essensys-hub/essensys-board-SC945D/docs/hardware.md

# Hardware

Cette section détaillera la conception matérielle du SC945D.

## Composants Clés
*   **Contrôleur Graphique** : 4D Systems PICASO-GFX2
*   **MCU** : *(À préciser)*
*   **Écran** : TFT Tactile 2.8"

## PCB
*(Images du routage ou stackup à ajouter)*
