essensys-hub/essensys-board-SC945D/docs/index.md

# SC945D - Écran Tactile Domotique

Bienvenue dans la documentation technique du module **SC945D**. Ce projet s'inscrit dans l'initiative **Open Source Hardware** d'Essensys.

Le SC945D est une interface utilisateur tactile compacte destinée au pilotage de la domotique.

## Aperçu - Schéma Électronique

<div style="display: flex; gap: 10px; overflow-x: auto; padding-bottom: 10px;">
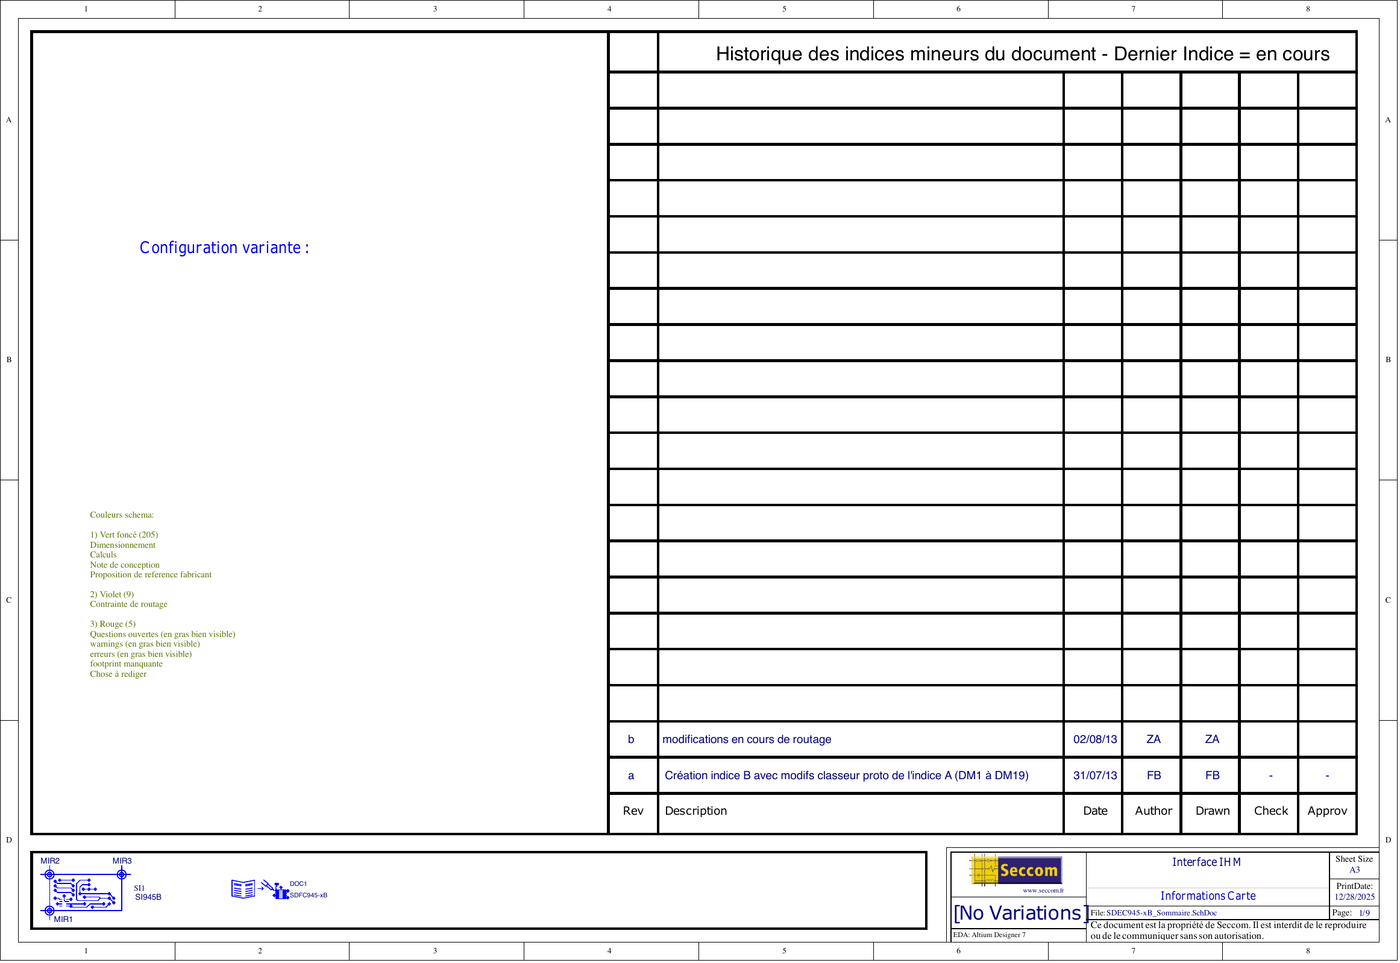
[picture p1: docs/assets/images/schematic-1.png]
Page 1
  
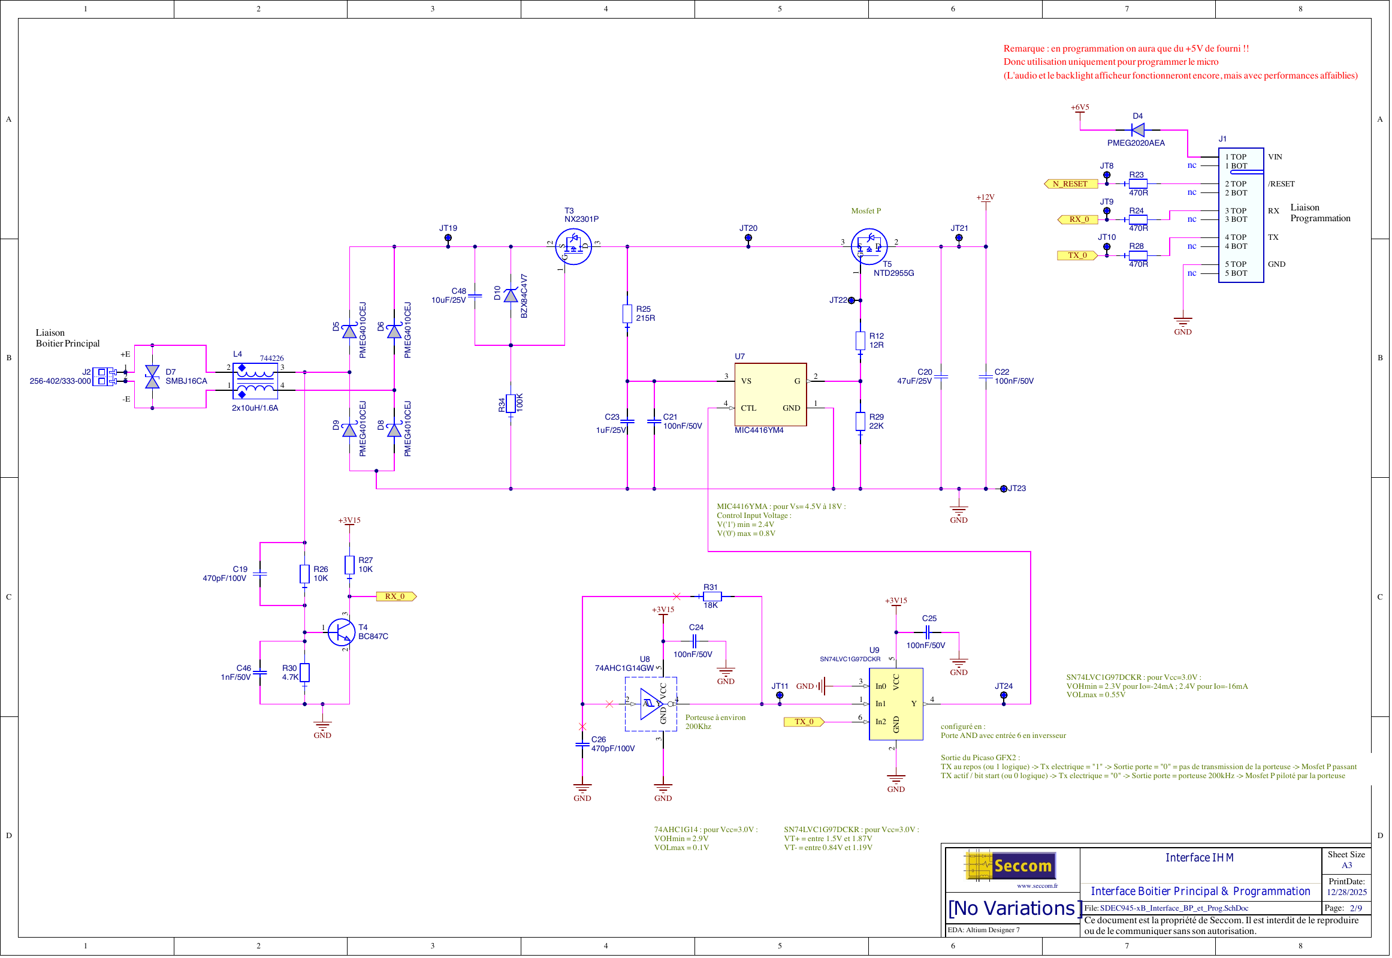
[picture p2: docs/assets/images/schematic-2.png]
Page 2
  
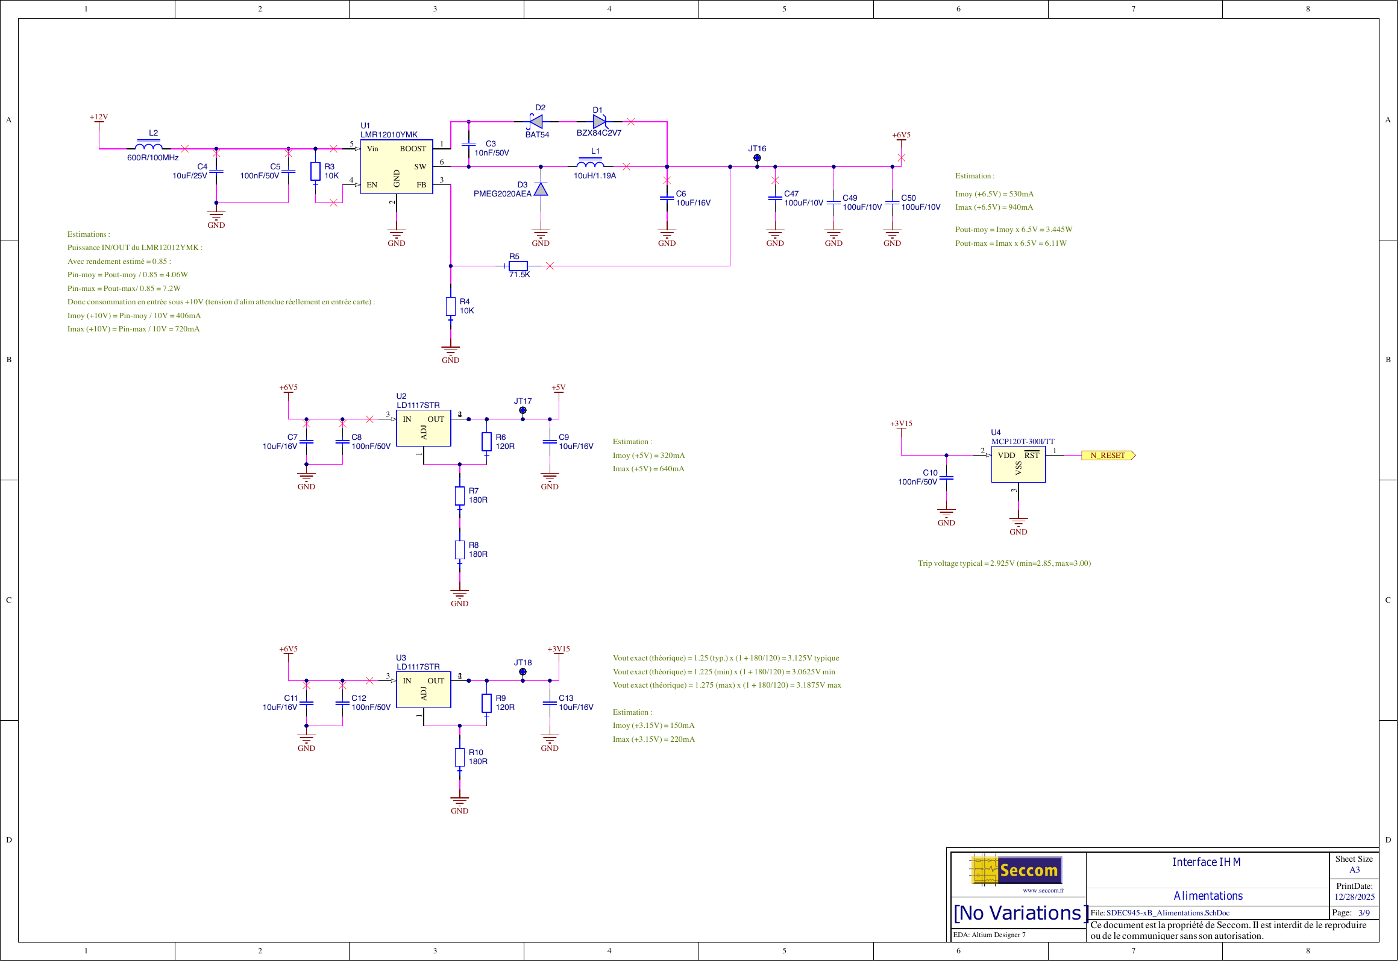
[picture p3: docs/assets/images/schematic-3.png]
Page 3
  
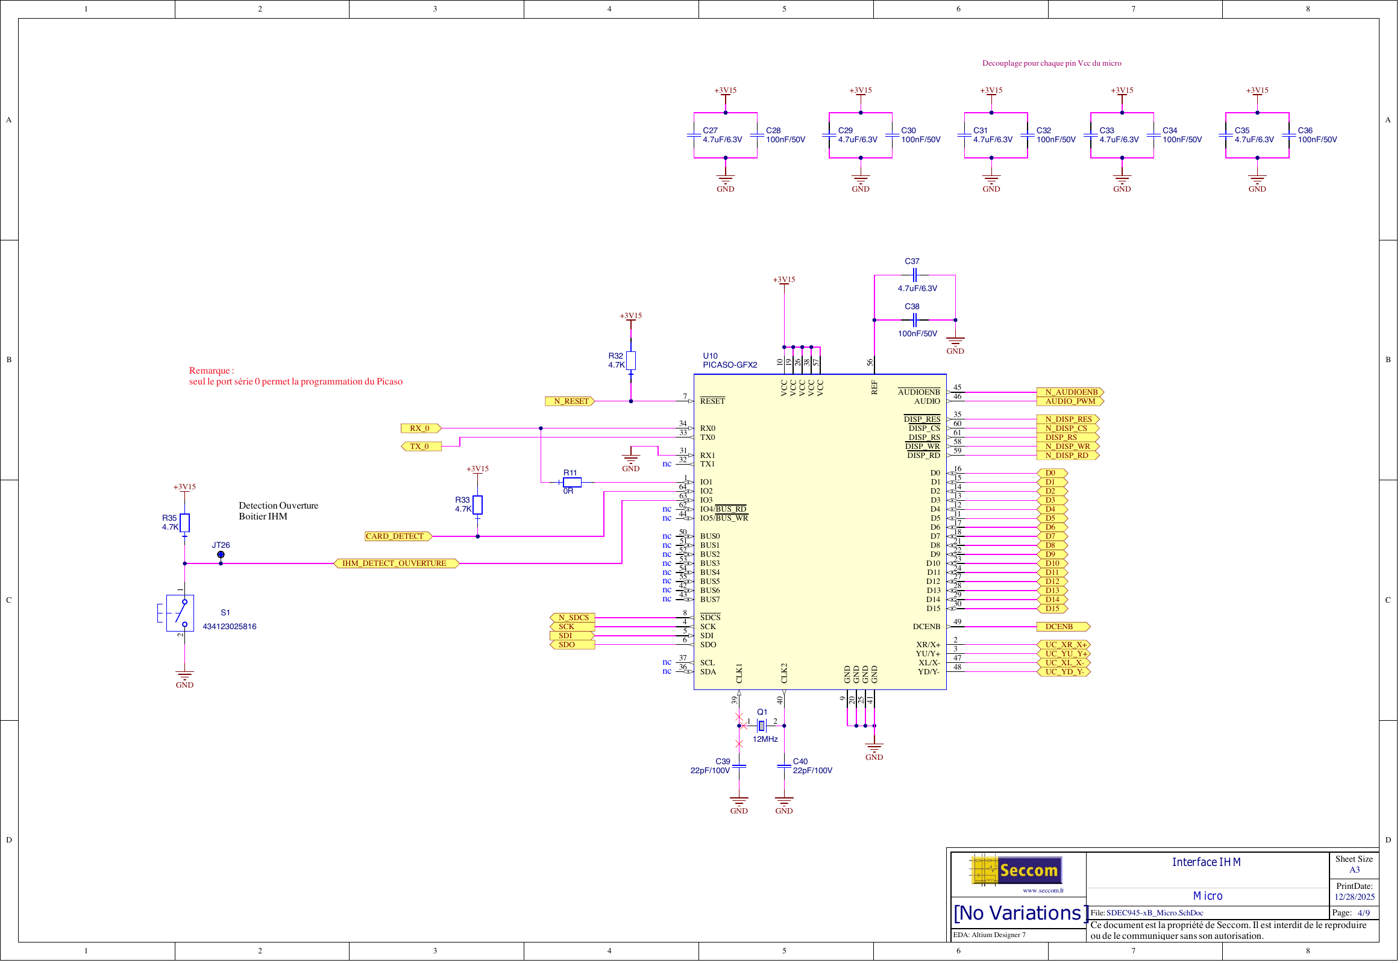
[picture p4: docs/assets/images/schematic-4.png]
Page 4
  
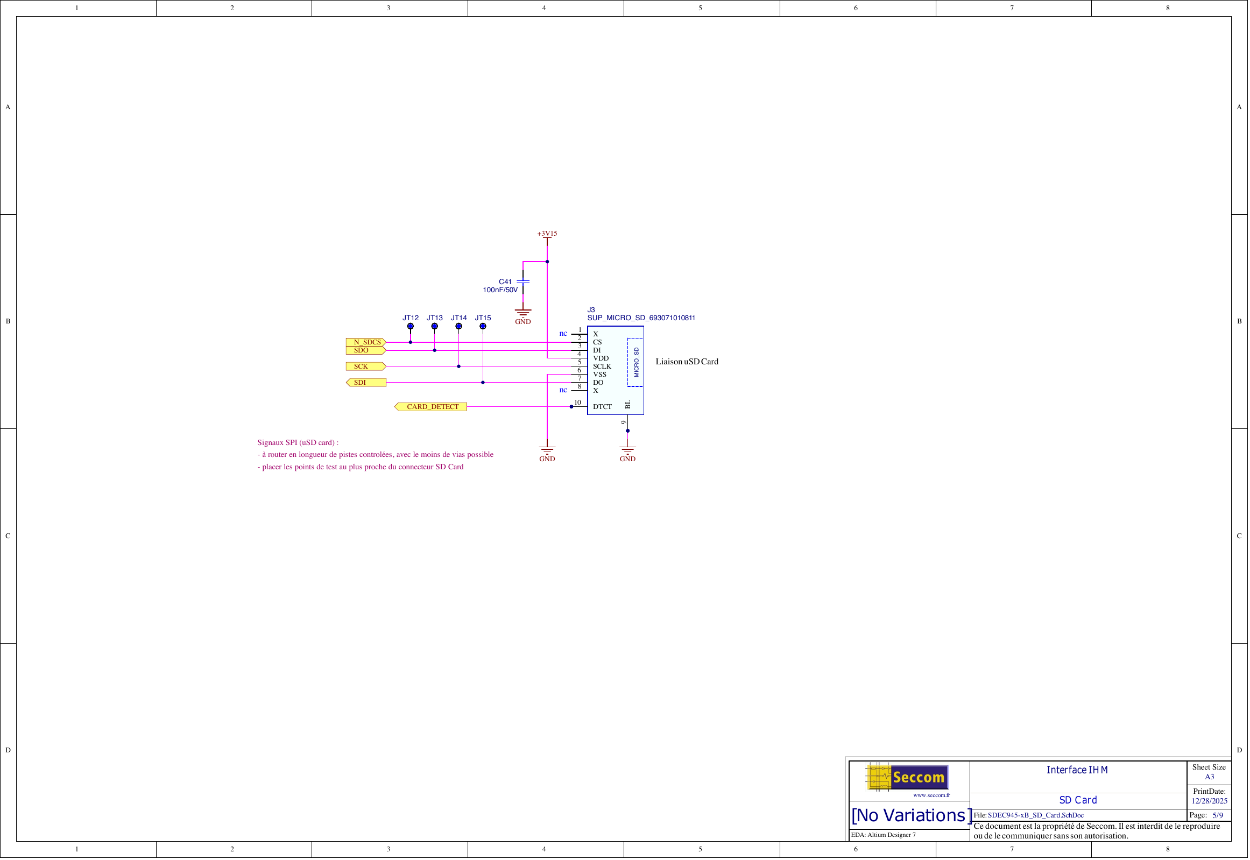
[picture p5: docs/assets/images/schematic-5.png]
Page 5
  
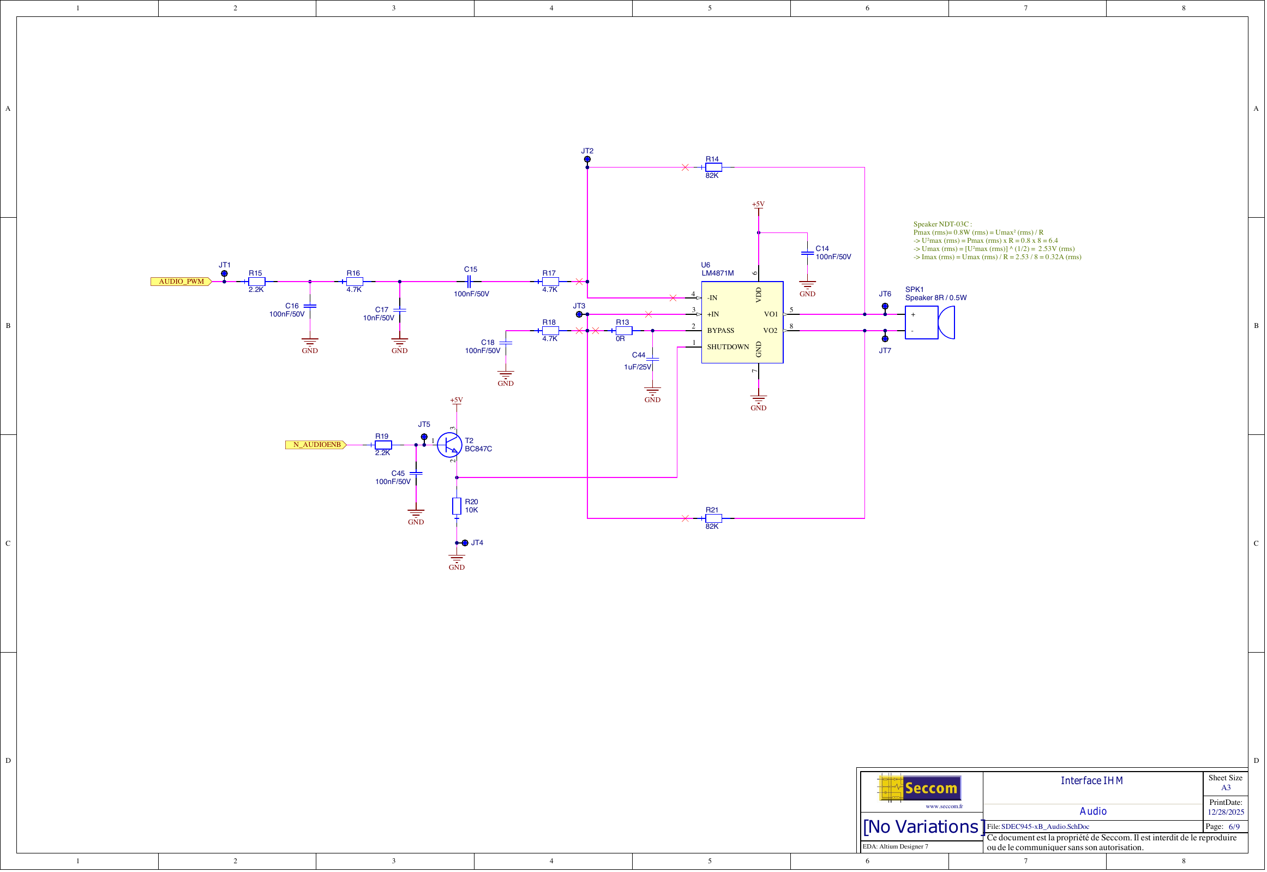
[picture p6: docs/assets/images/schematic-6.png]
Page 6
  
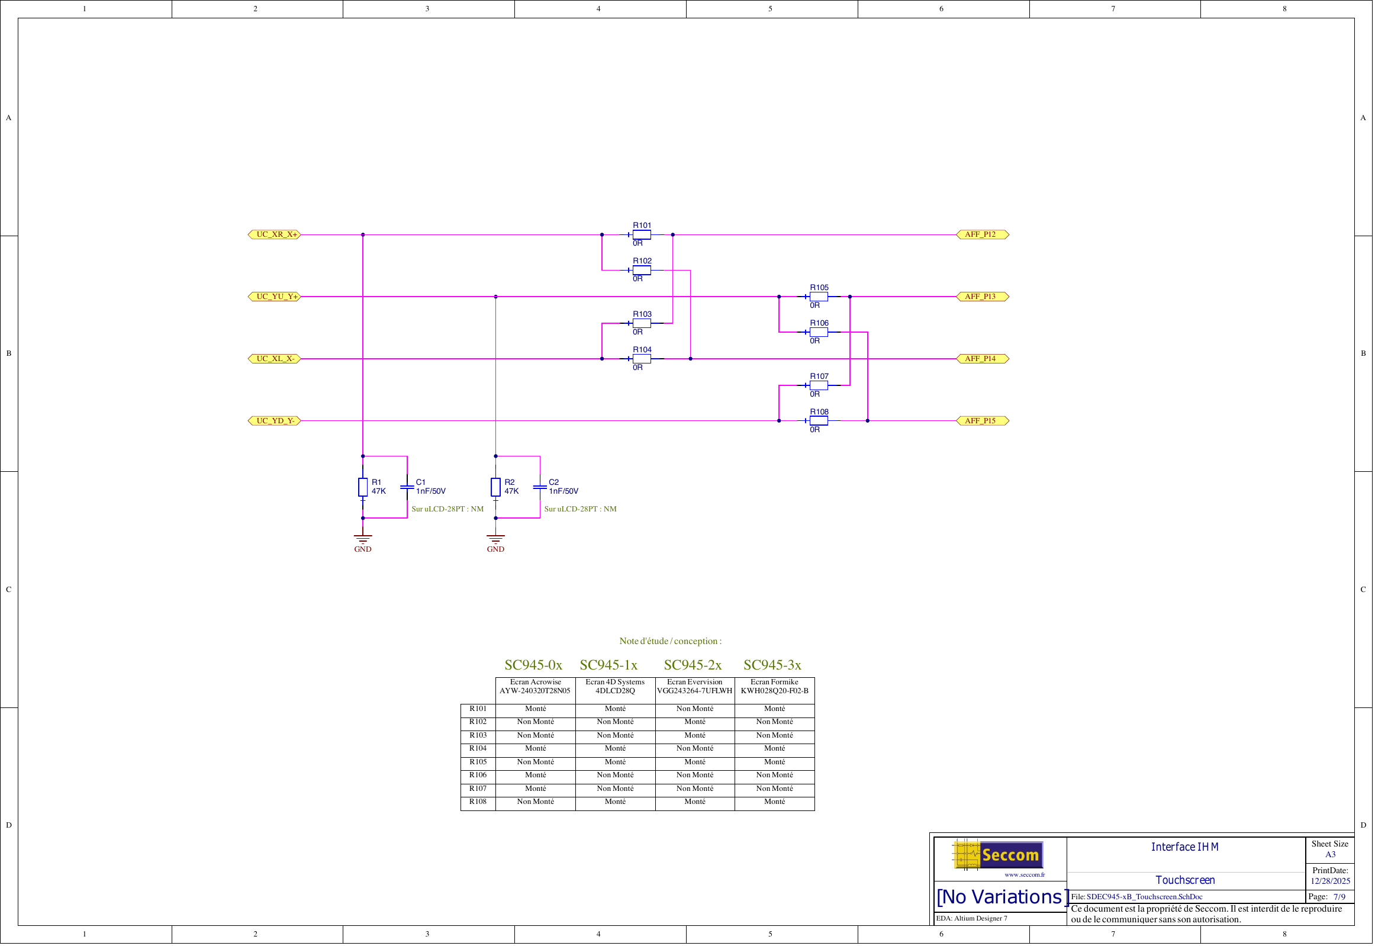
[picture p7: docs/assets/images/schematic-7.png]
Page 7
  
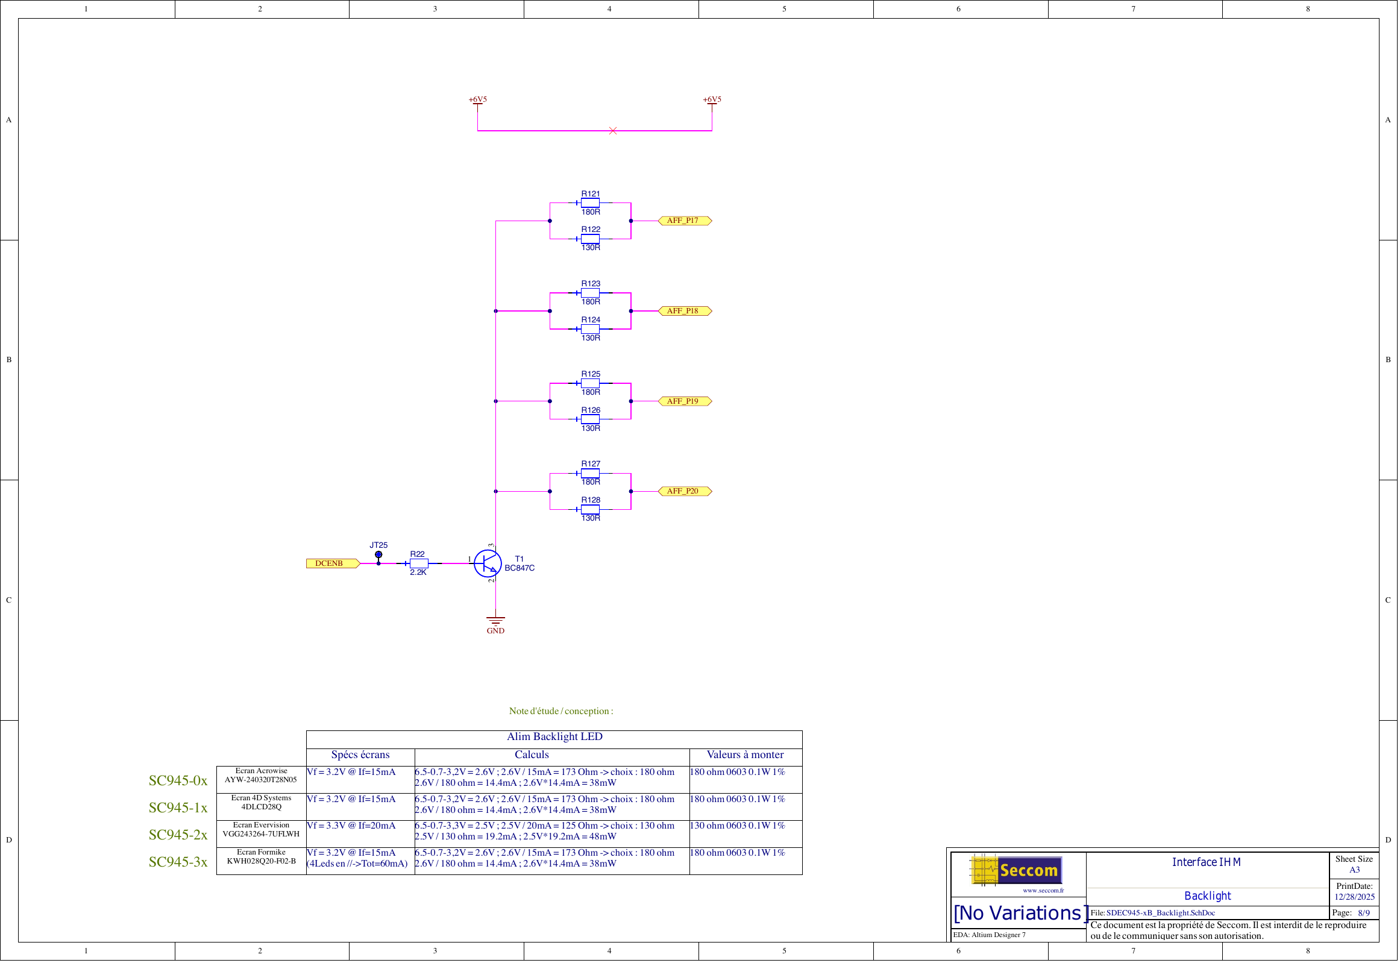
[picture p8: docs/assets/images/schematic-8.png]
Page 8
  
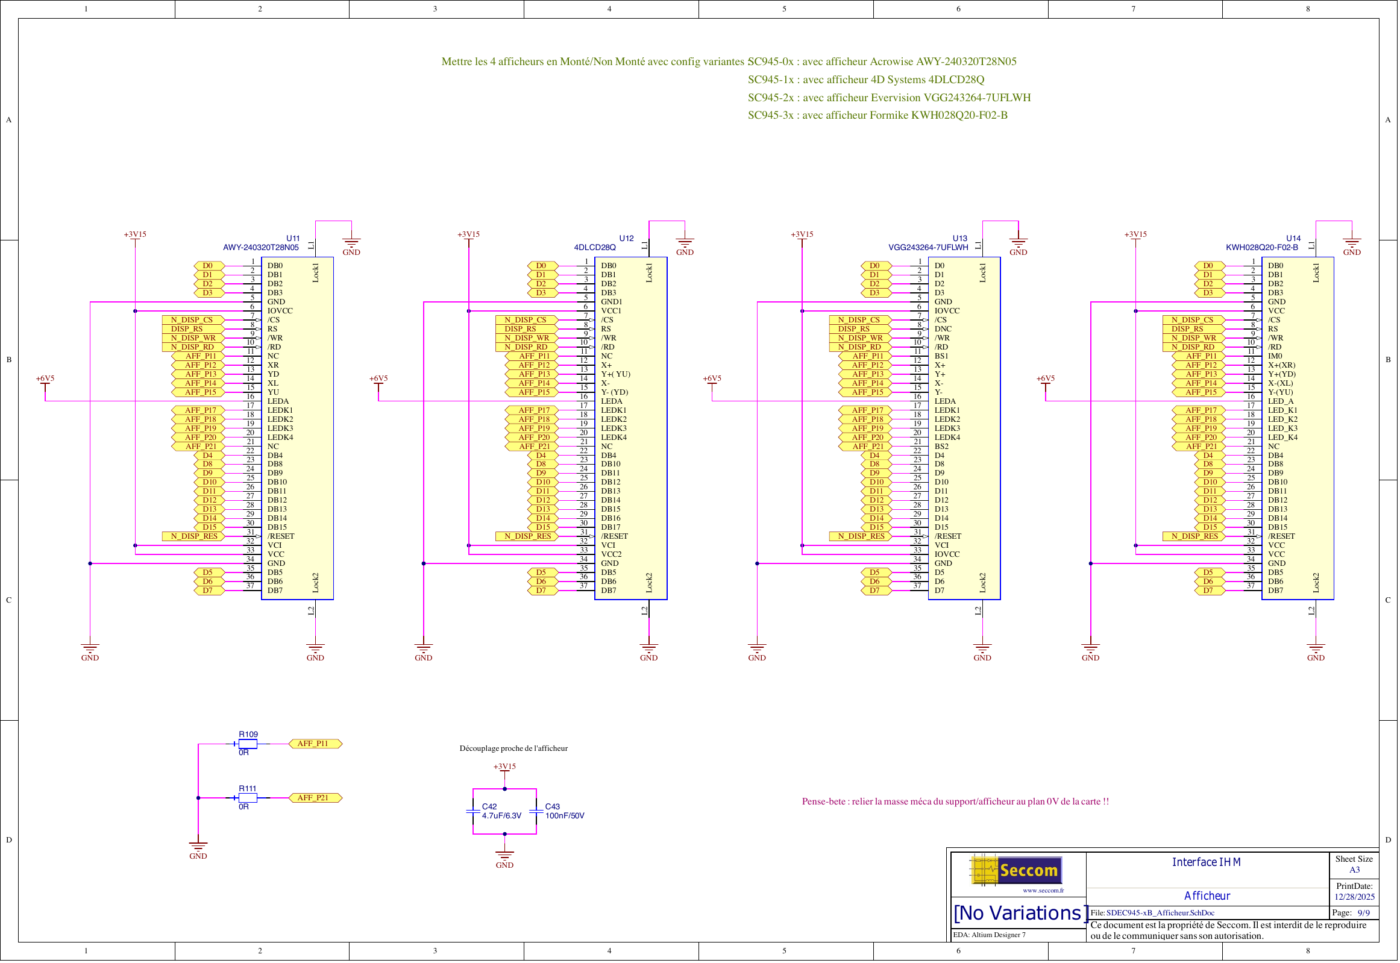
[picture p9: docs/assets/images/schematic-9.png]
Page 9
  
</div>

[Voir le schéma complet (PDF)](assets/SC945D_Schematic.pdf){ .md-button .md-button--primary }

## Aperçu - Assemblage

<div style="display: flex; gap: 10px; overflow-x: auto; padding-bottom: 10px;">
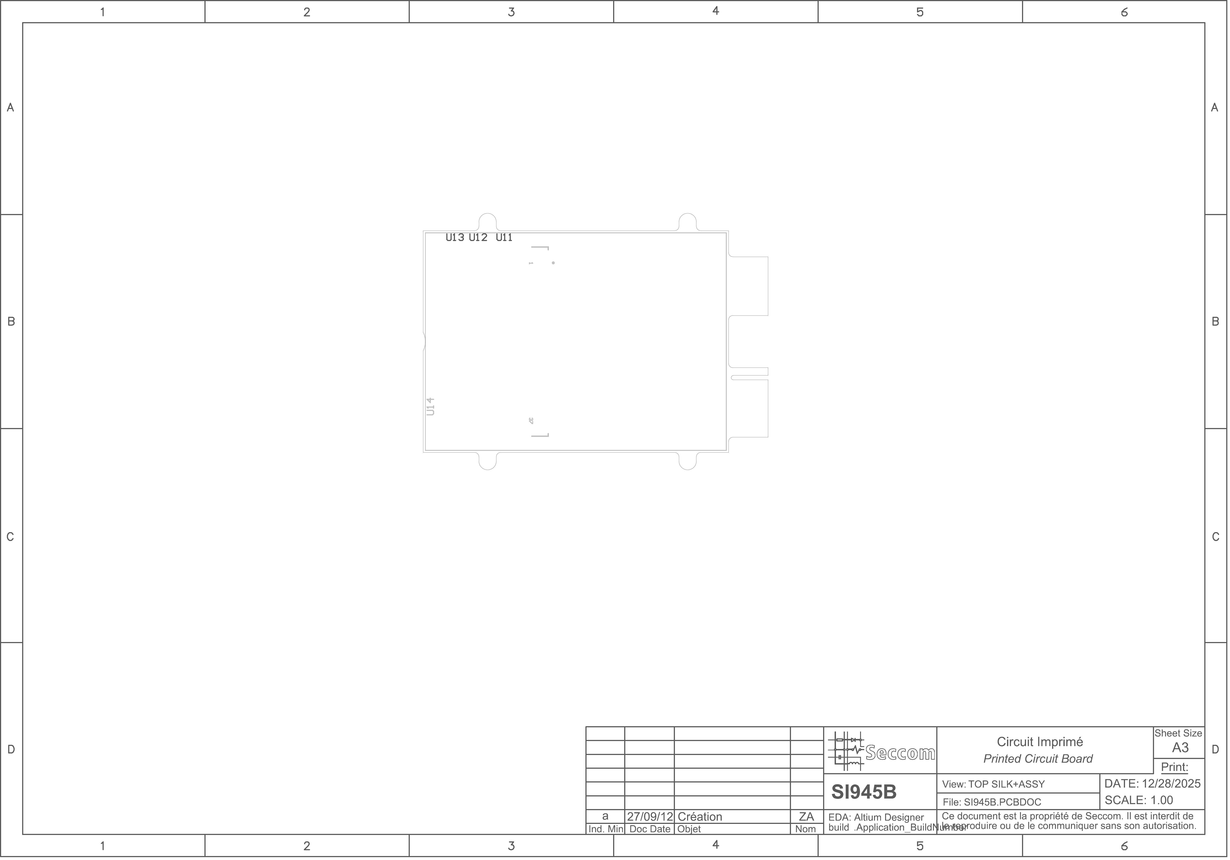
[picture p10: docs/assets/images/assembly-1.png]
Assy 1
  
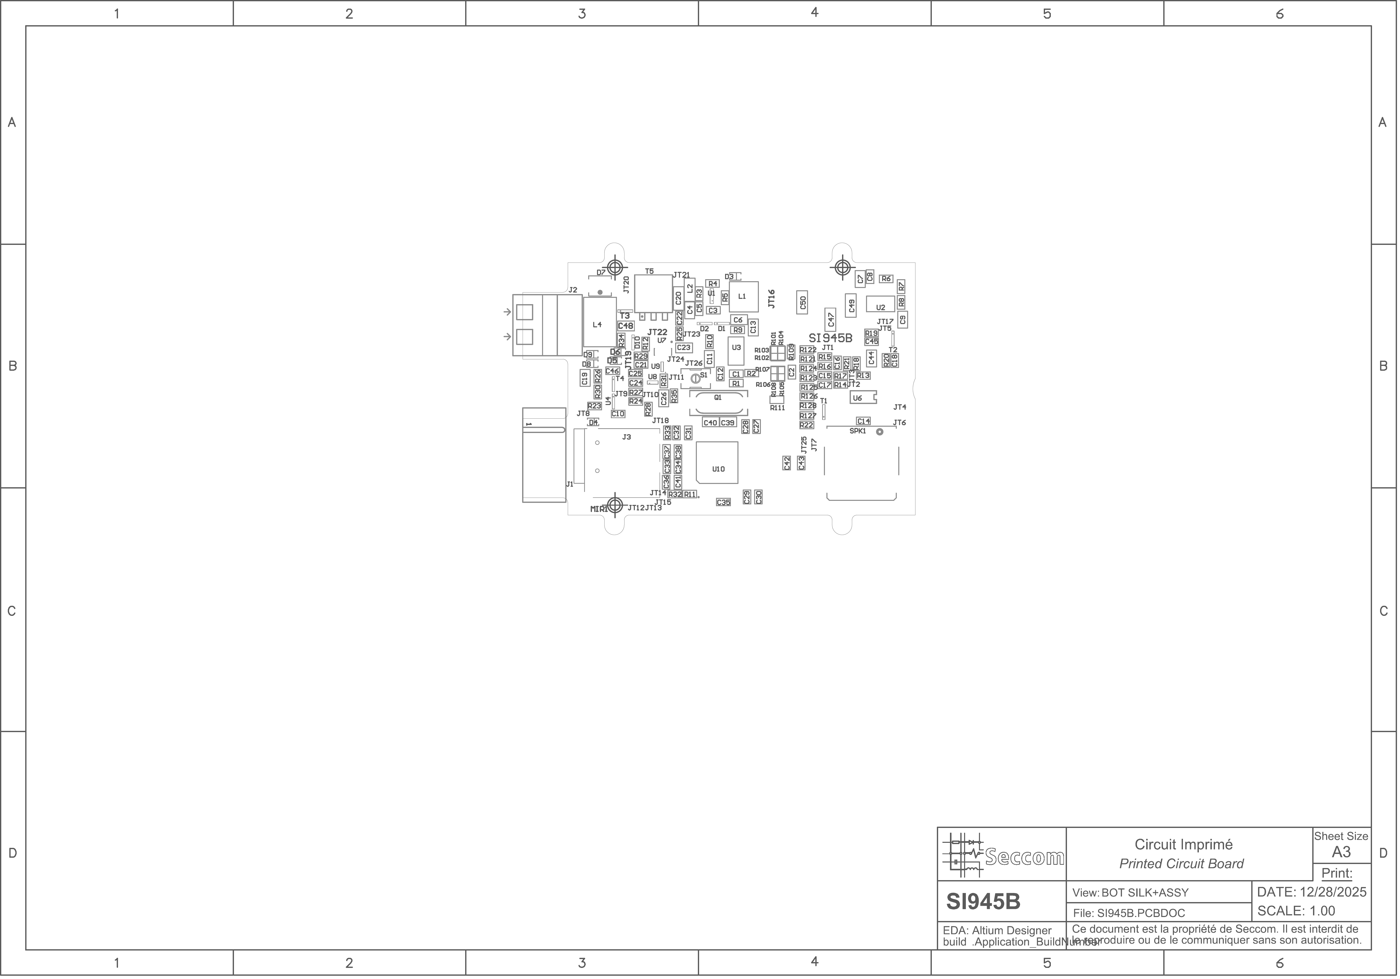
[picture p11: docs/assets/images/assembly-2.png]
Assy 2
  
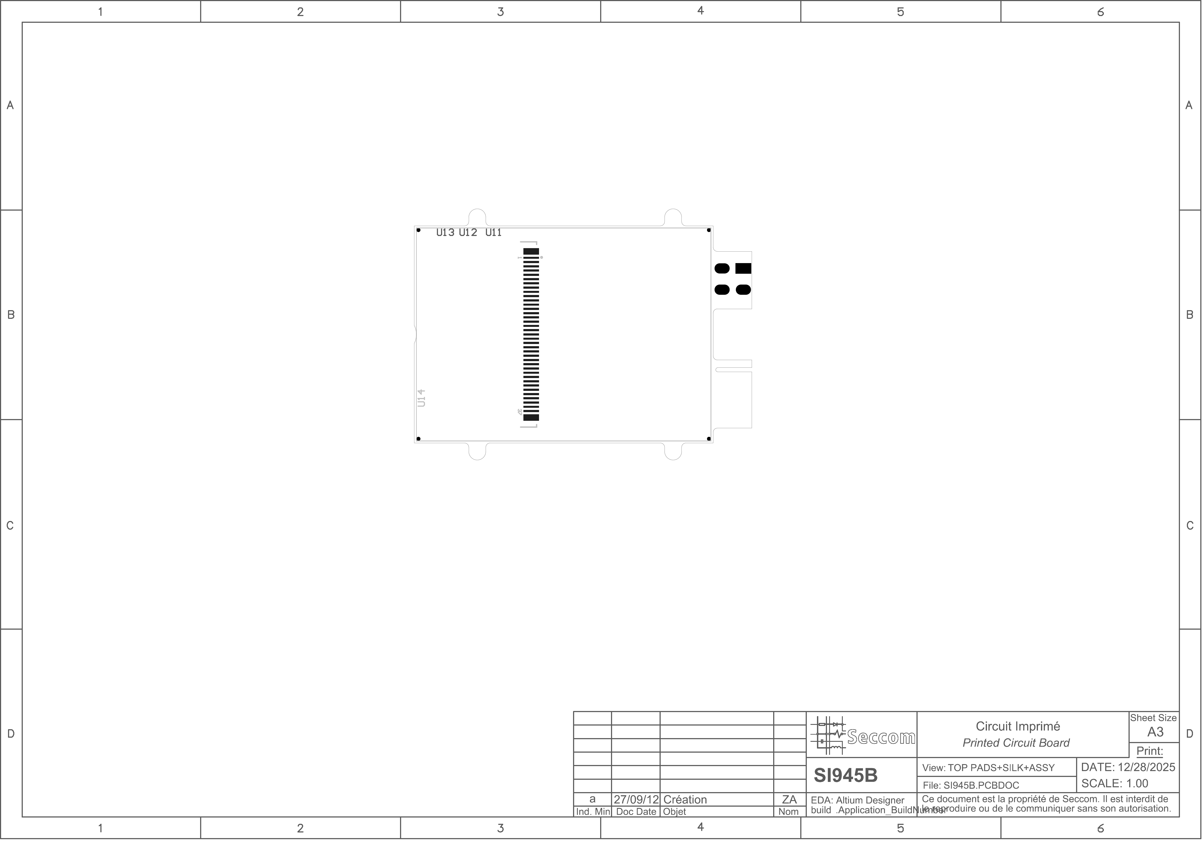
[picture p12: docs/assets/images/assembly-3.png]
Assy 3
  
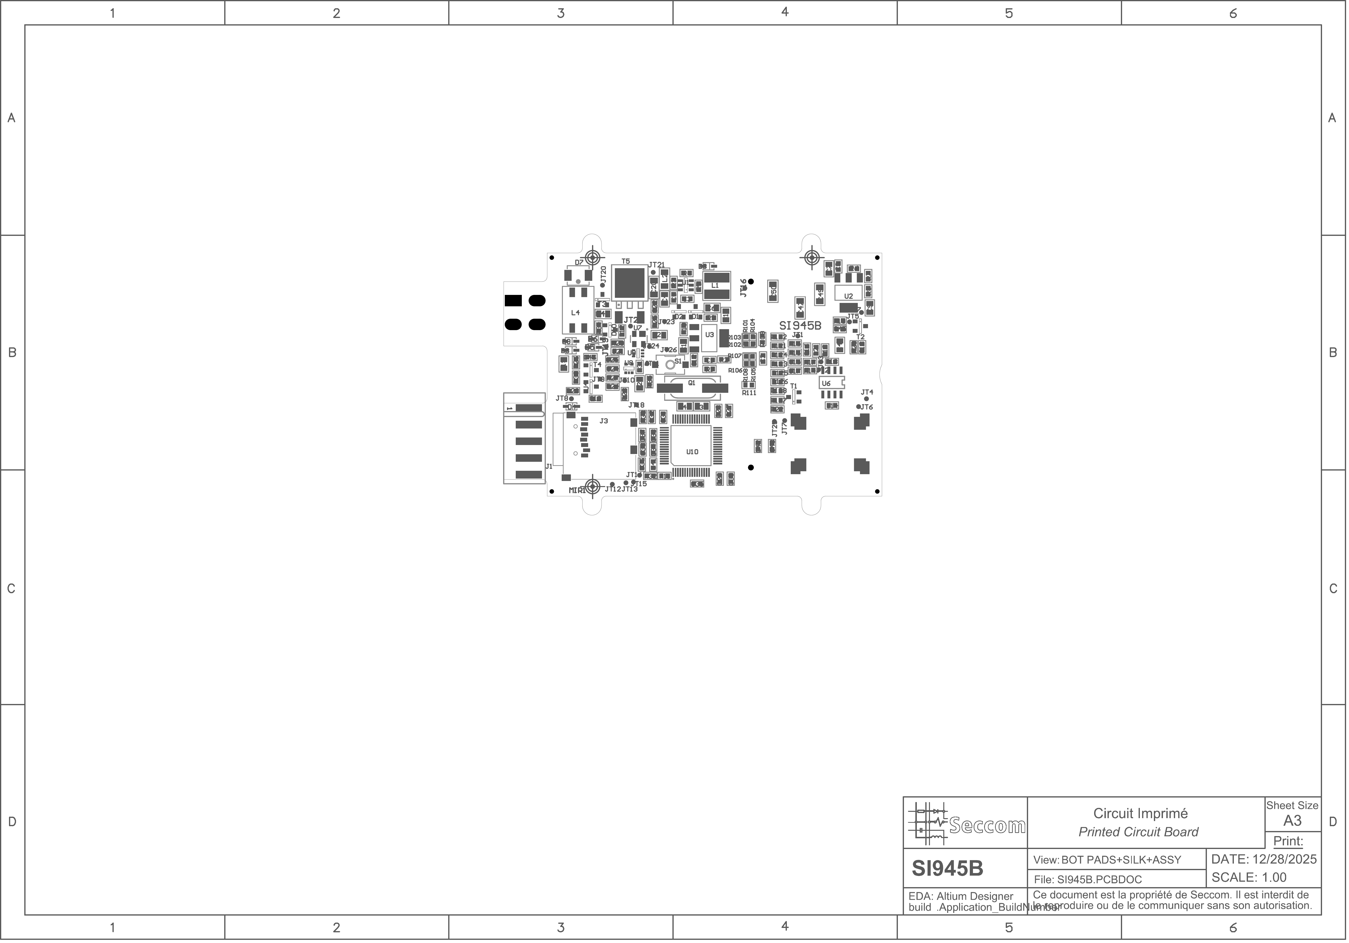
[picture p13: docs/assets/images/assembly-4.png]
Assy 4
  
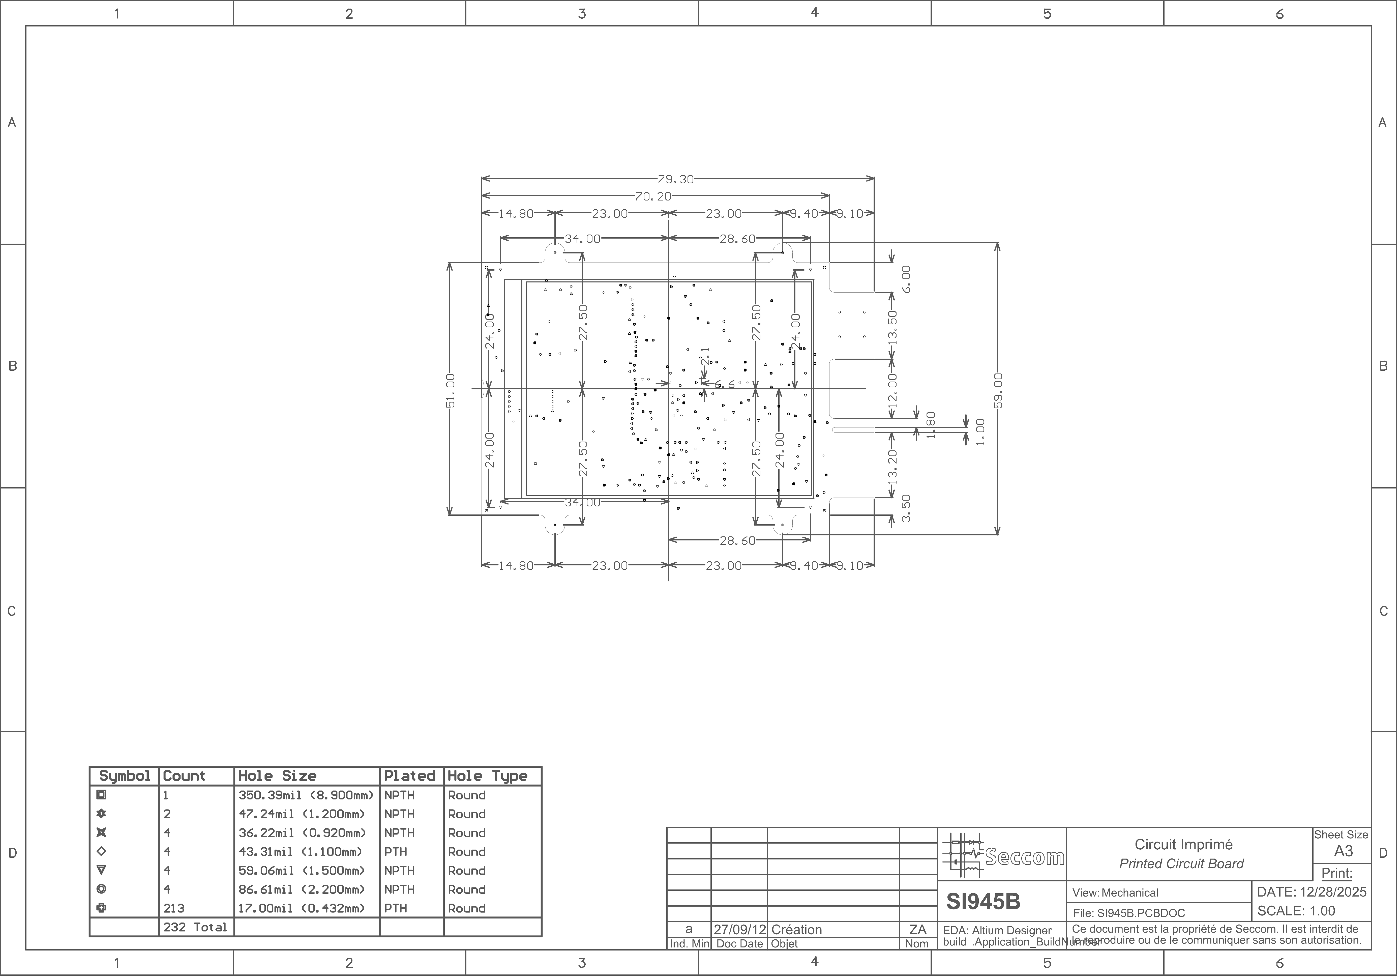
[picture p14: docs/assets/images/assembly-5.png]
Assy 5
  
</div>

## Documentation

Explorez les détails techniques du module :

*   [🏛️ Architecture](architecture.md) - Vue d'ensemble du système.
*   [🔌 Hardware](hardware.md) - Détails des composants et PCB.
*   [💾 Téléchargements](downloads.md) - Fichiers sources et fabrication.
*   [💻 Firmware](firmware.md) - Logiciel embarqué et PICASO-GFX2.
*   [🧠 Analyse Logicielle](firmware_logic.md) - Algorithmes et architecture modulaire (Mermaid).
