essensys-hub/essensys-board-SC945D/docs/downloads.md

# Téléchargements

Retrouvez ici tous les fichiers sources pour la fabrication et l'étude du module SC945D.

| Type | Description | Lien |
| :--- | :--- | :--- |
| 📂 **Schéma** | Schématique complet du circuit | [SC945D_Schematic.pdf](assets/pdfs/SC945D_Schematic.pdf) |
| 📦 **Modèle 3D** | Fichier STEP pour l'intégration mécanique | [SC945D.step](assets/models/SC945D.step) |
| 🏭 **Fabrication** | Archives Gerber pour la production PCB | [SC945D_Gerbers.zip](assets/manufacturing/SC945D_Gerbers.zip) |
| 🛠️ **Assemblage** | Plans d'assemblage | [Assembly.pdf](assets/pdfs/Assembly.pdf) |
