essensys-hub/essensys-board-SC945D/SC945D/_DM/Autres DM à voir.docx

Passer les 1206 en 1210 bcp + facile à appro dans ces niveaux de tension pour ces valeurs.

=> Les 3 100uF

=> Eventuellement es 2 22uF

Les 2 empreintes C20 et C48 qui sont sur la gen B et C et sur lesquelles on à mis 1 seule 47uF sur la gen. C.
