essensys-hub/essensys-board-SC945D/SC945D/_DM/DM2/DM2.docx

DM2

Pour des questions d'appros, on remplace :

TDK

C3216X5R1E226M160AB

Condensateur céramique, Y5V, -20%+80%, CMS 1206

22uF/25V

Par :

Murata

GRM31CR61E226KE15L

Condensateur céramique, X5R, 10%, CMS 1206

22uF/25V

Sur la génération actuelle :

Correction à la main en nomenclature.

Sur la prochaine génération :

Correction du schéma en CAO.
