essensys-hub/essensys-board-SC945D/SC945D/_DM/DM4/DM4.docx

DM4

Pour des questions de coût (> 2 x moins cher), de facilité d'appro (difficile de rentrer 47uF/25V dans du 1206 donc peu multisource), et d'homogénéité des nomenclatures (ça supprime une ref. dans le produit), on remplace C20 de 47uF/25V/1206 par 2 capas en parallèle C20+C48 de 22uF/25V/1206 car 2 empreintes 1206 en parallèle ont déjà été prévues.

Prix Mouser TDK C3216X5R1E476M au 24/03/2017 = 0,319 / 2000 x 1 = 0,319 / carte

Prix Mouser Murata GRM31CR61E226KE15L au 24/03/2017 = 0,134 / 2000 x 2 = 0,268 / carte

On remplace donc C20 :

TDK

C3216X5R1E476M

Condensateur céramique, X5R, 20%, CMS 1206

47uF/25V

Par C20+C48:

Murata

GRM31CR61E226KE15L

Condensateur céramique, X5R, 10%, CMS 1206

Code Sudelec 0008695

Sur la génération actuelle :

Correction à la main en nomenclature.

Sur la prochaine génération :

C'est déjà comme ça en CAO !
