essensys-hub/essensys-board-SC945D/docs/architecture.md

# Architecture Système

Vue d'ensemble de l'intégration du SC945D dans l'écosystème Essensys.

## Diagramme fonctionnel

*(Insérer diagramme mermaid ou image ici)*

## Rôle dans la Domotique
Le SC945D agit comme un point de contrôle local, permettant à l'utilisateur d'interagir avec les lumières, volets, et scénarios.
