essensys-hub/essensys-board-SC945D/SC945D/_DM/DM1/DM1.docx

DM1

Le speaker NDT-03C de Star Micronics ne semble plus fabriqué. Devant les difficultés d'approvisionnement, on renonce à la fonction audio de l'IHM qui en l'état n'est pas primordiale. On en profite pour faire une substentielle économie sur l'IHM en enlevant tous les composants servant à cette fonction.

Sur la génération actuelle :

Correction à la main sur le schéma.

Correction à la main en nomenclature.

Sur la prochaine génération :

Correction du chéma en CAO.
