essensys-hub/essensys-board-SC945D/SC945D/_DM/DM3/DM3.docx

DM3

La carte siffle au démarrage et lorsque l'écran est éteint.

Ca ressemble au pb de la génération précédente résolu par Olivier Guillet chez Seccom par l'adjonction d'un condensateur 22pF en parallèle de la résistance de pied R4 du LMR12010.

Bien qu'ayant réglé le pb sur la génération précédente, cela ne semble pas suffisant sur la série (disparité des composants ?).

Or la datasheet du LMR12010 spécifie une capa de pied entre 470pF et 1nF, ce qui est largement supérieur.

Après essai, le remplacement de C52 de 22pF par une 470pF résout le pb (sans pouvoir le caractériser faute de moyens de mesure appropriés).

On remplace donc C52 :

Kemet

C0805C220J1G

Condensateur céramique, NPO, 5%, CMS 0805

22pF/100V

Code Sudelec 0003864

Par : (déjà présent sur la carte par ailleurs)

Kemet

Condensateur céramique, NPO, 5%, CMS 0805

470pF/100V

Code Sudelec 0003937

Sur la génération actuelle :

Correction à la main en nomenclature.

Sur la prochaine génération :

Correction du schéma en CAO.
