essensys-hub/essensys-board-SC945D/SC945D/Gerbers/Panel/_Archives/EQ4 for SI945D reviewed.pdf

[Numéro de page]

### Nicolas GILLE (Valentinea)

‐ Is there some little holes to help breaking the holds ? I can't see them in the drl file :
‐‐‐ICAPE: Yes, there are holes, they are shown in the 2rd drill layer, please check.

‐ Why do you use a 2rd file ? Is it a drl file ? If yes, why not putting them in the drl file ?
‐‐‐ICAPE: we used the 2rd holes per our process requirement, we will do a second drilling process,
Yes, this is drill file, as there are twice drill process, so there are 1st and 2rd drill layer in our Gerber file,

‐ Why are those 4 holes not in the drl file ? :
‐‐‐ICAPE: these 4 holes are within 2rd drill file.

‐ Can you generate the panel bottom paste please ? See attached the unitary board bottom paste. ‐‐‐ICAPE: yes, please see attached update working gerber, please confirm if our working geber is ok?

‐ Can you make the pdf of the panelization same as 943D (see attached).
‐‐‐ICAPE: ok, see attached panel drawing.
