essensys-hub/essensys-board-SC945D/SC945D/Prog/_Archives/Fiche programmation uSD IHM v1.docx

FICHE DE PROGRAMMATION

Carte uSD IHM

- Formater la carte : choisir formatage rapide en FAT simple (16 bits).

=> 1s

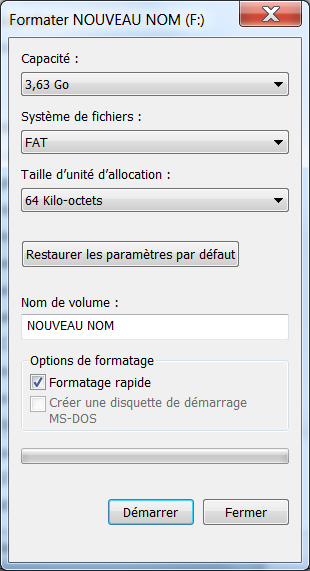
[picture p17: figure]

- Installer les fichiers sur la carte en lançant le fichier batch « Copy_uSD_Prod.bat ».

=>2mn28s
