essensys-hub/essensys-board-SC945D/SC945D/Gerbers/Panel/_Archives/SI945 panel layout v3.pdf

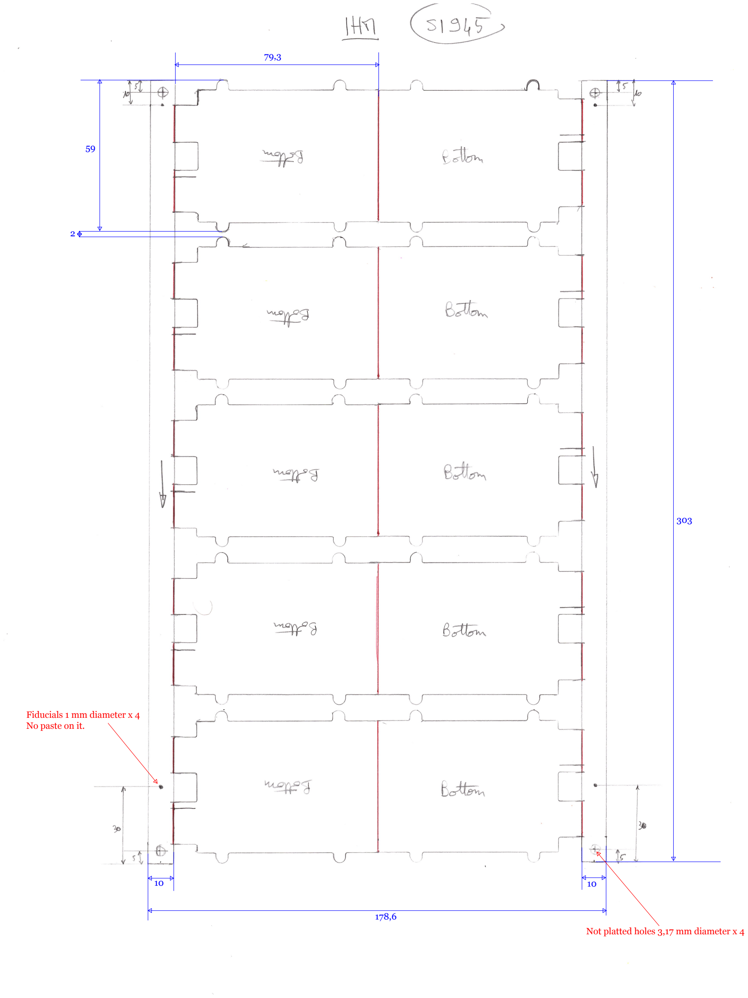
[picture p18: page 1]
