essensys-hub/essensys-board-SC945D/SC945D/Prog/Fiche de programmation SC945D.docx/20 - 20170313_153906.jpg

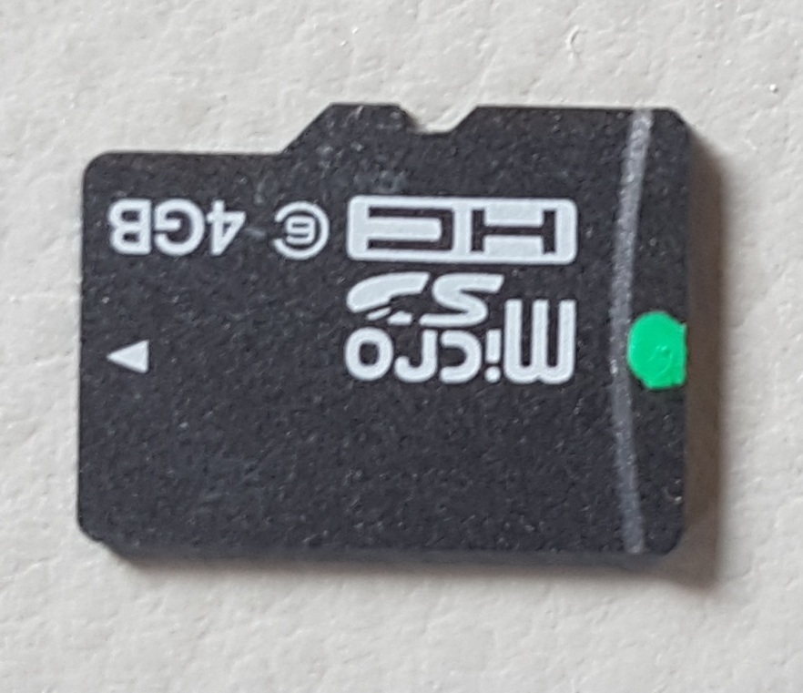
SC945D/Prog/Fiche de programmation SC945D.docx/20 - 20170313_153906.jpg
