essensys-hub/essensys-board-SC945D/SC945D/Prog/Fiche de programmation SC945D.docx/30 - 20170323_100202.jpg

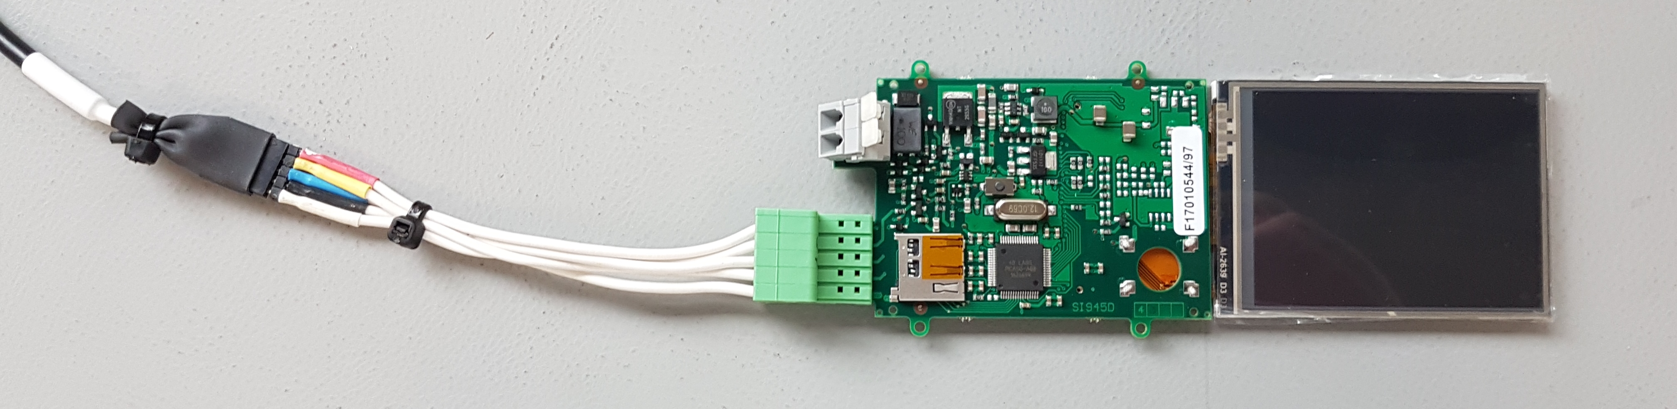
SC945D/Prog/Fiche de programmation SC945D.docx/30 - 20170323_100202.jpg
