essensys-hub/essensys-board-SC945D/SC945D/Prog/Fiche de programmation SC945D.docx/40 - Capturer.JPG

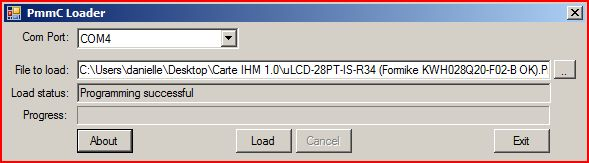
SC945D/Prog/Fiche de programmation SC945D.docx/40 - Capturer.JPG
