essensys-hub/essensys-board-SC945D/SC945D/Prog/Fiche de programmation SC945D.docx/60 - Capturer2.JPG

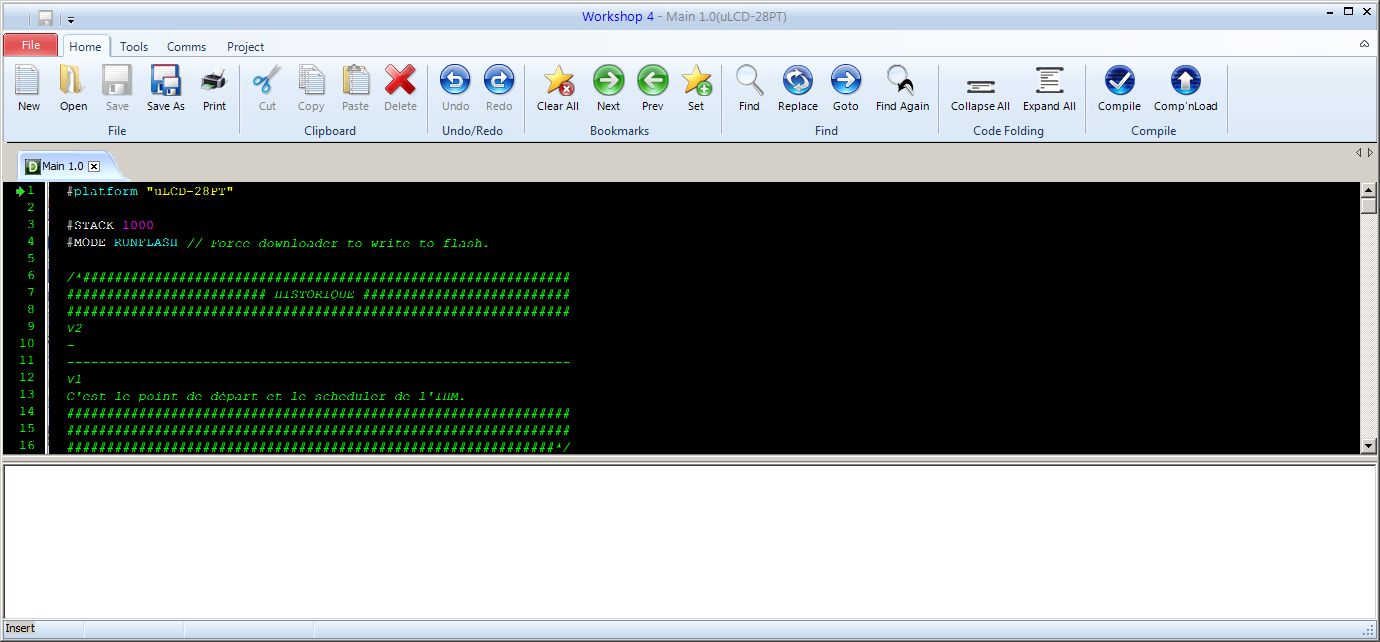
SC945D/Prog/Fiche de programmation SC945D.docx/60 - Capturer2.JPG
