essensys-hub/essensys-board-SC945D/SC945D/Assembly/SC945D_BOM_Formaté (DM).xlsx

Description | Fabricant | Ref Fab | Value | Quantity | Designator | Footprint
Circuit imprimé | Valentinea | SI945D | - | 1 | SI1 | CIRCUIT_IMPRIME_SI_STD
Afficheur tactile, TFT, taille 2.8p, 240x320p, bus CPU 16 bits, dale résistive 4 fils, backlight 4 Leds, nappe à souder 37pts pas 1mm | Formike Electronic | KWH028Q20-F02-B | - | 1 | U14 | AFFICHEUR_50x69.2_FPC37_e1MM
Résistance CMS 0603, 0.100W, 1%, 100ppm, 75V | Vishay | CRCW06030000Z0EA | 0R | 6 | R101, R104, R105, R108, R109, R111 | 0603_ReflowSoldering_RES
Résistance CMS 0603, 0.100W, 1%, 100ppm, 75V | Vishay | CRCW060312R0FKEA | 12R | 1 | R12 | 0603_ReflowSoldering_RES
Résistance CMS 0603, 0.100W, 1%, 100ppm, 75V | Vishay | CRCW0603120RFKEA | 120R | 1 | R9 | 0603_ReflowSoldering_RES
Résistance CMS 0603, 0.100W, 1%, 100ppm, 75V | Vishay | CRCW0603180RFKEA | 180R | 5 | R10, R121, R123, R125, R127 | 0603_ReflowSoldering_RES
Résistance CMS 0603, 0.100W, 1%, 100ppm, 75V | Vishay | CRCW0603215RFKEA | 215R | 1 | R25 | 0603_ReflowSoldering_RES
Résistance CMS 0603, 0.100W, 1%, 100ppm, 75V | Vishay | CRCW0603470RFKEA | 470R | 3 | R23, R24, R28 | 0603_ReflowSoldering_RES
Résistance CMS 0603, 0.100W, 1%, 100ppm, 75V | Vishay | CRCW06032K20FKEA | 2.2K | 1 | R22 | 0603_ReflowSoldering_RES
Résistance CMS 0603, 0.100W, 1%, 100ppm, 75V | Vishay | CRCW06033K30FKEA | 3.3K | 1 | R34 | 0603_ReflowSoldering_RES
Résistance CMS 0603, 0.100W, 1%, 100ppm, 75V | Vishay | CRCW06034K70FKEA | 4.7K | 4 | R30, R32, R33, R35 | 0603_ReflowSoldering_RES
Résistance CMS 0603, 0.100W, 1%, 100ppm, 75V | Vishay | CRCW060310K0FKEA | 10K | 4 | R3, R4, R26, R27 | 0603_ReflowSoldering_RES
Résistance CMS 0603, 0.100W, 1%, 100ppm, 75V | Vishay | CRCW060318K0FKEA | 18K | 1 | R31 | 0603_ReflowSoldering_RES
Résistance CMS 0603, 0.100W, 1%, 100ppm, 75V | Vishay | CRCW060322K0FKEA | 22K | 1 | R29 | 0603_ReflowSoldering_RES
Résistance CMS 0603, 0.100W, 1%, 100ppm, 75V | Vishay | CRCW060347K0FKEA | 47K | 2 | R1, R2 | 0603_ReflowSoldering_RES
Résistance CMS 0603, 0.100W, 1%, 100ppm, 75V | Vishay | CRCW060371K5FKEA | 71.5K | 1 | R5 | 0603_ReflowSoldering_RES
Condensateur céramique, NPO, 5%, CMS 0805 | Kemet | C0805C220J1G | 22pF/100V | 2 | C39, C40 | 0805_ReflowSoldering_CAP
Condensateur céramique, NPO, 5%, CMS 0805 | Kemet | C0805C471J1G | 470pF/100V | 4 | C19, C26, C51, C52 | 0805_ReflowSoldering_CAP
Condensateur céramique, X7R, 10%, CMS 0603 | Kemet | C0603C103K5RAC | 10nF/50V | 1 | C3 | 0603_ReflowSoldering_CAP
Condensateur céramique, X7R, 10%, CMS 0603 | Kemet | C0603C104K5RAC | 100nF/50V | 15 | C5, C10, C12, C21, C22, C24, C25, C28, C30, C32, C34, C36, C38, C41, C43 | 0603_ReflowSoldering_CAP
Condensateur céramique, X5R, 10%, CMS 0805 | Kemet | C0805C105K3PAC | 1uF/25V | 1 | C23 | 0805_ReflowSoldering_CAP
Condensateur céramique, X5R, 10%, CMS 0603 | Kemet | C0603C475K9PAC | 4.7uF/6.3V | 7 | C27, C29, C31, C33, C35, C37, C42 | 0603_ReflowSoldering_CAP
Condensateur céramique, X5R, 10%, CMS 0805 | Kemet | C0805C106K4PAC | 10uF/16V | 3 | C6, C11, C13 | 0805_ReflowSoldering_CAP
Condensateur céramique, X5R, 10%, CMS 0805 | Murata | GRM21BR61E106KA73L | 10uF/25V | 1 | C4 | 0805_ReflowSoldering_CAP
Condensateur céramique, X5R, 10%, CMS 1206 | Murata | GRM31CR61E226KE15L | 22uF/25V | 2 | C20, C48 | 1206_ReflowSoldering_CAP
~~Condensateur céramique, X5R, 20%, CMS 1206~~ Condensateur céramique, X5R, 20%, CMS 1210 | ~~TDK~~ Yageo | ~~C3216X5R1A107M160AC~~ CC1210MKX5R6BB107 | 100uF/10V | 3 | C47, C49, C50 | 1206_ReflowSoldering_CAP 1210 sur empreinte 1206
Inductance bobinée CMS, 10uH +/- 10%, I=1.19A, Rdc=0.095R, SRF=40MHz, -40/+85°C | Wurth Elektronik | 744043100 | 10uH/1.19A | 1 | L1 | SELF_WE-TPC_4.8x4.78_(type4828)
Self de mode commun, 2x10uH, 42Vac/80Vdc, 1.6A, serie WE-SL2, -40/+125°C, CMS | Wurth Elektronik | 744226 | 2x10uH/1.6A | 1 | L4 | SELF_WE-SL2_9.2x6
Ferrite multicouches CMS, imp=600R@100MHz, +/-25%, Rdc=100mR, I=2A | Wurth Elektronik | 74279218 | 600R/100MHz | 1 | L2 | 1206_ReflowSoldering_FERRITE
Quartz CMS série HCM49 (équiv HC49/US), -10/+60°C, +/-30ppm, 18pF | Citizen | HCM49 12.000MABJ-UT | 12MHz | 1 | Q1 | QUARTZ_HC49_11.5X5_CMS
Diode Schottky double, BAT54 cathode com, Vrrm=30V, If=300mA, Vf=0.4Vmax, CMS | NXP | BAT54C | - | 2 | D2, D10 | SOT23_3L_ReflowSoldering
Diode Schottky, Vrrm=20V, If=2A, Vf=450mV, CMS | NXP | PMEG2020AEA | - | 2 | D3, D4 | SOD323_ReflowSoldering
Diode Schottky, Vrrm=40V, If=1A, Vf=0.49V, CMS, -65/+150°C | NXP | PMEG4010CEJ | - | 4 | D5, D6, D8, D9 | SOD323_ReflowSoldering
Diode Zener, série BZX84C, 0.3W, +/-5%, CMS | NXP | BZX84C2V7 | 2,7V | 1 | D1 | SOT23_3L_ReflowSoldering
Diode Transil/TVS bidirectionnelle (CA), 600W, 16V, CMS, serie SMBJ | Bourns | SMBJ16CA | 16V | 1 | D7 | DO214AA-SMB-NP_ReflowSoldering
Transistor NPN, Vce=50V, Ic=0.1A, hfe=420~800, 0.25W, CMS | NXP | BC847C | - | 2 | T1, T4 | SOT23_3L_ReflowSoldering
Transistor PNP, Vce=-60V, Ic=-4A, Rdson 0.080r, -55 à 150°C, CMS | ON Semi | NSS60200LT1G | - | 1 | T3 | SOT23_3L_ReflowSoldering
Transistor MOSP, Vdss=60V, Id=12A, Rdson=0.155R, -55/+175°C, CMS | ON Semiconductor | NTD2955G | - | 1 | T5 | DPAK
Inverseur simple, Trigger de Schmitt, AHC, Picogate, CMS | NXP | 74AHC1G14GW | - | 1 | U8 | SOT353
Porte logique multifonction, AND/OR/NAND/NOR/INV/BUFFER, LVC, CMS SC70_6 | Texas Instruments | SN74LVC1G97DCKR | - | 1 | U9 | SC70_6
~~Régulateur de tension ajustable positif, 1.25~15V, 0.8A, LDO (1V), Vin=15Vmax, 0/+125°C, CMS~~ Régulateur de tension ajustable positif, 1.25~15V, 0.8A, LDO (1V), Vin=15Vmax, -40/+125°C, CMS | ST Microelectronics | ~~LD1117STR~~ LD1117SC-R | - | 1 | U3 | SOT223
Régulateur ajustable step down, 0.8~20V, 1A, Vin=3~20V, -40/+125°C, CMS | National Semiconductor | LMR12010YMK | - | 1 | U1 | SOT23_6L
Low side MOSFET Driver ,+4.5V to +18V,1.2A peak, non-inverting, -40/+85°C, CMS | Micrel | MIC4416YM4 | - | 1 | U7 | SOT143
Microcontroller Supervisory Circuit with Open Drain Output, Active Low, 2.925V trip point | Microchip | MCP120T-300I/TT | - | 1 | U4 | SOT23_3L_ReflowSoldering
Contrôleur ASIC graphique & audio 4DGL intégré, pour écrans OLED/LCD/TFT couleurs tactiles, 16bits, CMS | 4D Systems | PICASO-GFX2 | - | 1 | U10 | QFP_064_E0,50_10X10MM
Bouton poussoir, CI, 1 circuit, ON/MOM, droit, tactile, 50mA/12V, -40/+85°C, noir, CMS | Wurth Elektronik | 434123025816 | - | 1 | S1 | SWITCH_ON_MOM_WS_TRS_CMS
Bornier à levier pour CI, e5.08, 2pts, 45 degrés, 300V/15A, AWG 28-12, Gris | Wago | 256-402/333-000 | - | 1 | J2 | BVIS_02_WAGO_256-402/333-000
Embase pour Micro SD Card, 8 points, blindée, fixation Push-Push, noir, -25/+85°C, CMS | Wurth Elektronik | 693071010811 | - | 1 | J3 | SUP_MICRO_SD_BL_PUSH-PUSH_693071010811+USD
Carte uSD HC 4Go | Kingston | SDC4/4GBSP | - | 1 | - | Composant à programmer avant montage
