essensys-hub/essensys-board-SC945D/SC945D/3D/SC945D/D7.sldasm

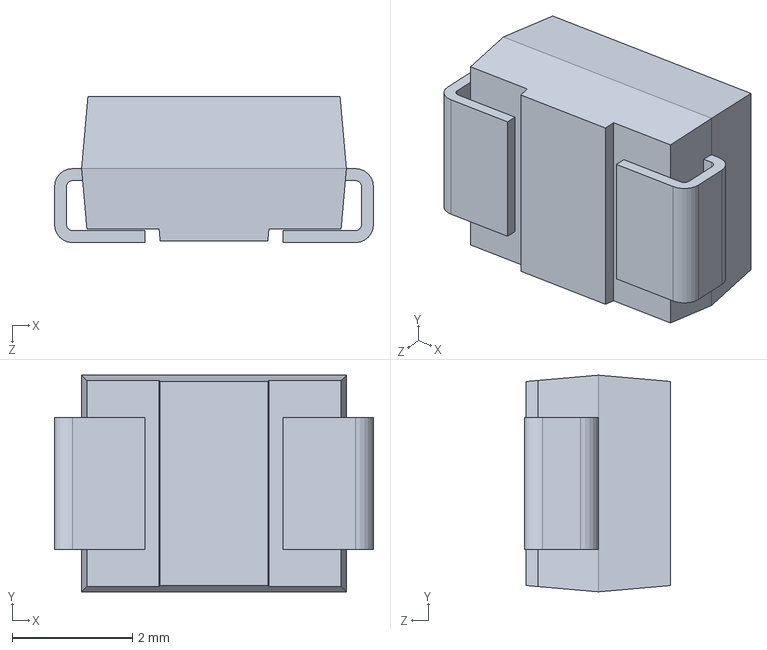
[picture p27: CAD file, 2025-12-28]
SC945D/3D/SC945D/D7.sldasm
5.30 x 3.60 x 2.43 mm
