essensys-hub/essensys-board-SC945D/SC945D/3D/SC945D/U8.sldasm

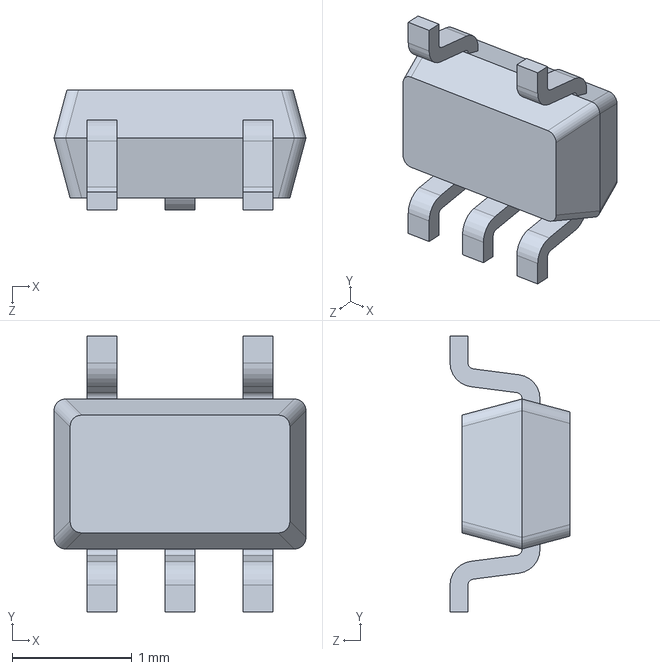
[picture p28: CAD file, 2025-12-28]
SC945D/3D/SC945D/U8.sldasm
2.10 x 2.30 x 1.00 mm
