essensys-hub/essensys-board-SC945D/SC945D/3D/SC945D/L2.sldasm

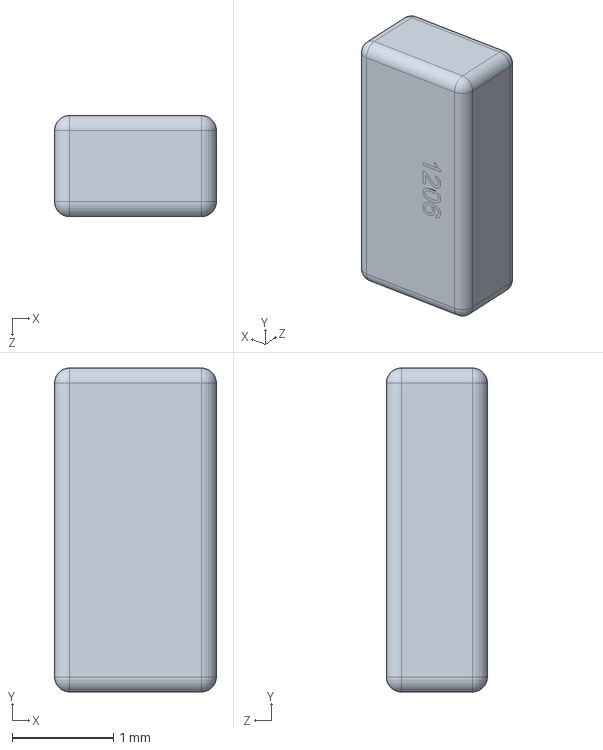
[picture p29: CAD file, 2025-12-28]
SC945D/3D/SC945D/L2.sldasm
1.60 x 3.20 x 1.00 mm
