essensys-hub/essensys-board-SC945D/SC945D/3D/SC945D/pins_1.sldprt

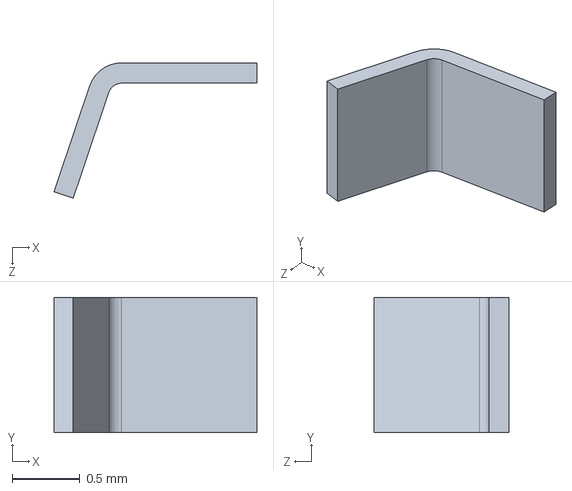
[picture p30: CAD file, 2025-12-28]
SC945D/3D/SC945D/pins_1.sldprt
1.50 x 1.00 x 1.00 mm
