essensys-hub/essensys-board-SC945D/SC945D/3D/SC945D/base_1.sldprt

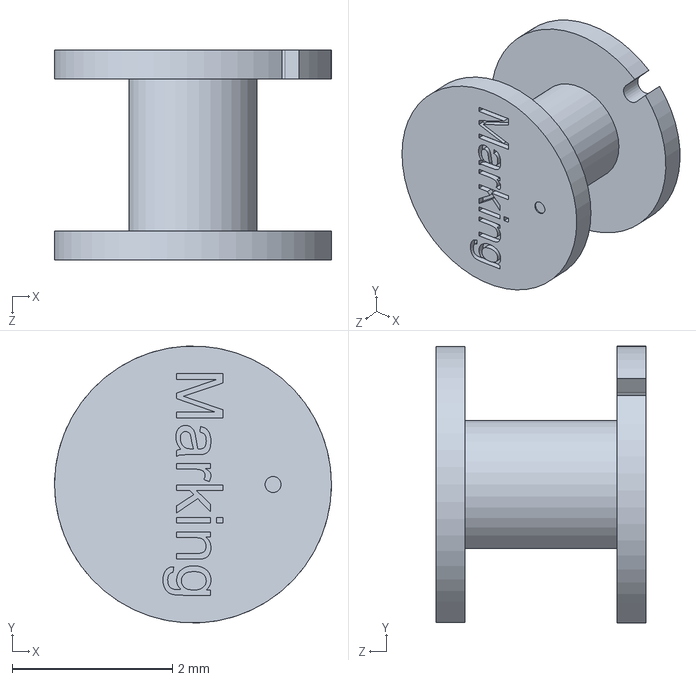
[picture p31: CAD file, 2025-12-28]
SC945D/3D/SC945D/base_1.sldprt
3.46 x 3.46 x 2.62 mm
