essensys-hub/essensys-board-SC945D/SC945D/3D/SC945D/Extruded_3.sldprt

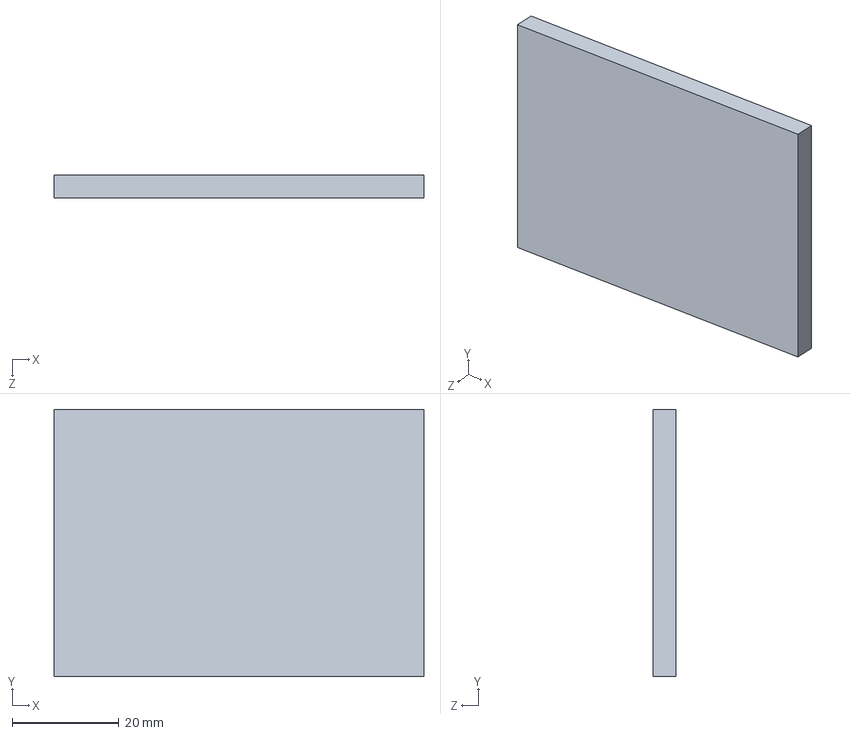
[picture p32: CAD file, 2025-12-28]
SC945D/3D/SC945D/Extruded_3.sldprt
69.2 x 50.0 x 4.30 mm
