essensys-hub/essensys-board-SC945D/SC945D/3D/SC945D/Extruded_4.sldprt

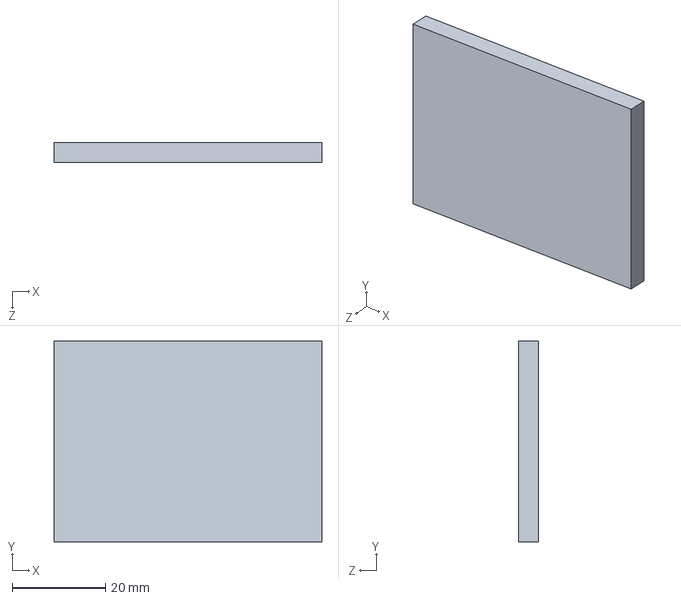
[picture p33: CAD file, 2025-12-28]
SC945D/3D/SC945D/Extruded_4.sldprt
57.6 x 43.2 x 4.30 mm
