essensys-hub/essensys-board-SC945D/(list of files, cad)

Other CAD files:
SC945D/3D/SC945D/C44.sldasm
SC945D/3D/SC945D/C37.sldasm
SC945D/3D/SC945D/D1.sldasm
SC945D/3D/SC945D/R17.sldasm
SC945D/3D/SC945D/C40.sldasm
SC945D/3D/SC945D/R23.sldasm
SC945D/3D/SC945D/C28.sldasm
SC945D/3D/SC945D/C5.sldasm
SC945D/3D/SC945D/R29.sldasm
SC945D/3D/SC945D/C39.sldasm
SC945D/3D/SC945D/R7.sldasm
SC945D/3D/SC945D/D6.sldasm
SC945D/3D/SC945D/C45.sldasm
SC945D/3D/SC945D/C21.sldasm
SC945D/3D/SC945D/C15.sldasm
SC945D/3D/SC945D/C36.sldasm
SC945D/3D/SC945D/R24.sldasm
SC945D/3D/SC945D/C50.sldasm
SC945D/3D/SC945D/C3.sldasm
SC945D/3D/SC945D/R15.sldasm
SC945D/3D/SC945D/R108.sldasm
SC945D/3D/SC945D/R14.sldasm
SC945D/3D/SC945D/R5.sldasm
SC945D/3D/SC945D/C52.sldasm
SC945D/3D/SC945D/C11.sldasm
SC945D/3D/SC945D/C14.sldasm
SC945D/3D/SC945D/D3.sldasm
SC945D/3D/SC945D/C20.sldasm
SC945D/3D/SC945D/R2.sldasm
SC945D/3D/SC945D/C4.sldasm
SC945D/3D/SC945D/C17.sldasm
SC945D/3D/SC945D/R31.sldasm
SC945D/3D/SC945D/R104.sldasm
SC945D/3D/SC945D/C7.sldasm
SC945D/3D/SC945D/C27.sldasm
SC945D/3D/SC945D/D5.sldasm
SC945D/3D/SC945D/U12.sldasm
SC945D/3D/SC945D/U9.sldasm
SC945D/3D/SC945D/R4.sldasm
SC945D/3D/SC945D/T5.sldasm
SC945D/3D/SC945D/C32.sldasm
SC945D/3D/SC945D/R13.sldasm
SC945D/3D/SC945D/C41.sldasm
SC945D/3D/SC945D/D2.sldasm
SC945D/3D/SC945D/C48.sldasm
SC945D/3D/SC945D/C22.sldasm
SC945D/3D/SC945D/U6.sldasm
SC945D/3D/SC945D/User_Library-SOIC-8-150.sldasm
SC945D/3D/SC945D/J3.sldasm
SC945D/3D/SC945D/R27.sldasm
SC945D/3D/SC945D/C30.sldasm
SC945D/3D/SC945D/T4.sldasm
SC945D/3D/SC945D/C6.sldasm
SC945D/3D/SC945D/C13.sldasm
SC945D/3D/SC945D/C29.sldasm
SC945D/3D/SC945D/U3.sldasm
SC945D/3D/SC945D/R1.sldasm
SC945D/3D/SC945D/R126.sldasm
SC945D/3D/SC945D/U4.sldasm
SC945D/3D/SC945D/R34.sldasm
SC945D/3D/SC945D/U14.sldasm
SC945D/3D/SC945D/D10.sldasm
SC945D/3D/SC945D/C51.sldasm
SC945D/3D/SC945D/C46.sldasm
SC945D/3D/SC945D/R111.sldasm
SC945D/3D/SC945D/D4.sldasm
SC945D/3D/SC945D/R10.sldasm
SC945D/3D/SC945D/C2.sldasm
SC945D/3D/SC945D/C24.sldasm
SC945D/3D/SC945D/C31.sldasm
SC945D/3D/SC945D/R3.sldasm
SC945D/3D/SC945D/R122.sldasm
SC945D/3D/SC945D/Q1.sldasm
SC945D/3D/SC945D/S1.sldasm
SC945D/3D/SC945D/R18.sldasm
SC945D/3D/SC945D/R30.sldasm
SC945D/3D/SC945D/C35.sldasm
SC945D/3D/SC945D/R128.sldasm
SC945D/3D/SC945D/R28.sldasm
SC945D/3D/SC945D/U11.sldasm
SC945D/3D/SC945D/R102.sldasm
SC945D/3D/SC945D/C9.sldasm
SC945D/3D/SC945D/C16.sldasm
SC945D/3D/SC945D/J2.sldasm
SC945D/3D/SC945D/R9.sldasm
SC945D/3D/SC945D/R123.sldasm
SC945D/3D/SC945D/C12.sldasm
SC945D/3D/SC945D/R124.sldasm
SC945D/3D/SC945D/C43.sldasm
SC945D/3D/SC945D/L1.sldasm
SC945D/3D/SC945D/C26.sldasm
SC945D/3D/SC945D/Free-Models.sldasm
SC945D/3D/SC945D/C34.sldasm
SC945D/3D/SC945D/U13.sldasm
SC945D/3D/SC945D/R11.sldasm
SC945D/3D/SC945D/R25.sldasm
SC945D/3D/SC945D/R106.sldasm
SC945D/3D/SC945D/C38.sldasm
SC945D/3D/SC945D/U1.sldasm
SC945D/3D/SC945D/R8.sldasm
SC945D/3D/SC945D/R22.sldasm
SC945D/3D/SC945D/R127.sldasm
SC945D/3D/SC945D/T1.sldasm
SC945D/3D/SC945D/C23.sldasm
SC945D/3D/SC945D/R32.sldasm
SC945D/3D/SC945D/R121.sldasm
SC945D/3D/SC945D/R109.sldasm
SC945D/3D/SC945D/C49.sldasm
SC945D/3D/SC945D/D9.sldasm
SC945D/3D/SC945D/R105.sldasm
SC945D/3D/SC945D/C10.sldasm
SC945D/3D/SC945D/R19.sldasm
SC945D/3D/SC945D/R26.sldasm
SC945D/3D/SC945D/R101.sldasm
SC945D/3D/SC945D/C18.sldasm
SC945D/3D/SC945D/C42.sldasm
SC945D/3D/SC945D/R33.sldasm
SC945D/3D/SC945D/WE-TPC_4828.sldasm
SC945D/3D/SC945D/R125.sldasm
SC945D/3D/SC945D/SPK1.sldasm
SC945D/3D/SC945D/U2.sldasm
SC945D/3D/SC945D/WE-SL2_74422.sldasm
SC945D/3D/SC945D/T3.sldasm
SC945D/3D/SC945D/R107.sldasm
SC945D/3D/SC945D/C25.sldasm
SC945D/3D/SC945D/C47.sldasm
SC945D/3D/SC945D/C1.sldasm
SC945D/3D/SC945D/D8.sldasm
SC945D/3D/SC945D/C8.sldasm
SC945D/3D/SC945D/R12.sldasm
SC945D/3D/SC945D/R35.sldasm
SC945D/3D/SC945D/R6.sldasm
SC945D/3D/SC945D/R16.sldasm
SC945D/3D/SC945D/R103.sldasm
SC945D/3D/SC945D/C33.sldasm
SC945D/3D/SC945D/C19.sldasm
SC945D/3D/SC945D/L4.sldasm
SC945D/3D/SC945D/U10.sldasm
SC945D/3D/SC945D/U7.sldasm
SC945D/3D/SC945D/R21.sldasm
SC945D/3D/SC945D/SW3dPS-1206_SMD_Resistor.sldprt
SC945D/3D/SC945D/User_Library-sot353.sldprt
SC945D/3D/SC945D/SW3DPS-DIOD_SMD_10BF10-DEFAULT.sldprt
SC945D/3D/SC945D/1151702080.sldasm
SC945D/3D/SC945D/1151716496.sldasm
SC945D/3D/SC945D/1151716632.sldasm
SC945D/3D/SC945D/1151717312.sldasm
SC945D/3D/SC945D/1151717448.sldasm
SC945D/3D/SC945D/1151720984.sldasm
SC945D/3D/SC945D/1151725608.sldasm
SC945D/3D/SC945D/1151726016.sldasm
SC945D/3D/SC945D/256-402_332-000.sldprt
SC945D/3D/SC945D/4341x3025816.sldasm
SC945D/3D/SC945D/693071010811.sldasm
SC945D/3D/SC945D/693071010811.sldprt
SC945D/3D/SC945D/693071010811_1.sldprt
SC945D/3D/SC945D/693071010811_AGRAPHE.sldprt
SC945D/3D/SC945D/693071010811_CACHE.sldprt
SC945D/3D/SC945D/693071010811_CONTACT.sldprt
SC945D/3D/SC945D/693071010811_COULISSEAU.sldprt
SC945D/3D/SC945D/Board.sldprt
SC945D/3D/SC945D/Boden.sldprt
SC945D/3D/SC945D/Boden_1.sldprt
SC945D/3D/SC945D/Boden_2.sldprt
SC945D/3D/SC945D/Boden_3.sldprt
SC945D/3D/SC945D/Boden_4.sldprt
SC945D/3D/SC945D/Cylinder.sldprt
SC945D/3D/SC945D/Cylinder_1.sldprt
SC945D/3D/SC945D/Deckel.sldprt
SC945D/3D/SC945D/Extruded.sldprt
SC945D/3D/SC945D/Extruded_1.sldprt
SC945D/3D/SC945D/Extruded_2.sldprt
SC945D/3D/SC945D/Extruded_5.sldprt
SC945D/3D/SC945D/Lötstreifen.sldprt
SC945D/3D/SC945D/Lötstreifen_1.sldprt
SC945D/3D/SC945D/Projection_V71613_3D.sldprt
SC945D/3D/SC945D/RESC1608X84N.sldprt
SC945D/3D/SC945D/SW3dPS-DPAK-1.sldprt
SC945D/3D/SC945D/SW3dPS-SC70-6.sldprt
SC945D/3D/SC945D/SW3dPS-SOD-323.sldprt
SC945D/3D/SC945D/SW3dPS-SOT-223-1.sldprt
SC945D/3D/SC945D/SW3dPS-hc49_cystal.sldprt
SC945D/3D/SC945D/SW3dPS-transistor_SOT233.sldprt
SC945D/3D/SC945D/SW3dPS-transistor_SOT233_1.sldprt
SC945D/3D/SC945D/SW3dPS-transistor_SOT233_2.sldprt
SC945D/3D/SC945D/SW3dPS-transistor_SOT233_3.sldprt
SC945D/3D/SC945D/User_Library-CAPC1608X09.sldprt
SC945D/3D/SC945D/User_Library-CAPC2013X10.sldprt
SC945D/3D/SC945D/User_Library-CAPC3216X10.sldprt
SC945D/3D/SC945D/User_Library-Micro_SD_Card.sldprt
SC945D/3D/SC945D/User_Library-SOIC-8-150_SOIC_150_SOIC_5X4_1.sldprt
SC945D/3D/SC945D/User_Library-SOIC-8-150_pin_SOIC_SO-150_1.sldprt
SC945D/3D/SC945D/User_Library-SOT23-6.sldprt
SC945D/3D/SC945D/User_Library-TQFP64.sldprt
SC945D/3D/SC945D/base.sldprt
SC945D/3D/SC945D/base_2.sldprt
SC945D/3D/SC945D/base_3.sldprt
SC945D/3D/SC945D/base_4.sldprt
SC945D/3D/SC945D/pins.sldprt
SC945D/3D/SC945D/top_cover.sldprt
