essensys-hub/essensys-board-SC945D/SC945D/Test/Sources/10 - 20170323_133623.jpg

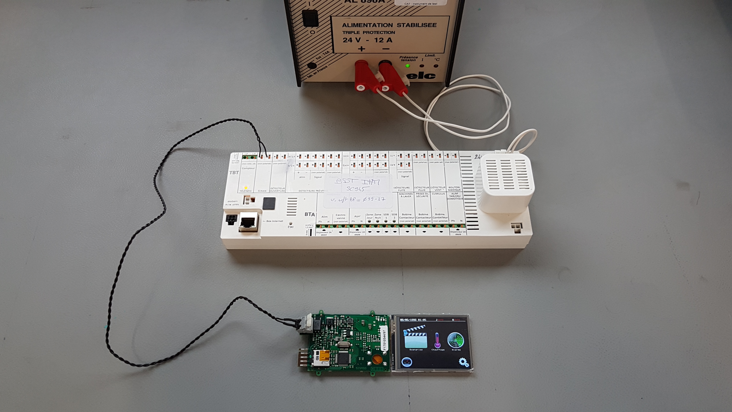
SC945D/Test/Sources/10 - 20170323_133623.jpg
