essensys-hub/essensys-board-SC945D/SC945D/Test/Sources/20 - 20170323_140300.jpg

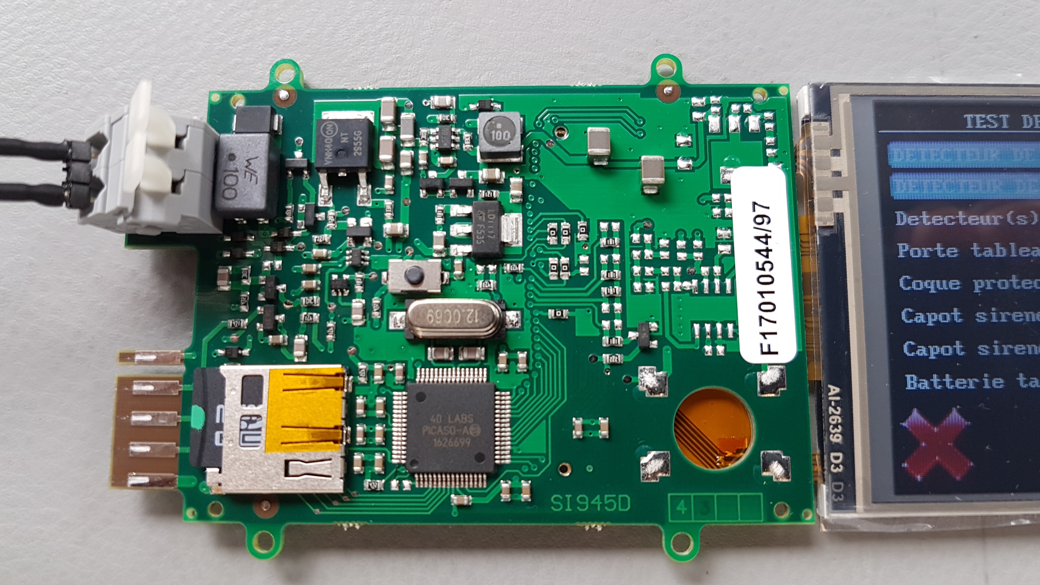
SC945D/Test/Sources/20 - 20170323_140300.jpg
