essensys-hub/essensys-board-SC945D/SC945D/Test/Sources/_ECRAN_HOME v2.png

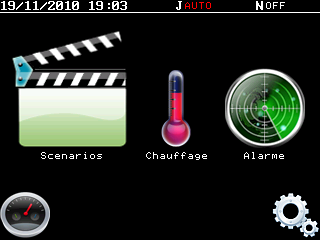
SC945D/Test/Sources/_ECRAN_HOME v2.png
