essensys-hub/essensys-board-SC945D/SC945D/Test/Sources/_ECRAN_REGLAGE_ALARME v1.png

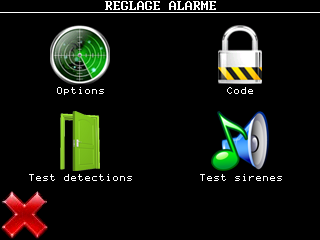
SC945D/Test/Sources/_ECRAN_REGLAGE_ALARME v1.png
