essensys-hub/essensys-board-SC945D/SC945D/Test/Sources/_ECRAN_REGLAGE_ALARME_TEST_DETECTIONS v3.png

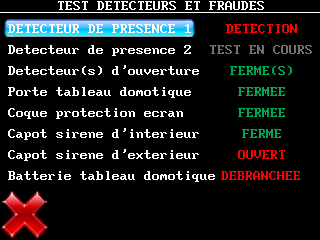
SC945D/Test/Sources/_ECRAN_REGLAGE_ALARME_TEST_DETECTIONS v3.png
