essensys-hub/essensys-board-SC945D/SC945D/Test/Sources/_ECRAN_REGLAGE_CALIBRAGE_ECRAN_1&2 v1.png

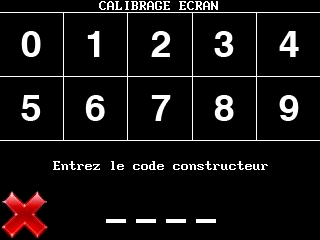
SC945D/Test/Sources/_ECRAN_REGLAGE_CALIBRAGE_ECRAN_1&2 v1.png
