essensys-hub/essensys-board-SC945D/SC945D/Test/Sources/_ECRAN_REGLAGES_1 v1.png

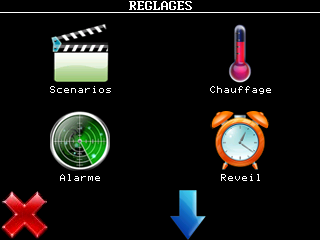
SC945D/Test/Sources/_ECRAN_REGLAGES_1 v1.png
