essensys-hub/essensys-board-SC945D/SC945D/Test/Sources/_ECRAN_REGLAGES_2 v1.png

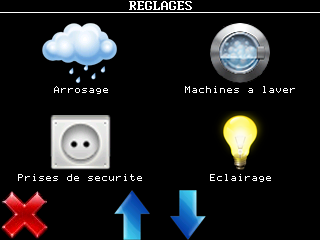
SC945D/Test/Sources/_ECRAN_REGLAGES_2 v1.png
