essensys-hub/essensys-board-SC945D/SC945D/Test/Sources/_ECRAN_REGLAGES_5 v3.png

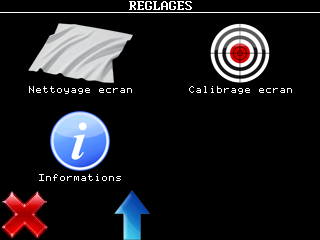
SC945D/Test/Sources/_ECRAN_REGLAGES_5 v3.png
