essensys-hub/essensys-board-SC945D/Schematic PDF_[No Variations].pdf

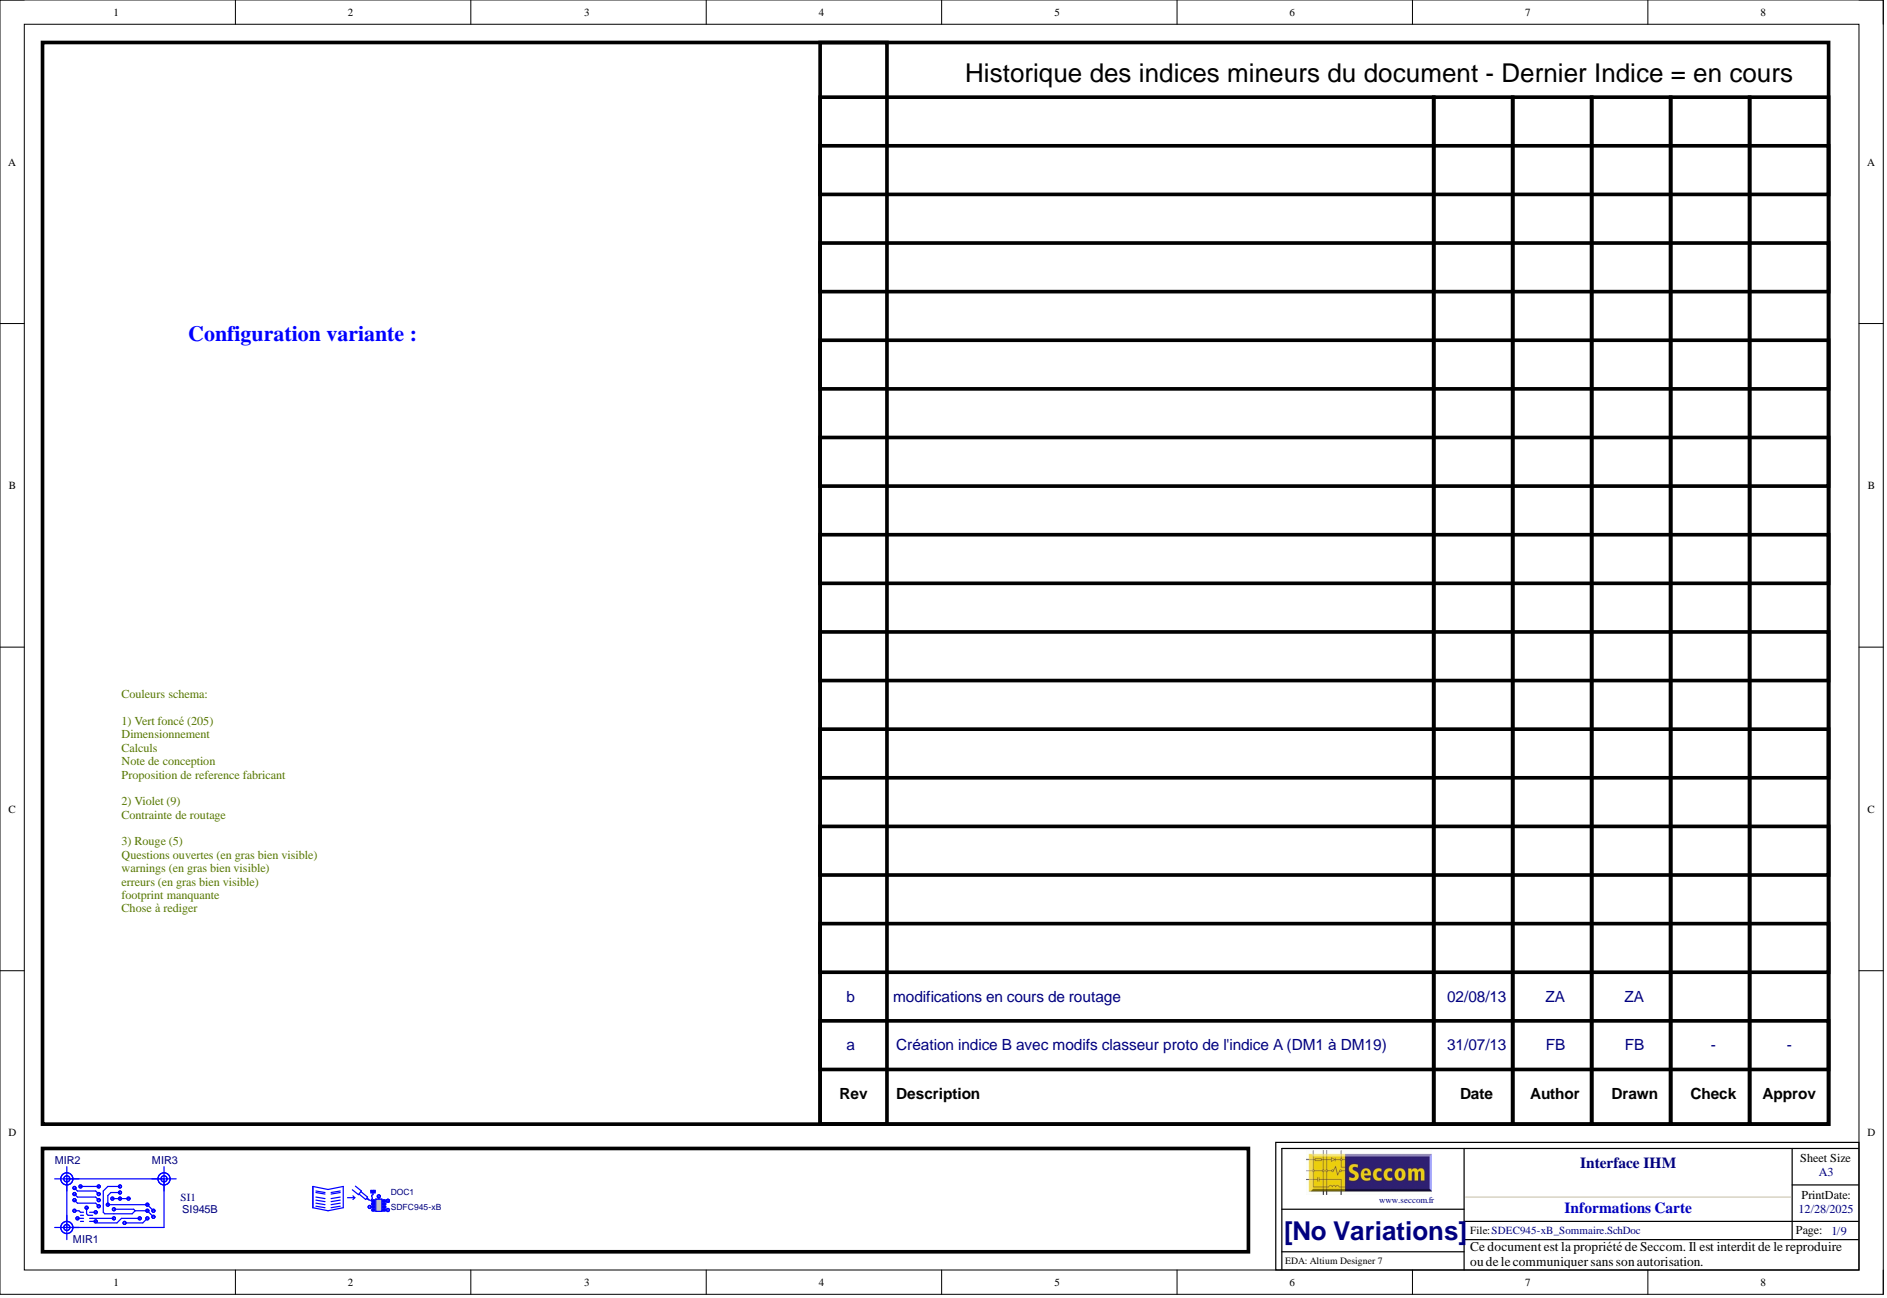
[picture p43: page 1]
est la; est interdit; c [No Variations]; Interface IH; ium D; igner 7; Configuration variante :; Vert fonc; ion de referenc; e fabri; t (9) e de rout; s (en gra; erreurs (en gra; à redige

Historique des indices mineurs du document - Dernier Indice = en cours

3) Rouge (5) Questions ouvert

arnings (en gra

b | modi f icat ions en cours de routage | 02/08/ 1 3 | ZA | ZA

a | C r éat ion indice B avec modi fs classeur proto de l'indice A (DM1 à DM19) | 31/07/ 1 3 | FB | FB | Check - | -

Rev | Descripti o n | Dat e | Autho r | Draw n | | Approv

Carte www.seccom.fr

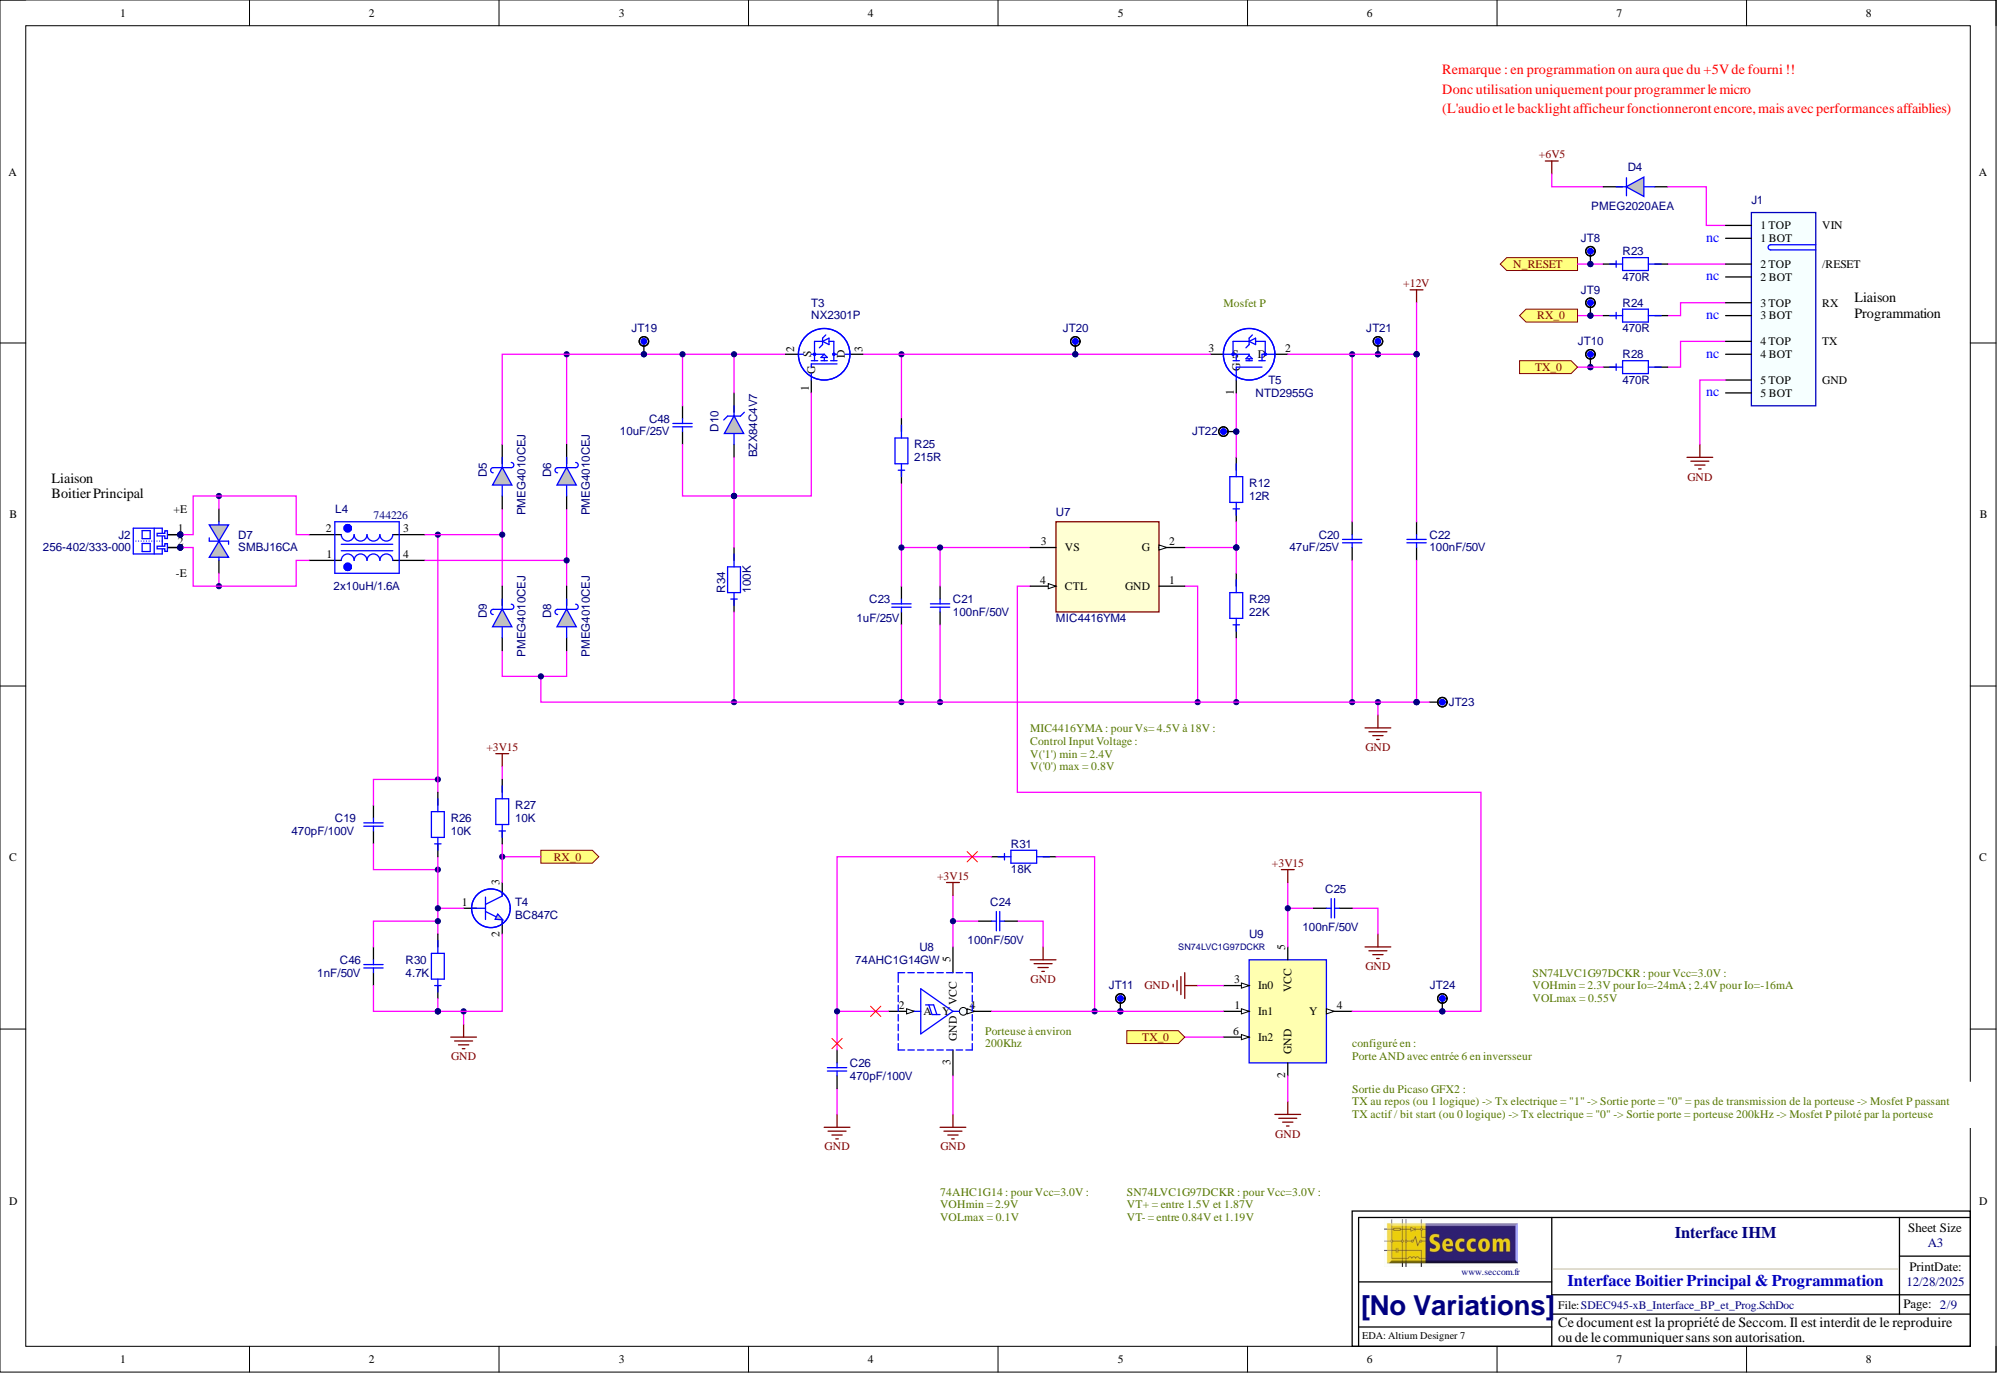
[picture p44: page 2]

Interface Boitier Principal & Programmation www.seccom.fr

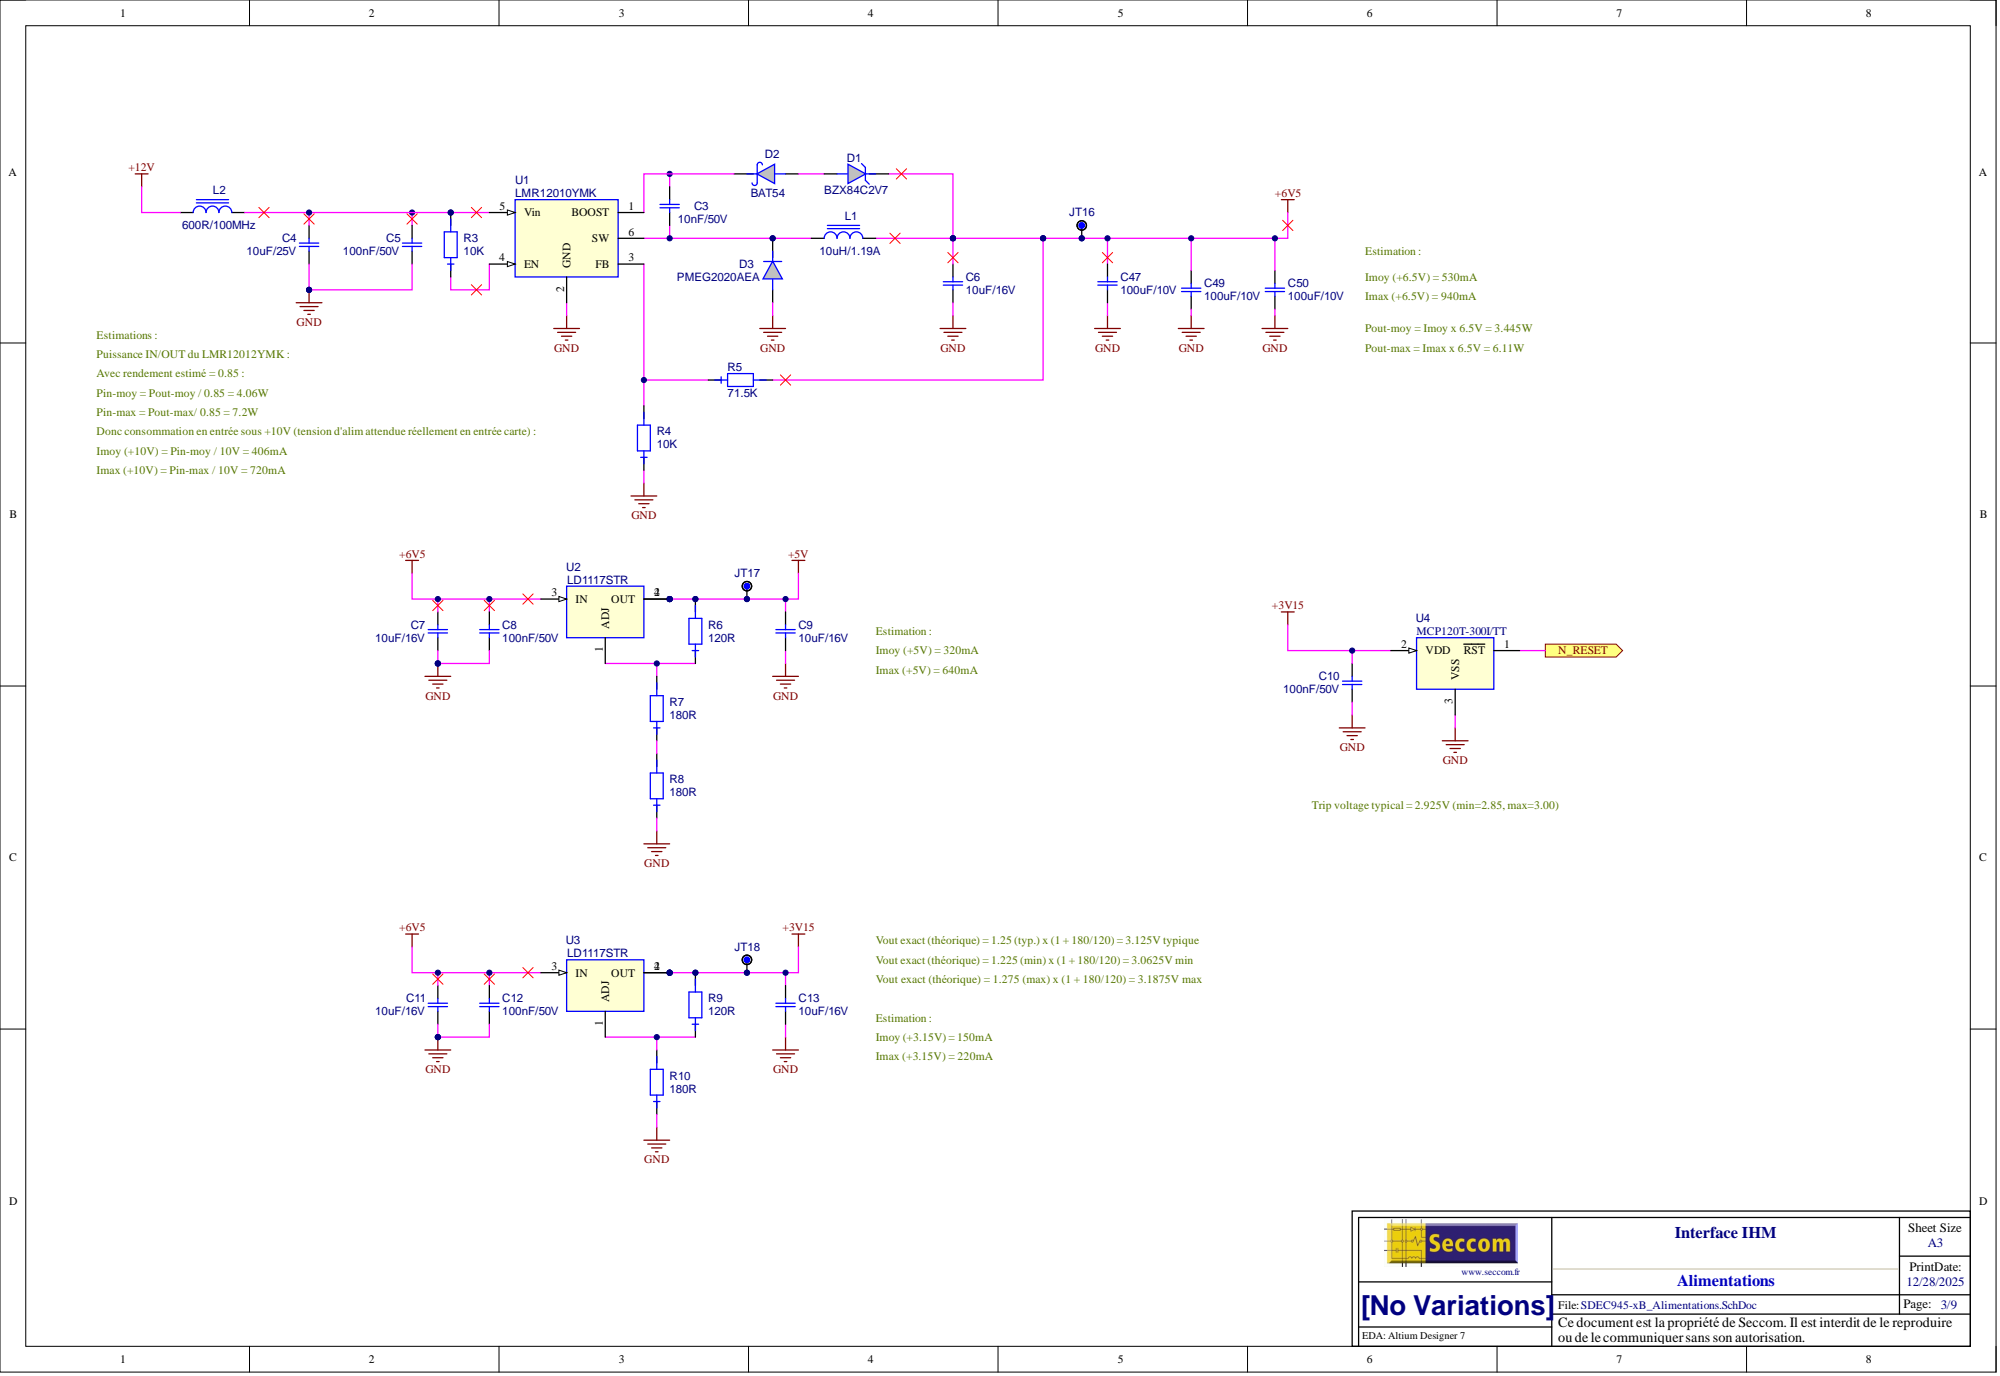
[picture p45: page 3]

Estimations :
Puissance IN/OUT du LMR12012YMK :
Avec rendement estimé = 0.85 :
Pin-moy = Pout-moy / 0.85 = 4.06W
Pin-max = Pout-max/ 0.85 = 7.2W
Donc consommation en entrée sous +10V (tension d'alim attendue réellement en entrée carte) :
Imoy (+10V) = Pin-moy / 10V = 406mA
Imax (+10V) = Pin-max / 10V = 720mA

Trip voltage typical = 2.925V (min=2.85, max=3.00)

Vout exact (théorique) = 1.25 (typ.) x (1 + 180/120) = 3.125V typique
Vout exact (théorique) = 1.225 (min) x (1 + 180/120) = 3.0625V min
Vout exact (théorique) = 1.275 (max) x (1 + 180/120) = 3.1875V max

File:SDEC945-xB_Alimentations.SchDoc [No Variations]

Ce document est la propriété de Seccom. Il est interdit de le reproduire
ou de le communiquer sans son autorisation.

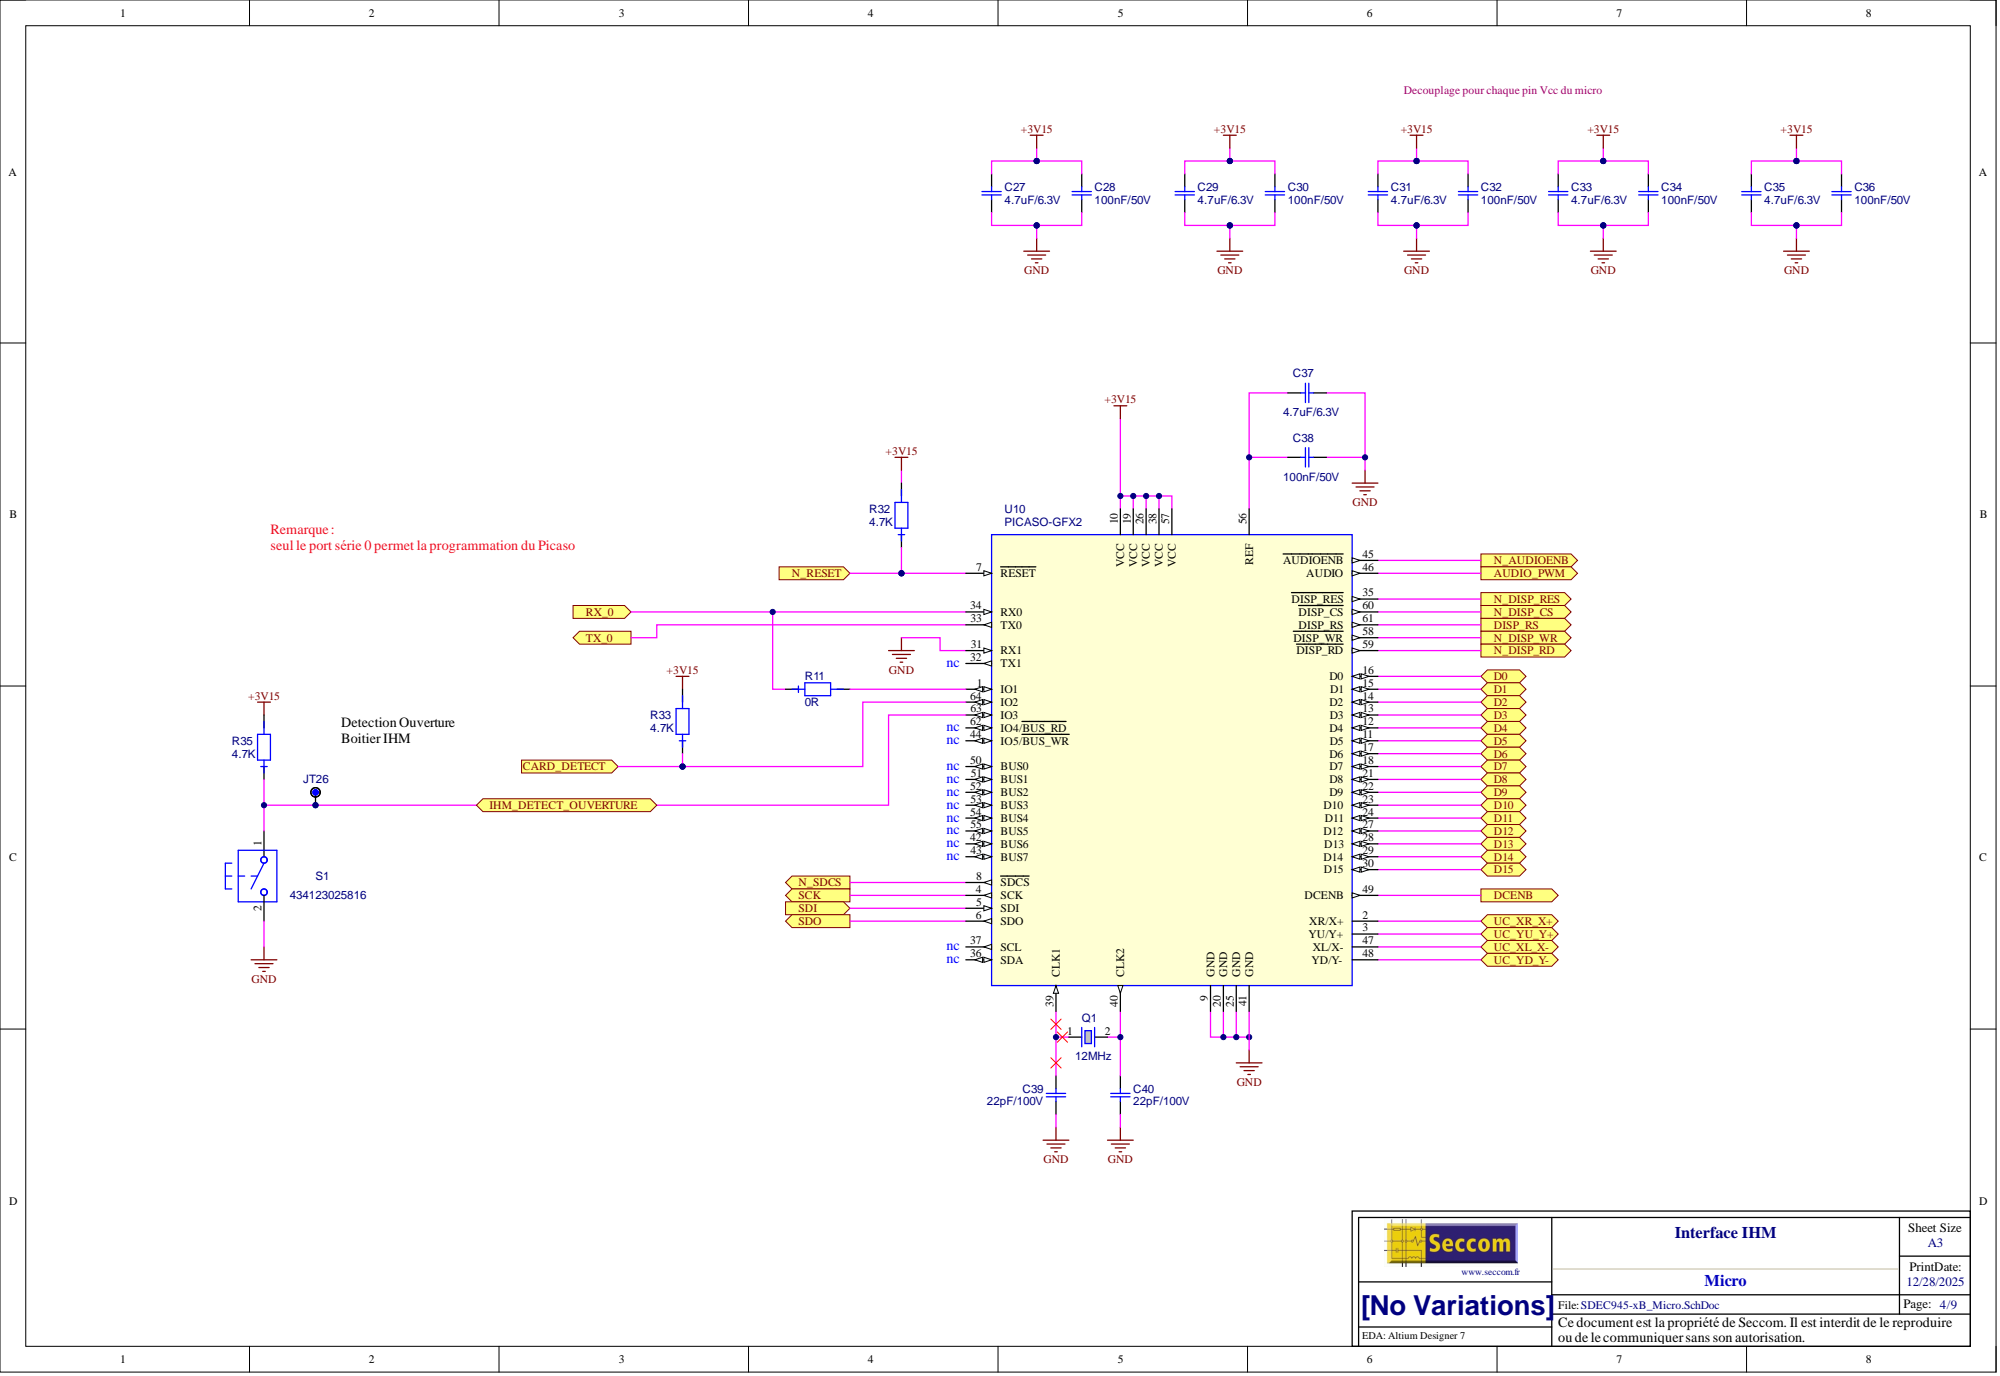
[picture p46: page 4]

Decouplage pour chaque pin Vcc du micro

Remarque :
seul le port série 0 permet la programmation du Picaso

File:SDEC945-xB_Micro.SchDoc [No Variations]

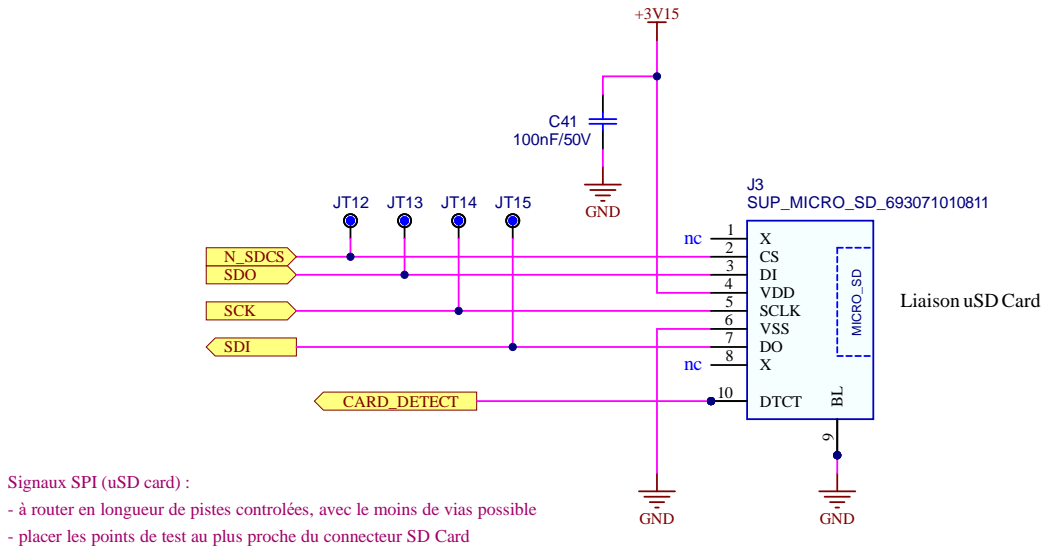
[picture p47: page 5]
Sheet Size; Interface IHM; SD Card www.seccom.fr; PrintDate:; VSS 6; SCLK 5; VDD 4; MICRO_SD; DTCT 10

Liaison uSD Card

Signaux SPI (uSD card) :
- à router en longueur de pistes controlées, avec le moins de vias possible
- placer les points de test au plus proche du connecteur SD Card

File:SDEC945-xB_SD_Card.SchDoc [No Variations]

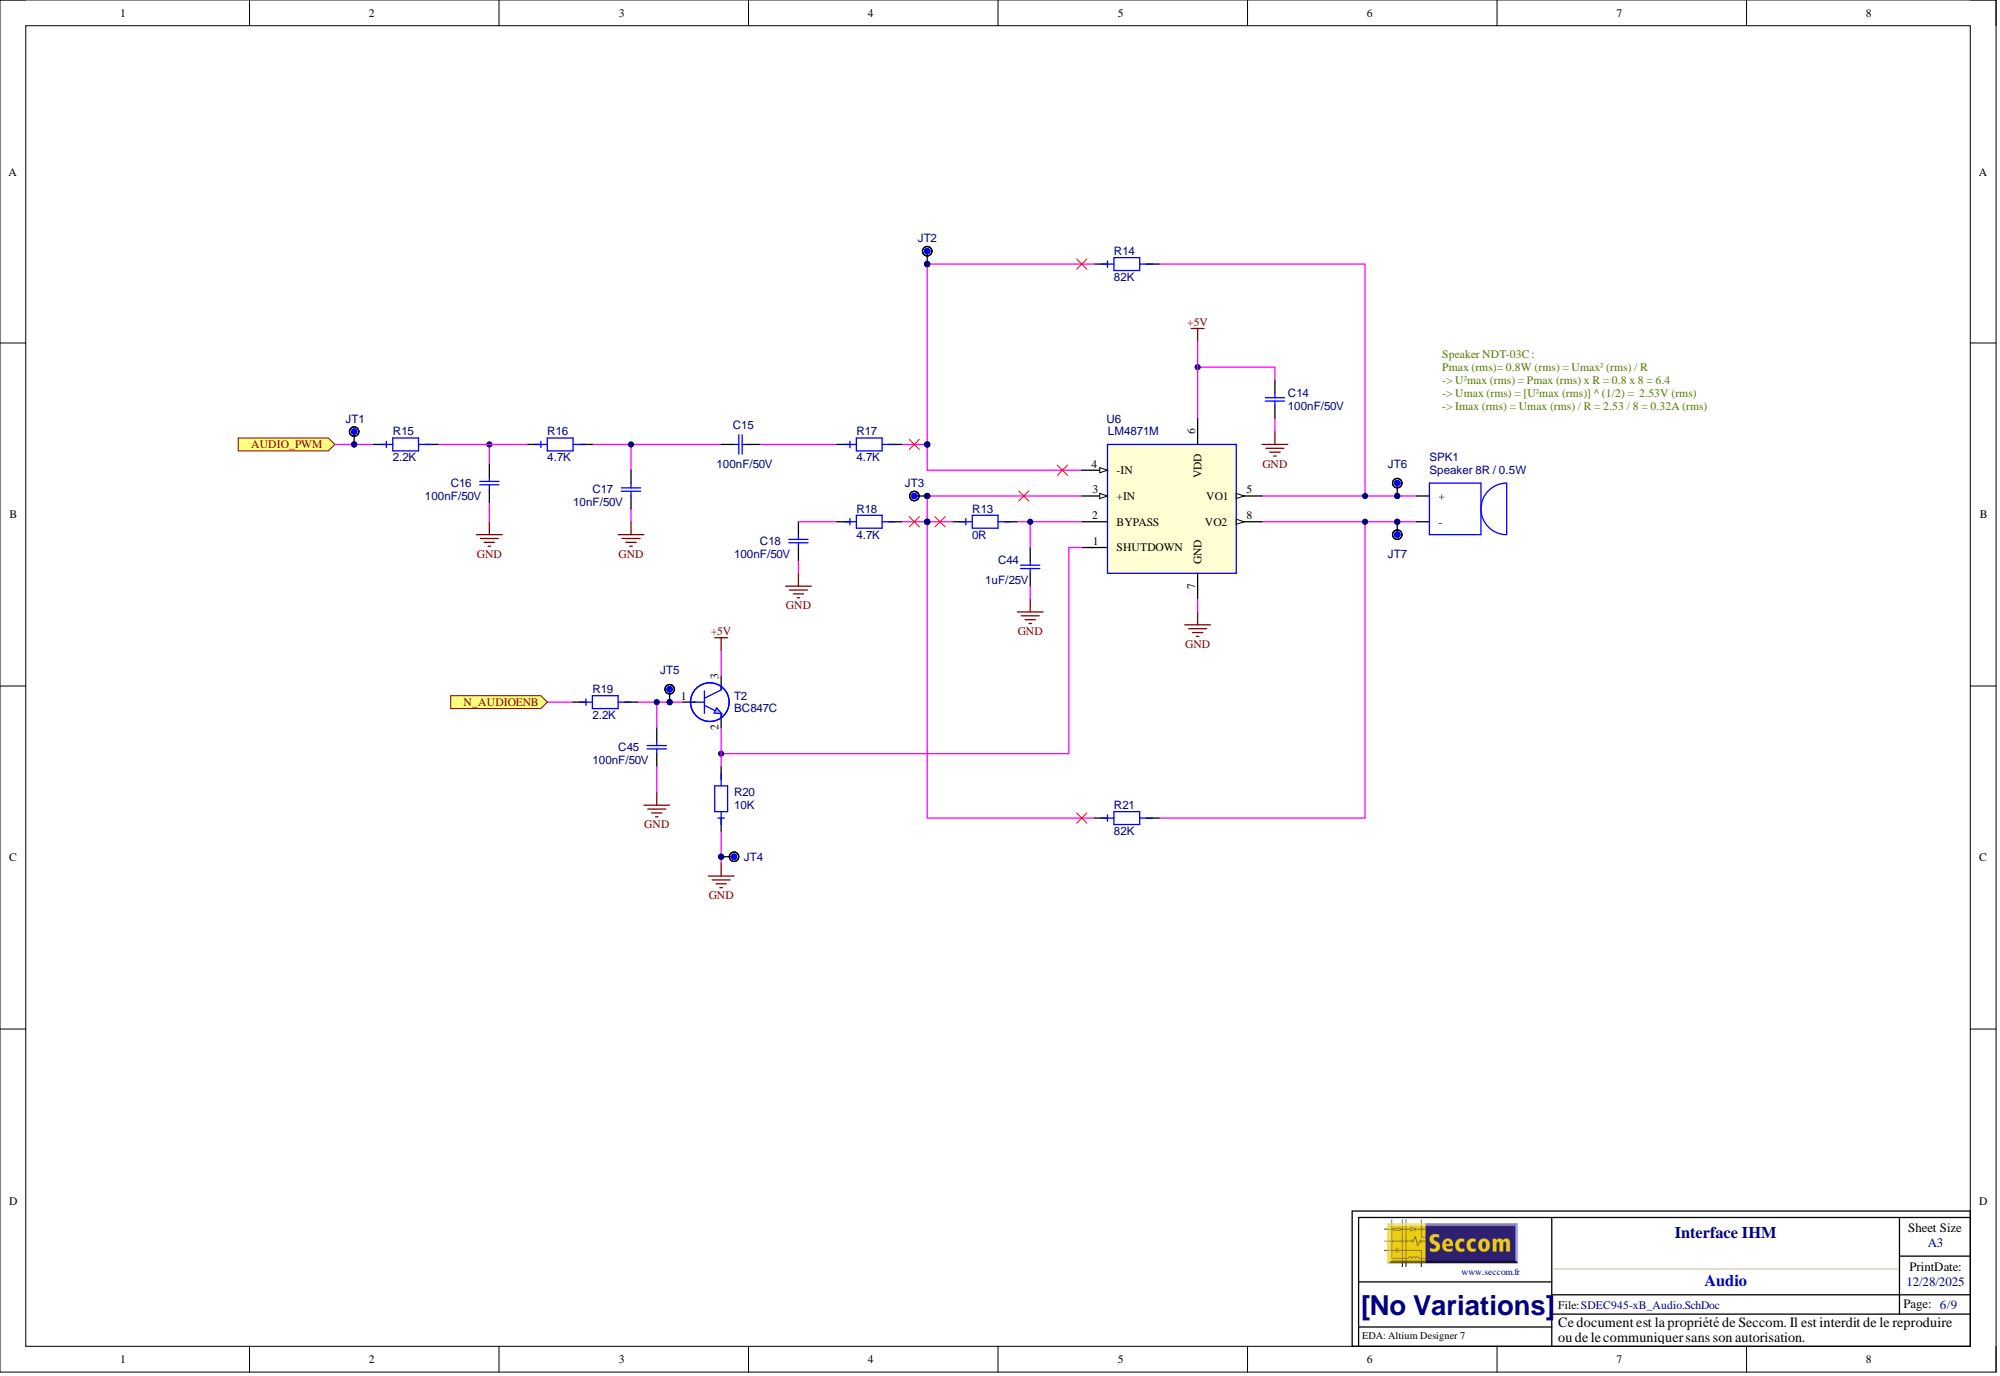
[picture p48: page 6]

Speaker NDT-03C :
Pmax (rms)= 0.8W (rms) = Umax² (rms) / R
-> U²max (rms) = Pmax (rms) x R = 0.8 x 8 = 6.4
-> Umax (rms) = [U²max (rms)] ^ (1/2) = 2.53V (rms)
-> Imax (rms) = Umax (rms) / R = 2.53 / 8 = 0.32A (rms)

LM4871M -IN 4 | 6 GND 7

VO2 | 8 BYPASS 2

SHUTDOWN 1

File:SDEC945-xB_Audio.SchDoc [No Variations]

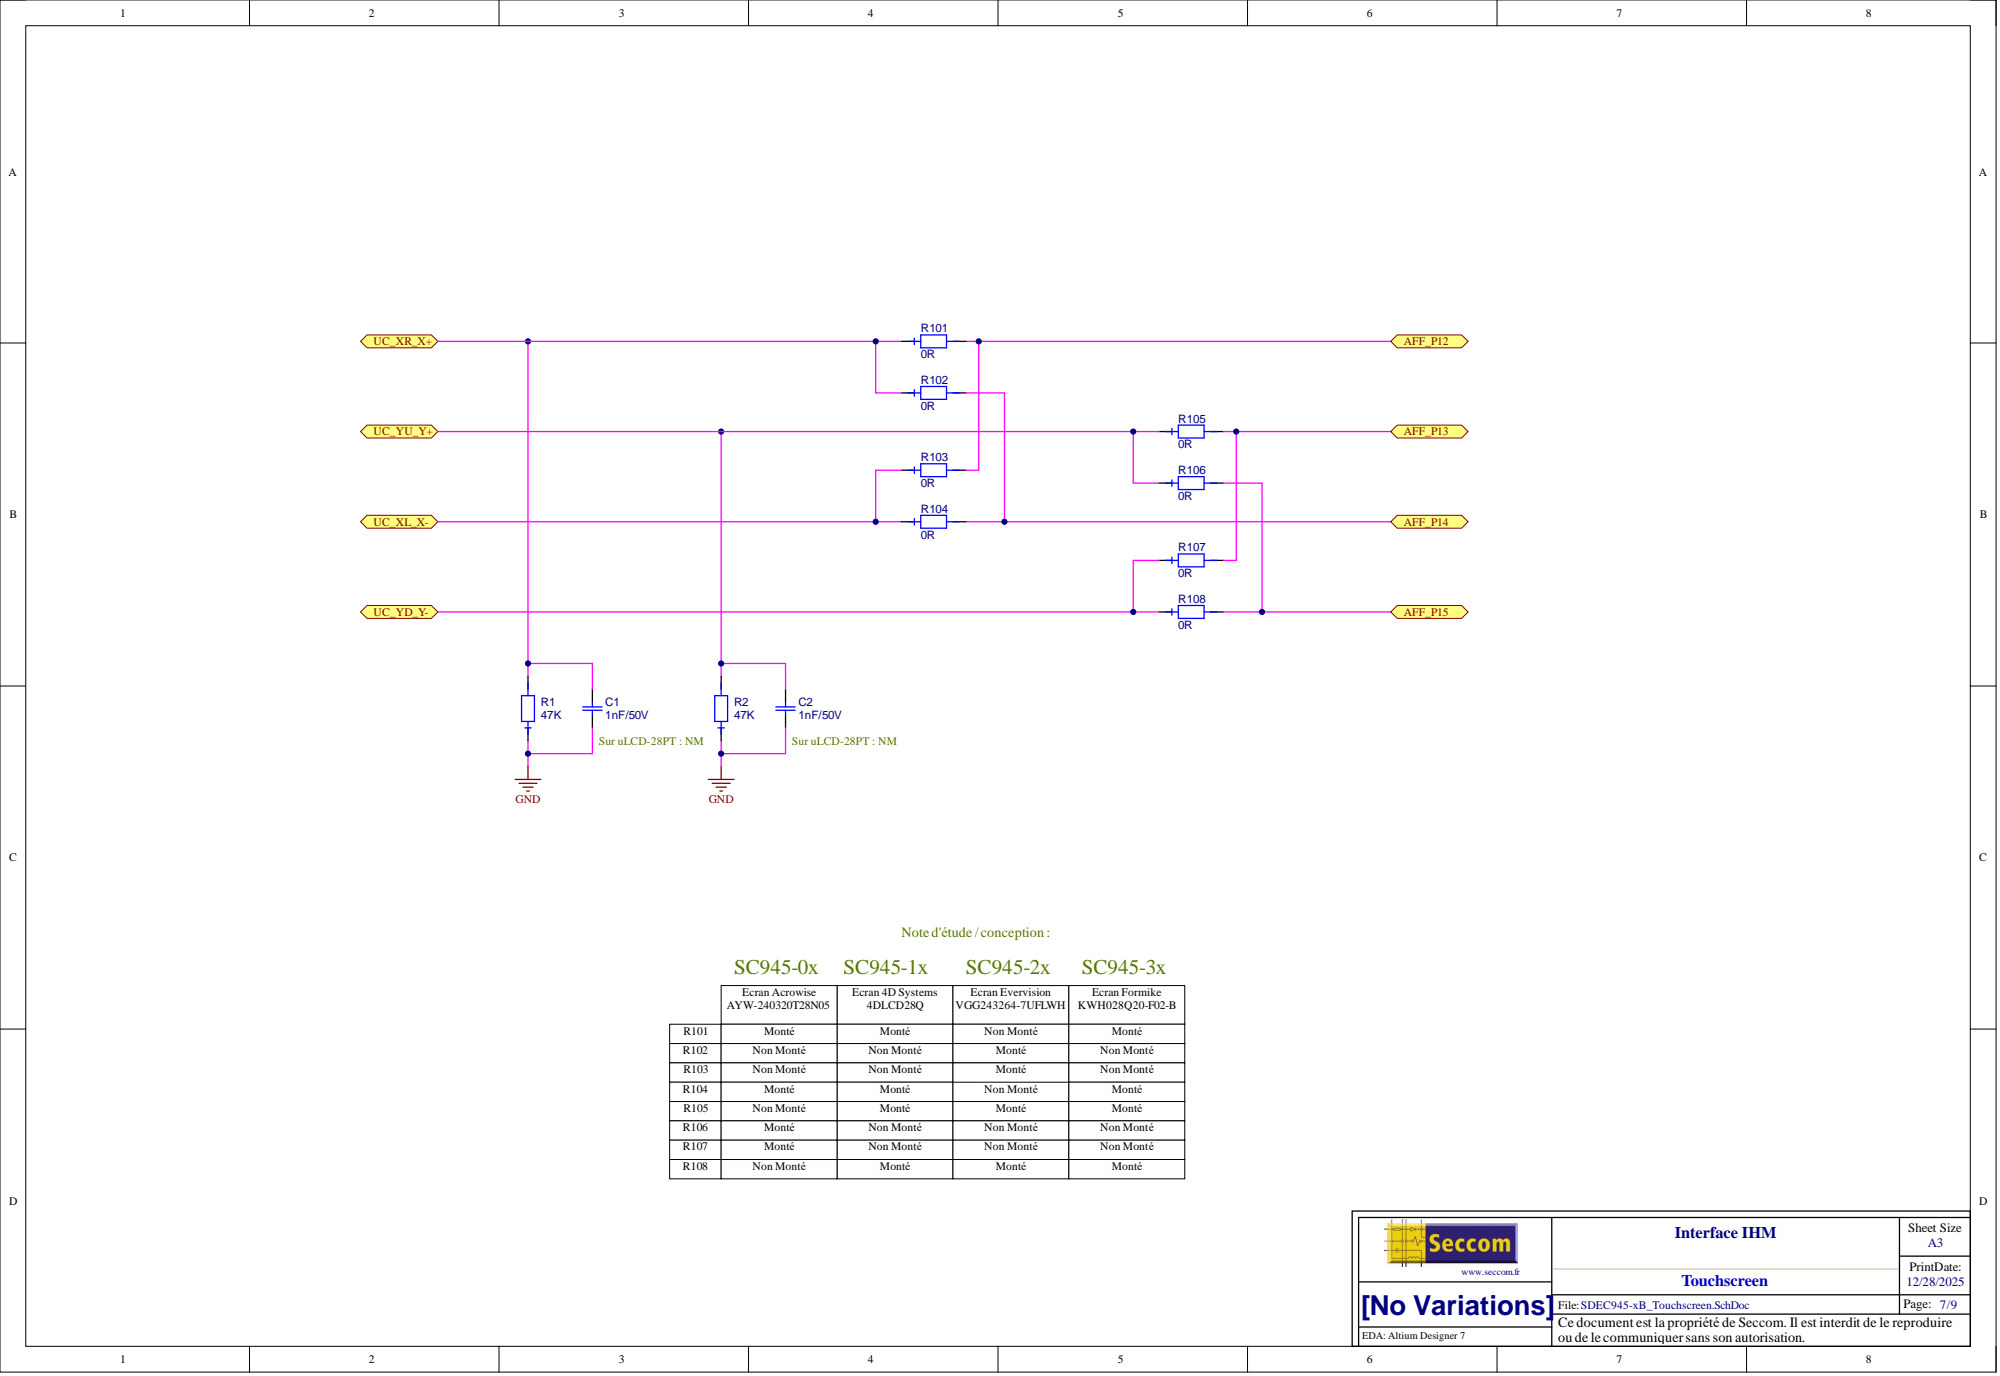
[picture p49: page 7]
Interface IH

Ecran Acro w i s e AY W-2 4 0 3 2 0 T 2 8 N 0 5 | Ecran 4 D Sy s tems 4 D LCD 2 8 Q | Ecran E verv i s i o n V G G 2 4 3 2 6 4-7 U FLW H | Ecran Formi k e K W H 0 2 8 Q 2 0 -F0 2 -B

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

n www.seccom.fr

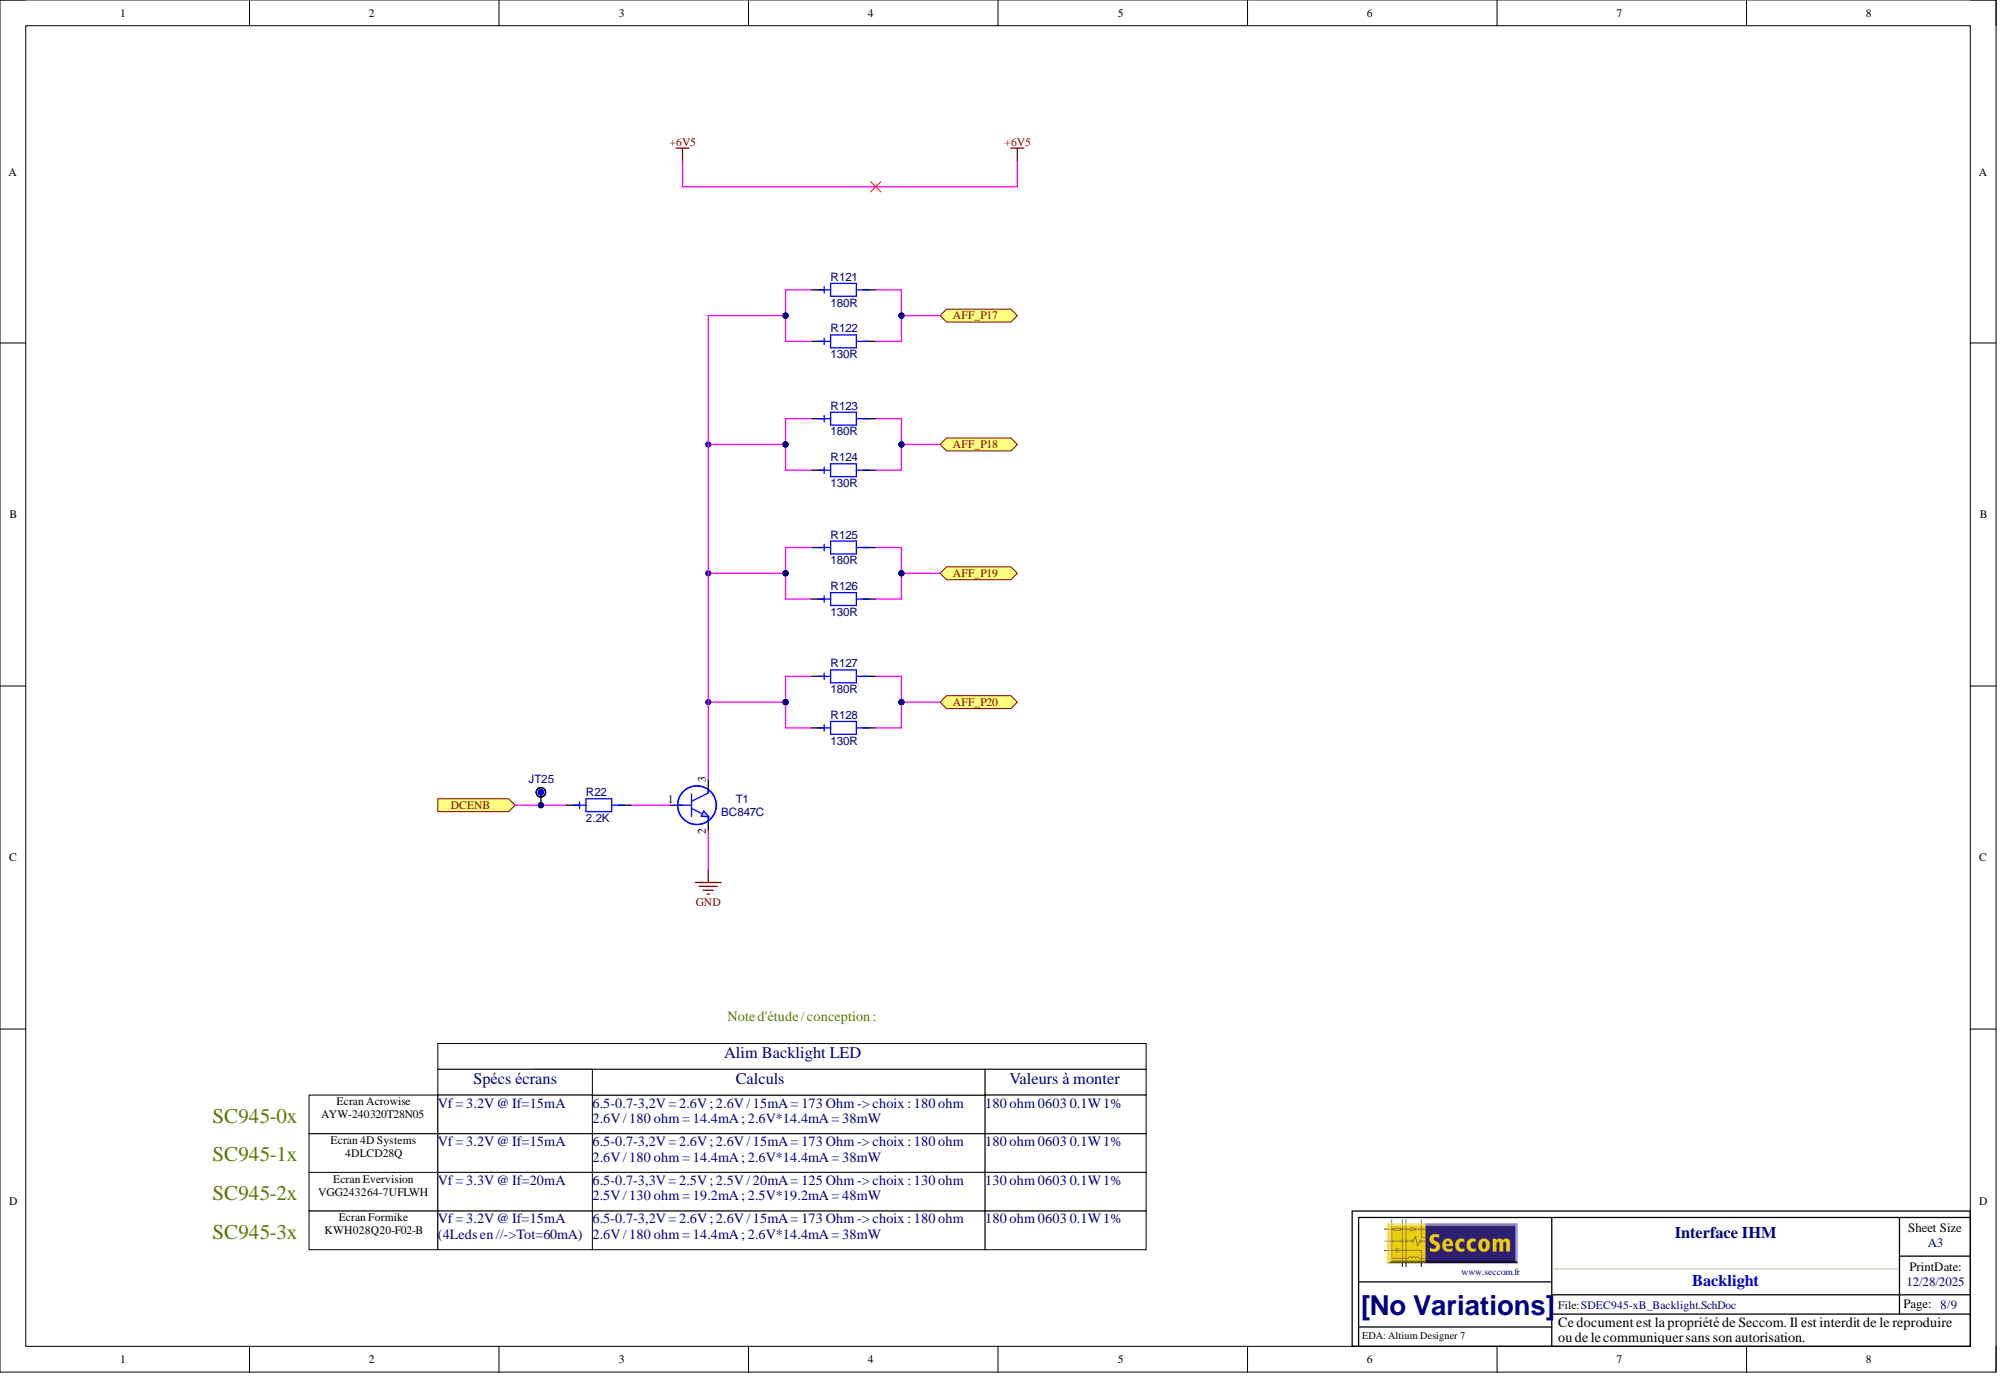
[picture p50: page 8]

Spécs écrans | | Calculs | Valeurs à monter

Ecran Acrowise AYW-240320T28N05 | Vf = 3.2V @ If=15mA | 6.5-0.7-3,2V = 2.6V ; 2.6V / 15mA = 173 Ohm -> choix : 180 ohm 2.6V / 180 ohm = 14.4mA ; 2.6V*14.4mA = 38mW | 180 ohm 0603 0.1W1%

Ecran 4D Systems 4DLCD28Q | Vf = 3.2V @ If=15mA | 6.5-0.7-3,2V = 2.6V ; 2.6V / 15mA = 173 Ohm -> choix : 180 ohm 2.6V / 180 ohm = 14.4mA ; 2.6V*14.4mA = 38mW | 180 ohm 0603 0.1W1%

Ecran Evervision VGG243264-7UFLWH | Vf = 3.3V @ If=20mA | 6.5-0.7-3,3V = 2.5V ; 2.5V / 20mA = 125 Ohm -> choix : 130 ohm 2.5V / 130 ohm = 19.2mA ; 2.5V*19.2mA = 48mW | 130 ohm 0603 0.1W1%

Ecran Formike KWH028Q20-F02-B | Vf = 3.2V @ If=15mA (4Leds en //->Tot=60mA) | 6.5-0.7-3,2V = 2.6V ; 2.6V / 15mA = 173 Ohm -> choix : 180 ohm 2.6V / 180 ohm = 14.4mA ; 2.6V*14.4mA = 38mW | 180 ohm 0603 0.1W1%

Interface IHM | Sheet Size A3

File:SDEC945-xB_Backlight.SchDoc [No Variations]

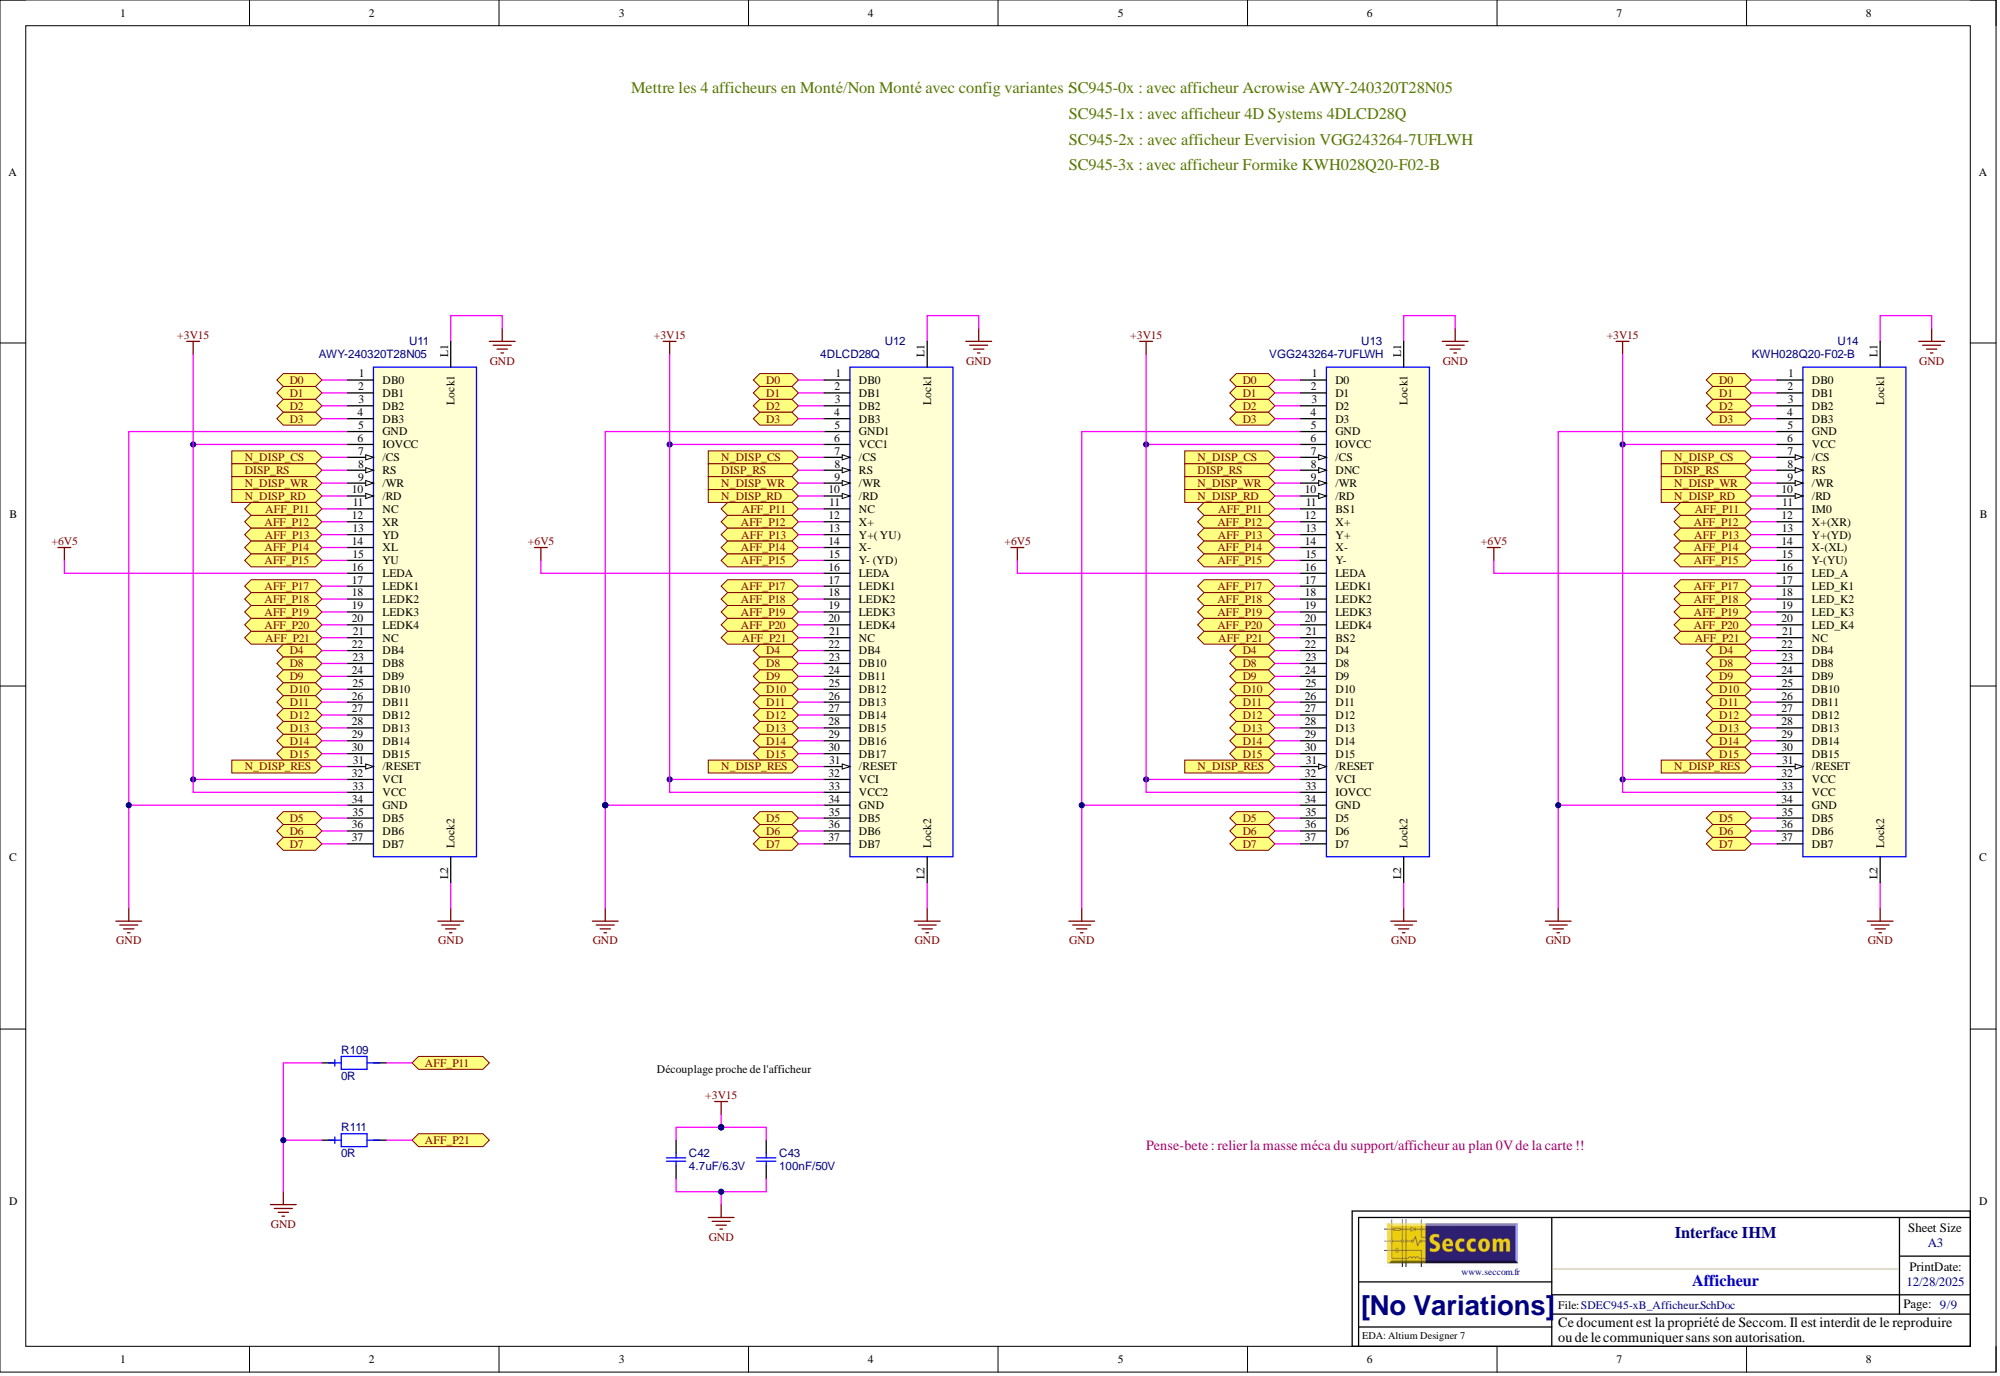
[picture p51: page 9]
Interface IH; arte !!; Non Mont; Lock2 L2 Lock1 L1

les 4 afficheurs en Mont

é avec config variantes

: avec afficheur
: avec afficheur 4D Systems 4DLCD28Q
: avec afficheur Evervision
: avec afficheur Form

ete : relier la masse

r www.seccom.fr
