essensys-hub/essensys-board-SC945D/SC945D/Assembly/SC945D_Schematic (DM).pdf

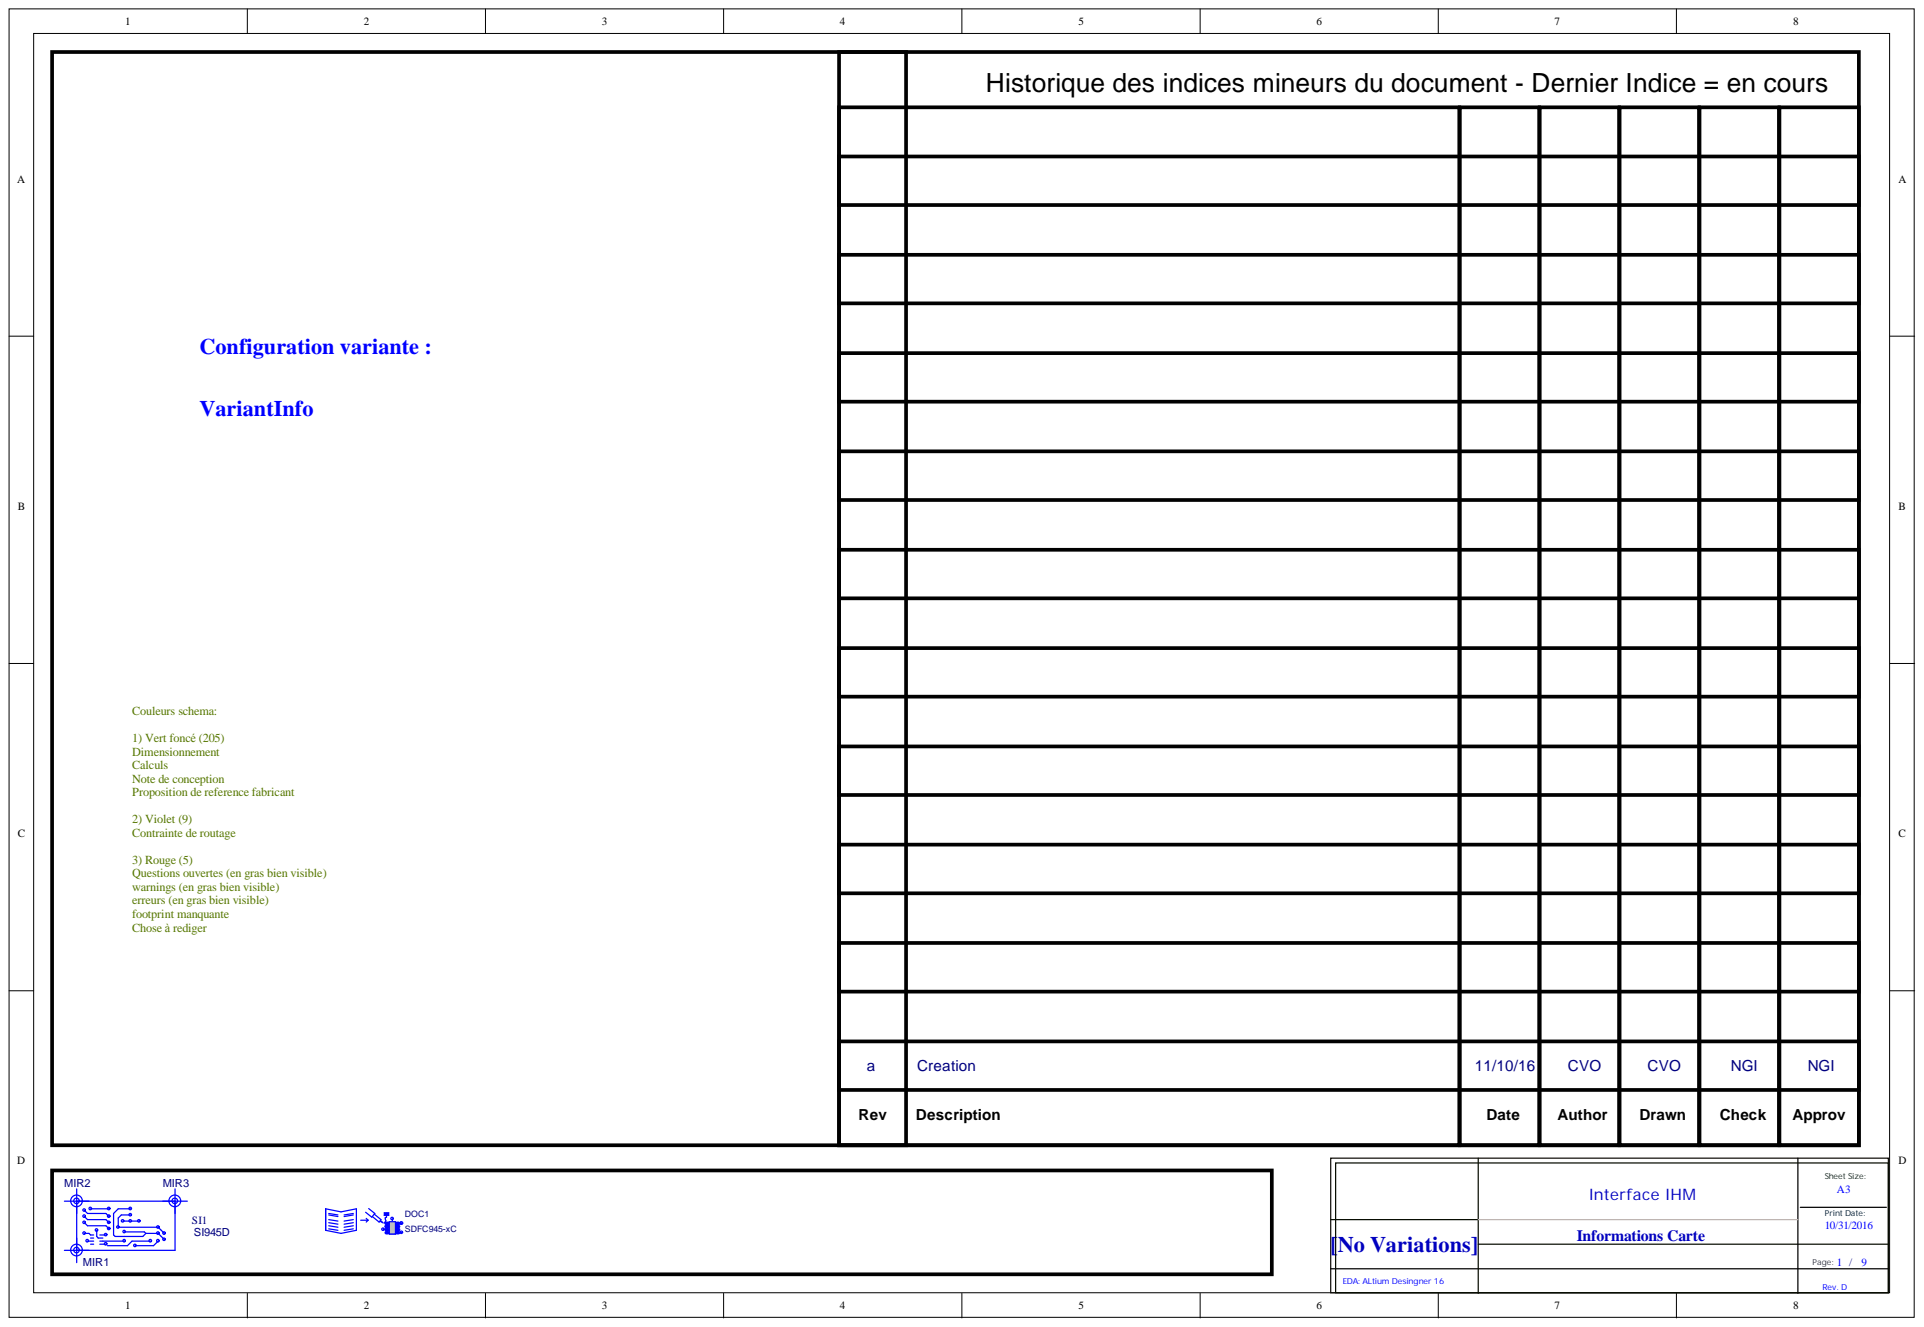
[picture p52: page 1]

a | Cr e atio n | 1 1/1 0/1 6 | CV O | CV O | NGI | NGI

Re v | De s cription | Da t e | Author | Drawn | Che c k | Approv

Inte rfa ce IH M | Shee t Size : A 3

[No Variations] | Inform ati ons C arte

EDA : A Ltium Desin g ne r 1 6 | | Rev. D

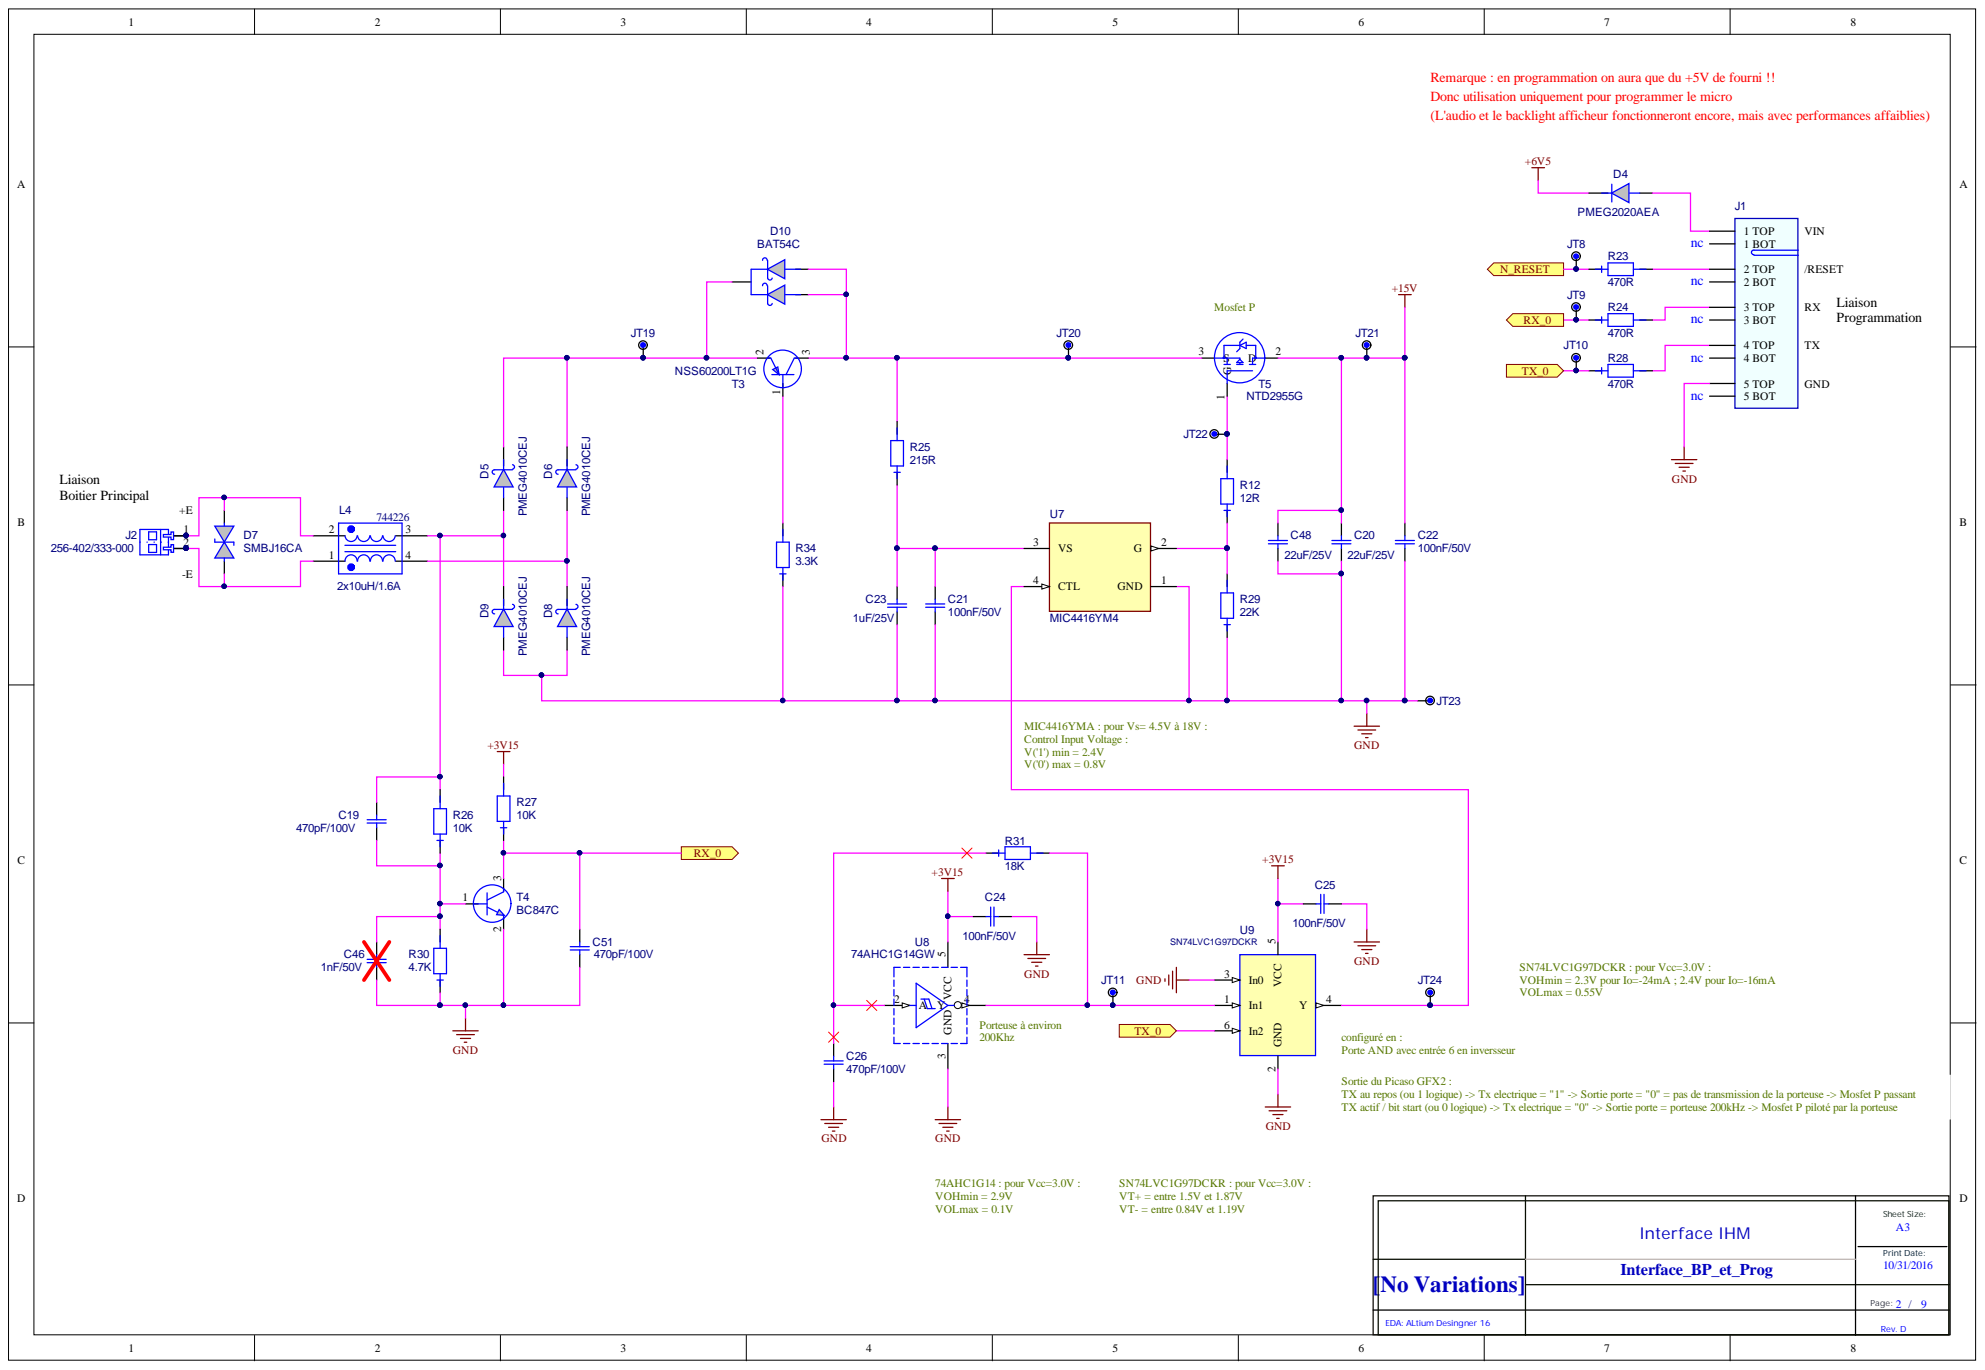
[picture p53: page 2]

Remarque : en programmation on aura que du +5V de fourni !!
Donc utilisation uniquement pour programmer le micro
(L'audio et le backlight afficheur fonctionneront encore, mais avec performances affaiblies)

SN74LVC1G97DCKR : pour Vcc=3.0V :
VOHmin = 2.3V pour Io=-24mA ; 2.4V pour Io=-16mA
VOLmax = 0.55V

configuré en :
Porte AND avec entrée 6 en inversseur

Sortie du Picaso GFX2 :
TX au repos (ou 1 logique) -> Tx electrique = "1" -> Sortie porte = "0" = pas de transmission de la porteuse -> Mosfet P passant
TX actif / bit start (ou 0 logique) -> Tx electrique = "0" -> Sortie porte = porteuse 200kHz -> Mosfet P piloté par la porteuse

[No Variations] | Interface_BP_et_Prog

Page: 2 / 9

EDA: ALtium Desingner 16 | | Rev. D

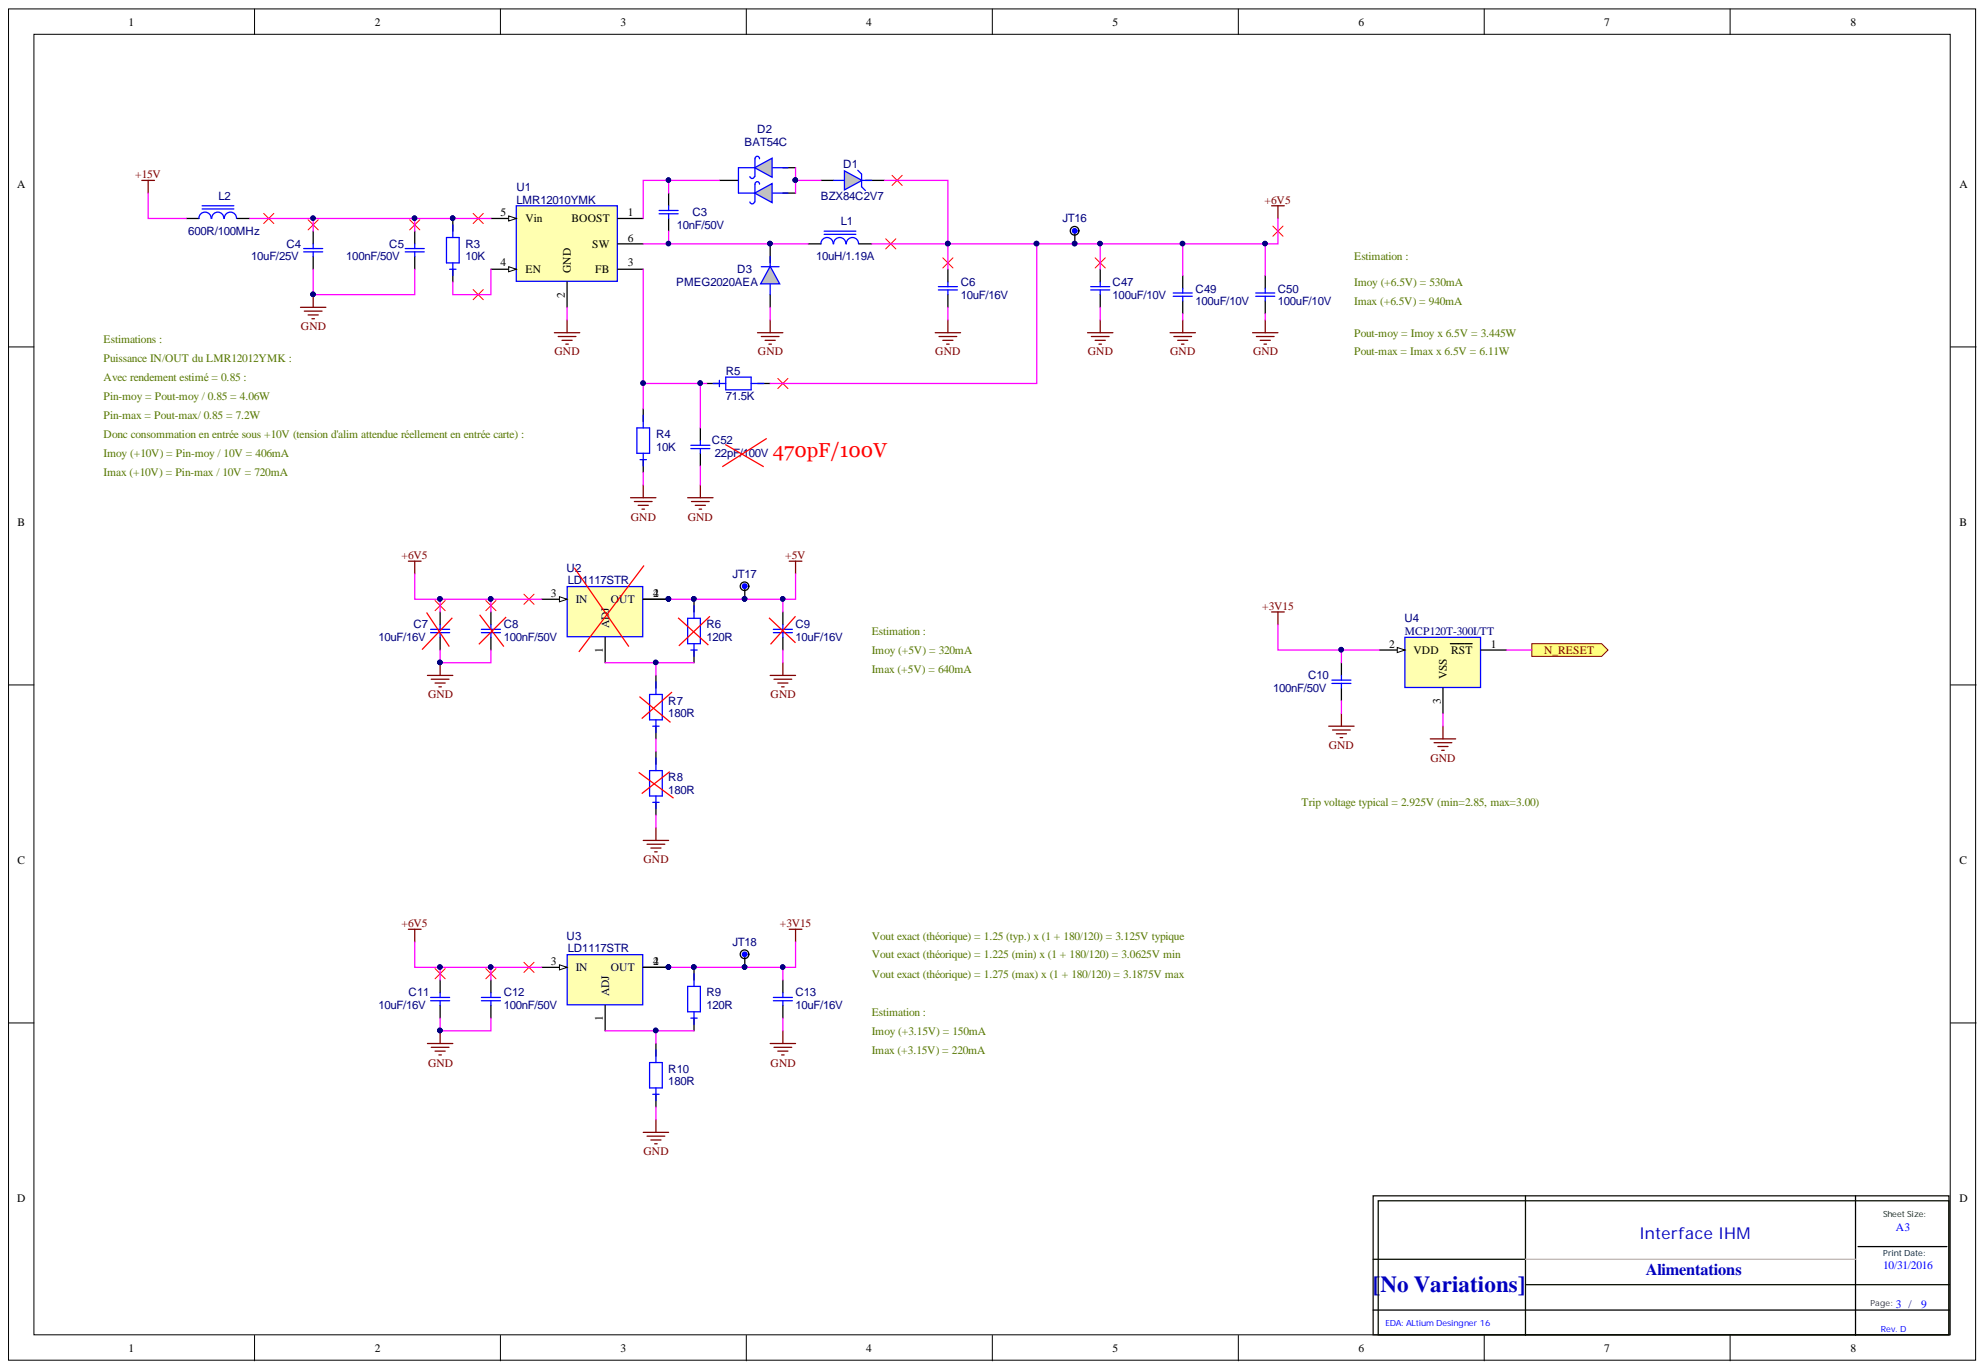
[picture p54: page 3]

Puissance IN/OUT du LMR12012YMK :
Avec rendement estimé = 0.85 :

Pin-moy = Pout-moy / 0.85 = 4.06W
Pin-max = Pout-max/ 0.85 = 7.2W

Donc consommation en entrée sous +10V (tension d'alim attendue réellement en entrée carte) :
Imoy (+10V) = Pin-moy / 10V = 406mA
Imax (+10V) = Pin-max / 10V = 720mA

Trip voltage typical = 2.925V (min=2.85, max=3.00)

Vout exact (théorique) = 1.25 (typ.) x (1 + 180/120) = 3.125V typique
Vout exact (théorique) = 1.225 (min) x (1 + 180/120) = 3.0625V min

Vout exact (théorique) = 1.275 (max) x (1 + 180/120) = 3.1875V max

[No Variations] | Alimentations

Page: 3 / 9

EDA: ALtium Desingner 16

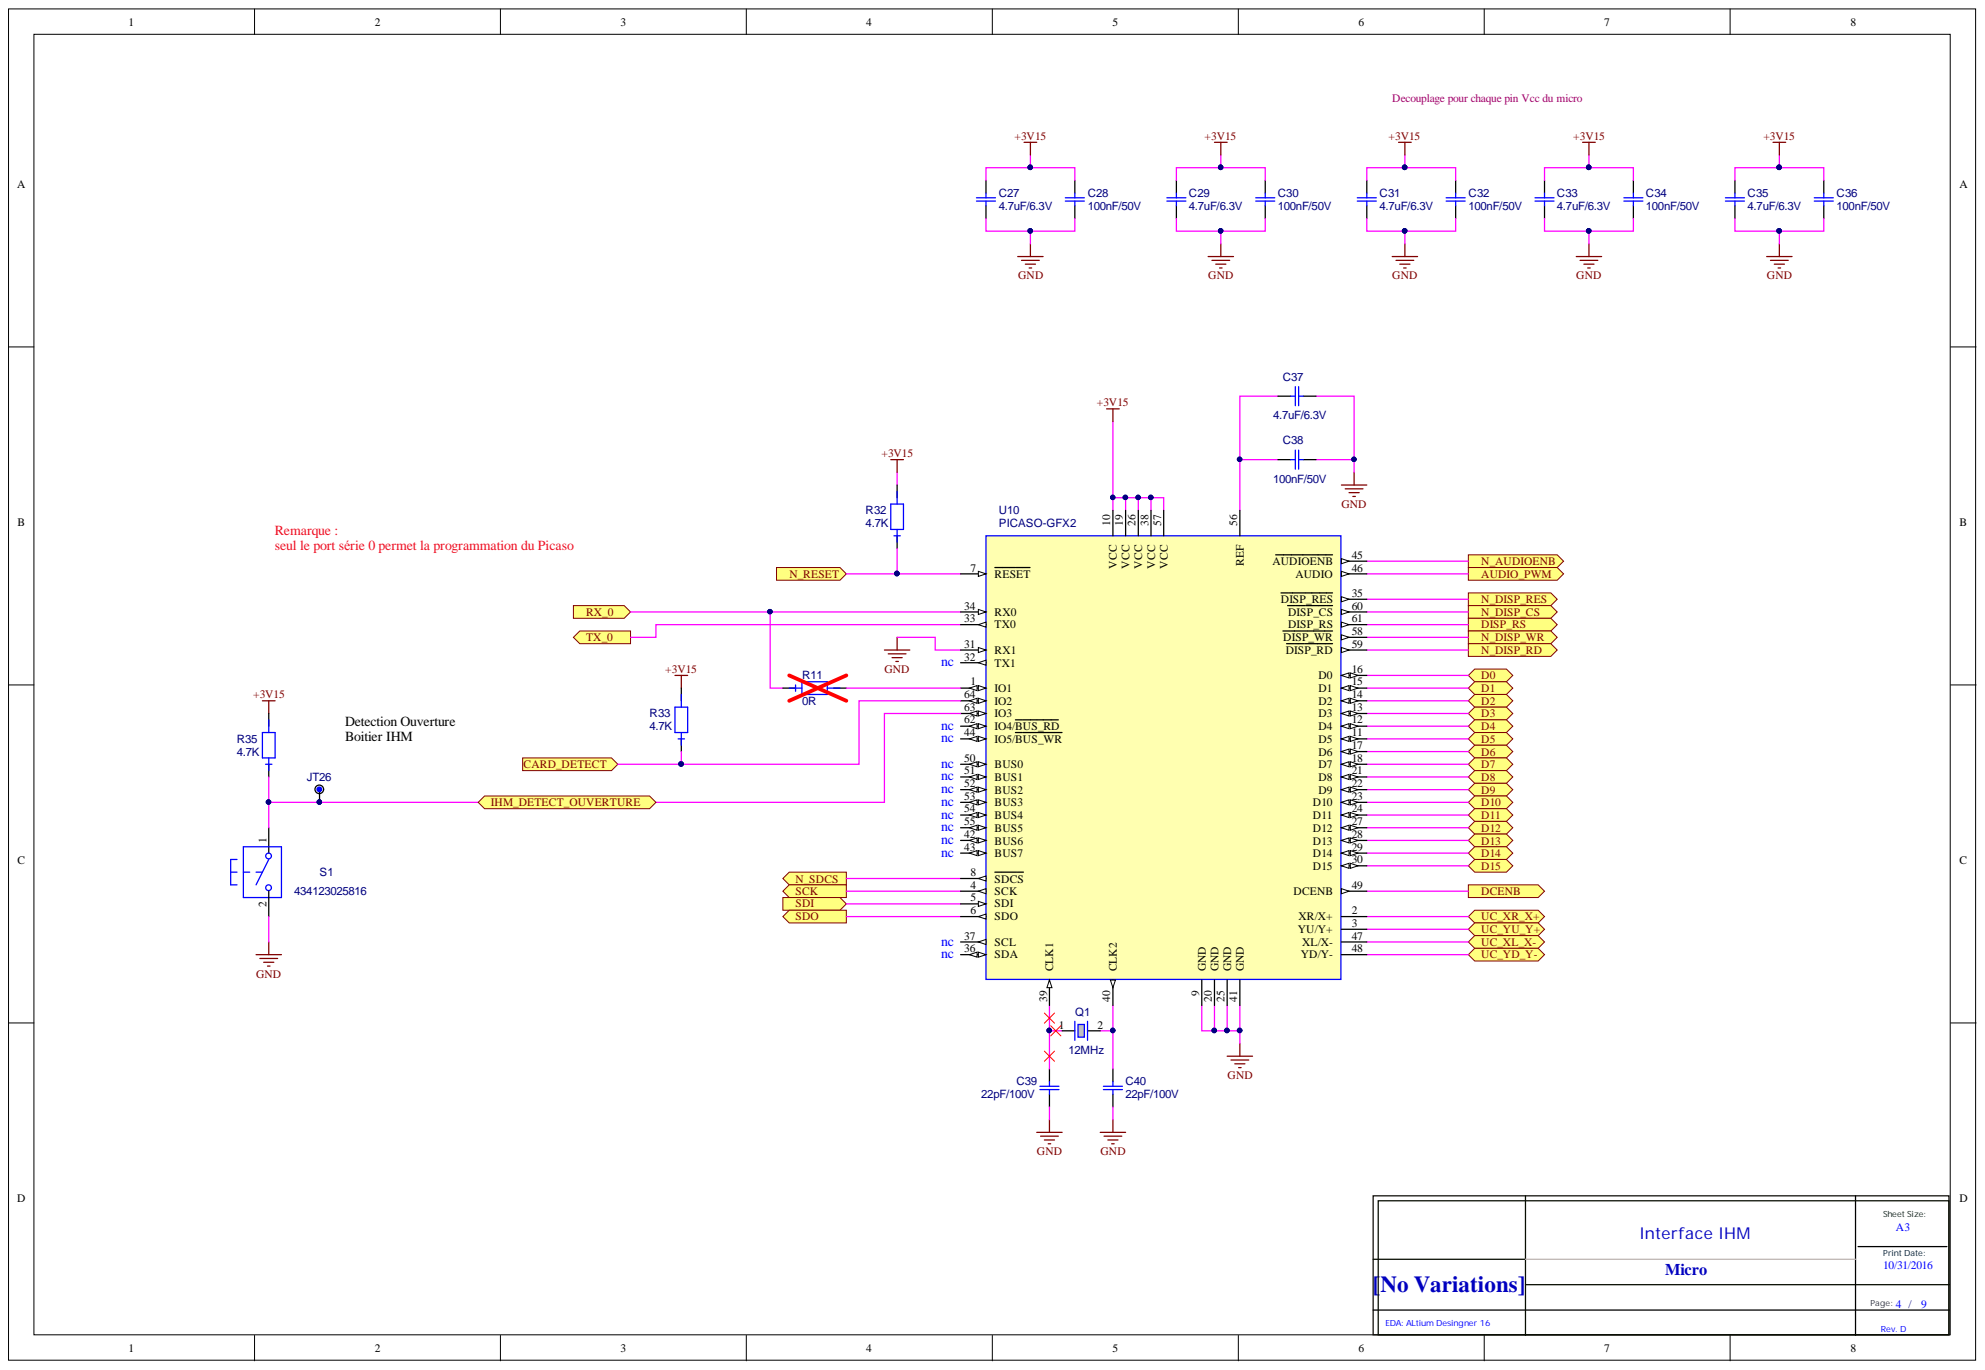
[picture p55: page 4]

Decouplage pour chaque pin Vcc du micro

Remarque :
seul le port série 0 permet la programmation du Picaso

[No Variations] | Micro

Page: 4 / 9

EDA: ALtium Desingner 16

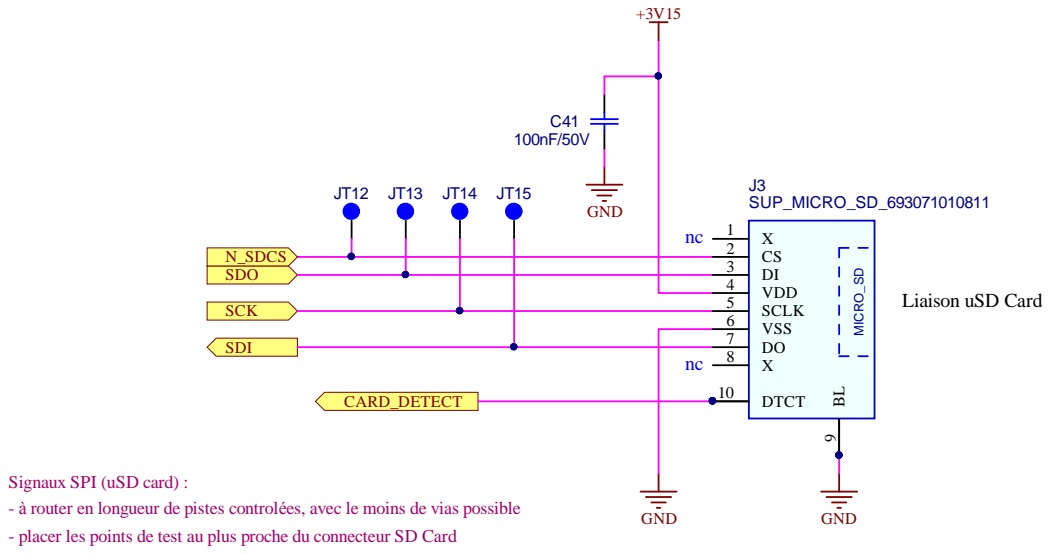
[picture p56: page 5]

Signaux SPI (uSD card) :
- à router en longueur de pistes controlées, avec le moins de vias possible
- placer les points de test au plus proche du connecteur SD Card

[No Variations] | SD_Card

Page: 5 / 9

EDA: ALtium Desingner 16

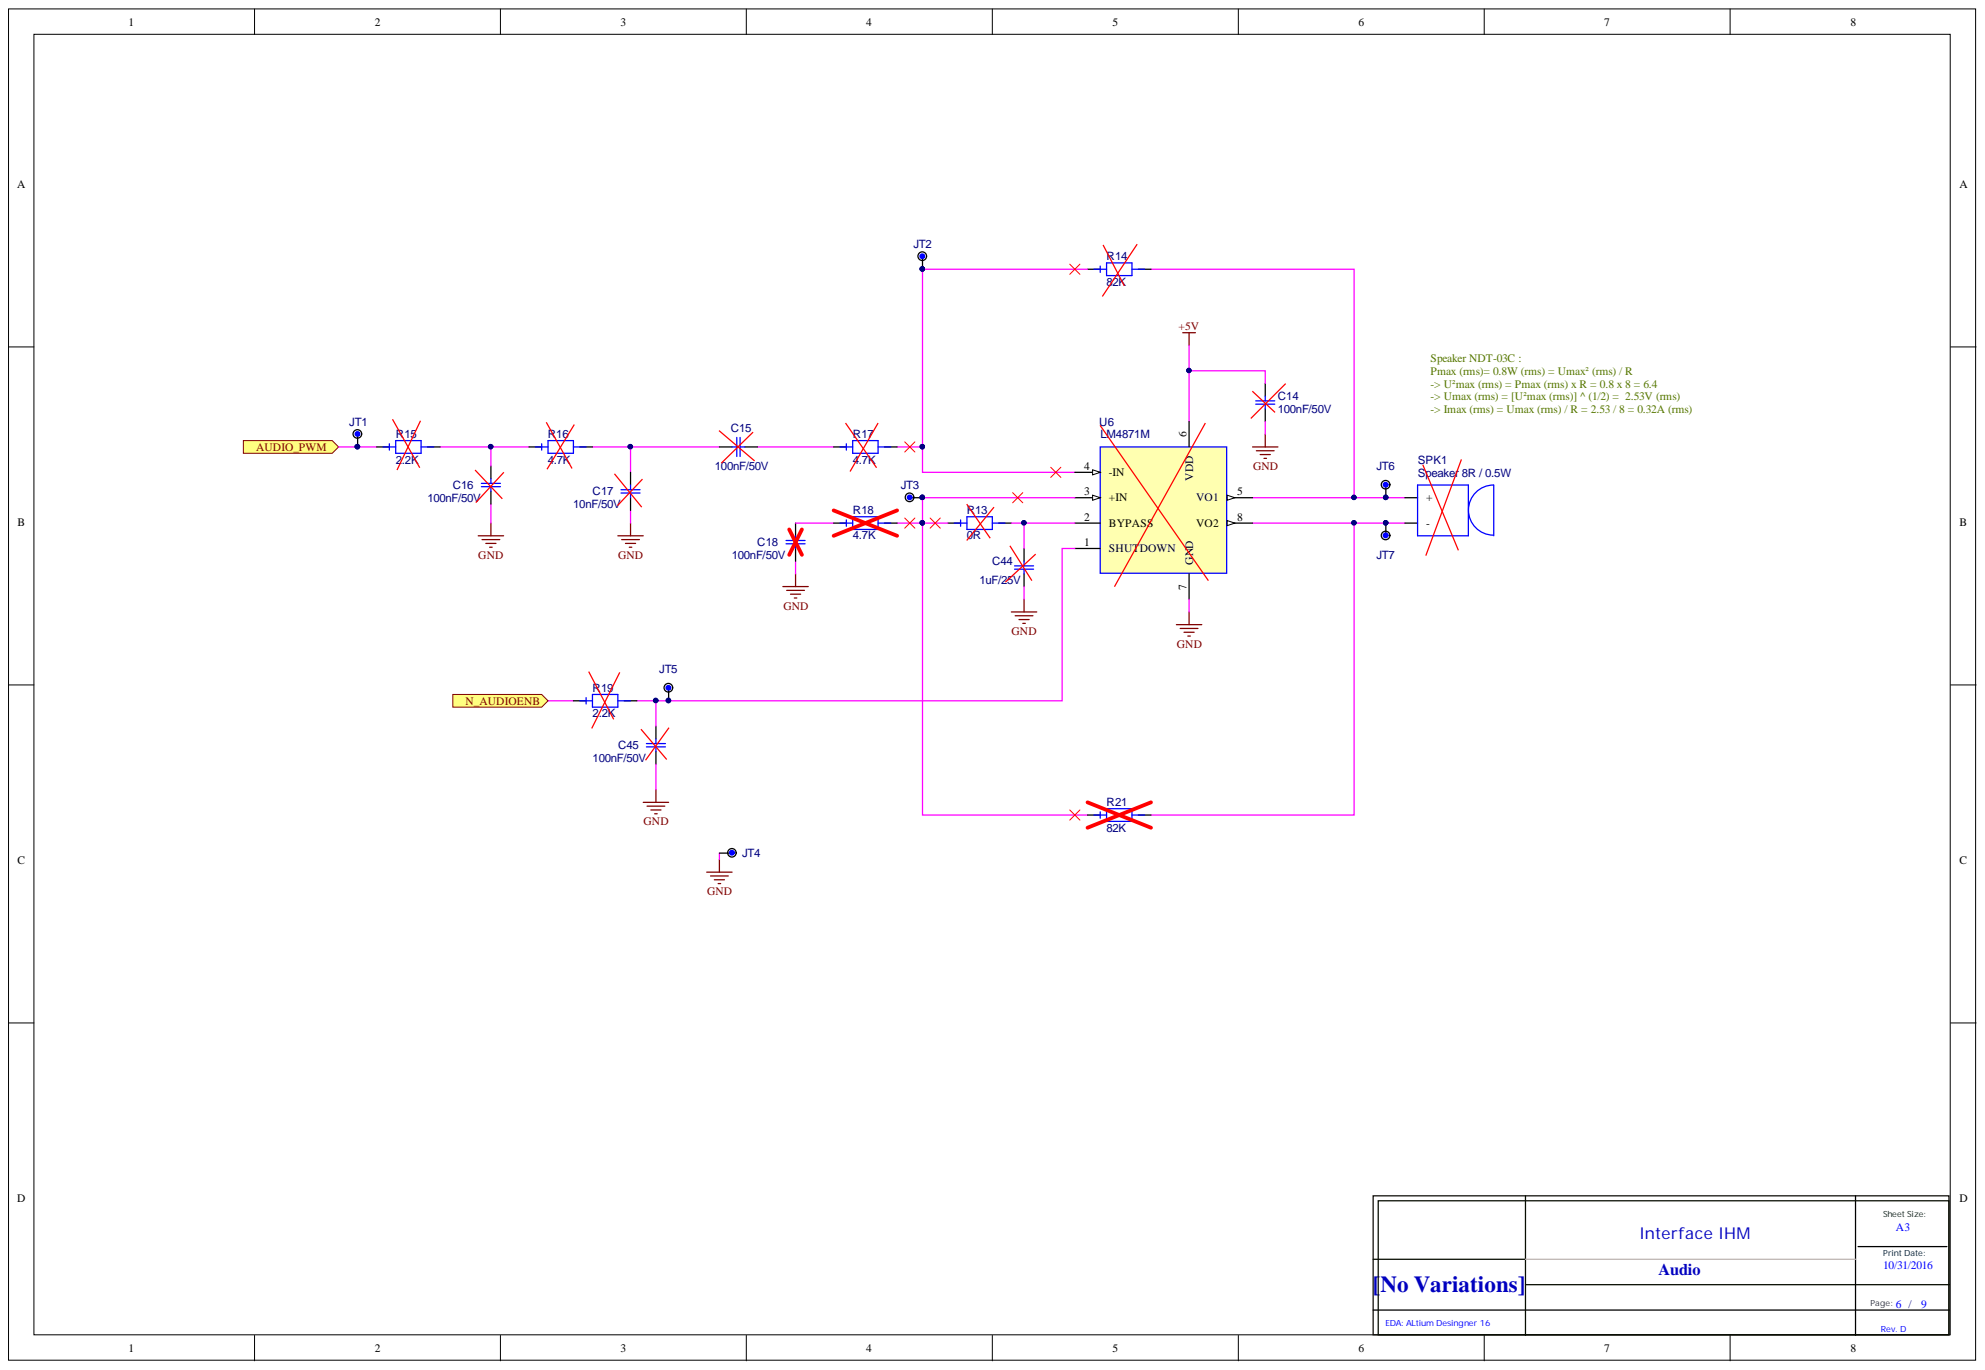
[picture p57: page 6]

Speaker NDT-03C :
Pmax (rms)= 0.8W (rms) = Umax² (rms) / R
-> U²max (rms) = Pmax (rms) x R = 0.8 x 8 = 6.4
-> Umax (rms) = [U²max (rms)] ^ (1/2) = 2.53V (rms)
-> Imax (rms) = Umax (rms) / R = 2.53 / 8 = 0.32A (rms)

LM4871M -IN 4 | 6 GND 7

SHUTDOWN 1

[No Variations] | Audio

Page: 6 / 9

EDA: ALtium Desingner 16

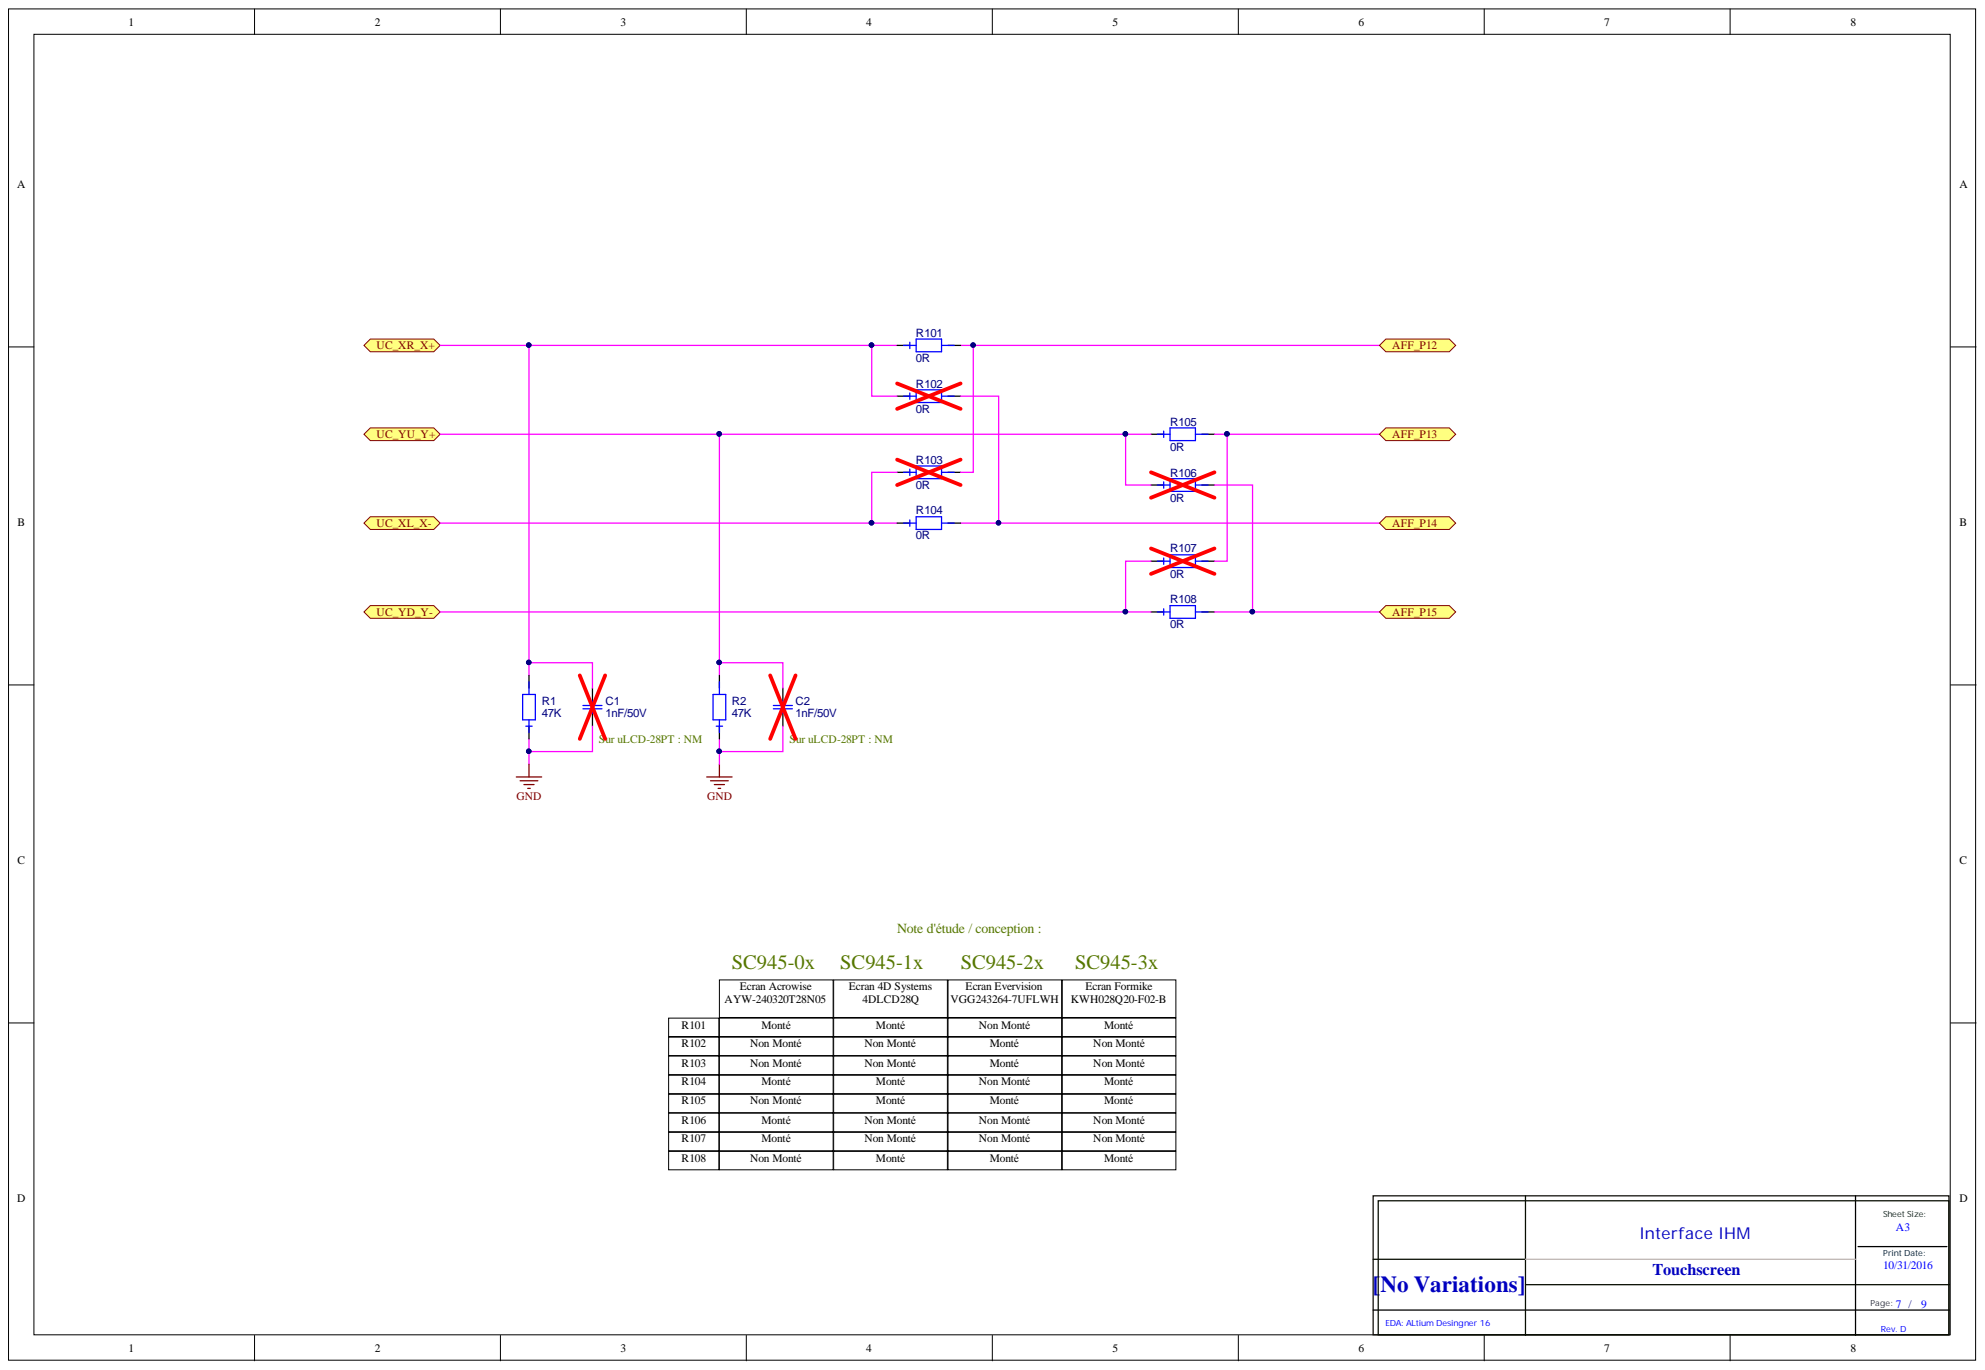
[picture p58: page 7]

E c r an A c r o w i s e A YW-2 4 0 3 2 0 T 2 8 N 0 5 | E c r an 4 D S y s t e m s 4 D L C D 2 8 Q | E c r an E v e rv i s i o n V G G 2 4 3 2 6 4 -7 U F LWH | E c r an F o rm i ke KWH 0 2 8 Q 2 0 -F 0 2 -B

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

[No Variations] | Touchscreen

EDA : A Ltium Desin g ne r 1 6 | | Rev. D

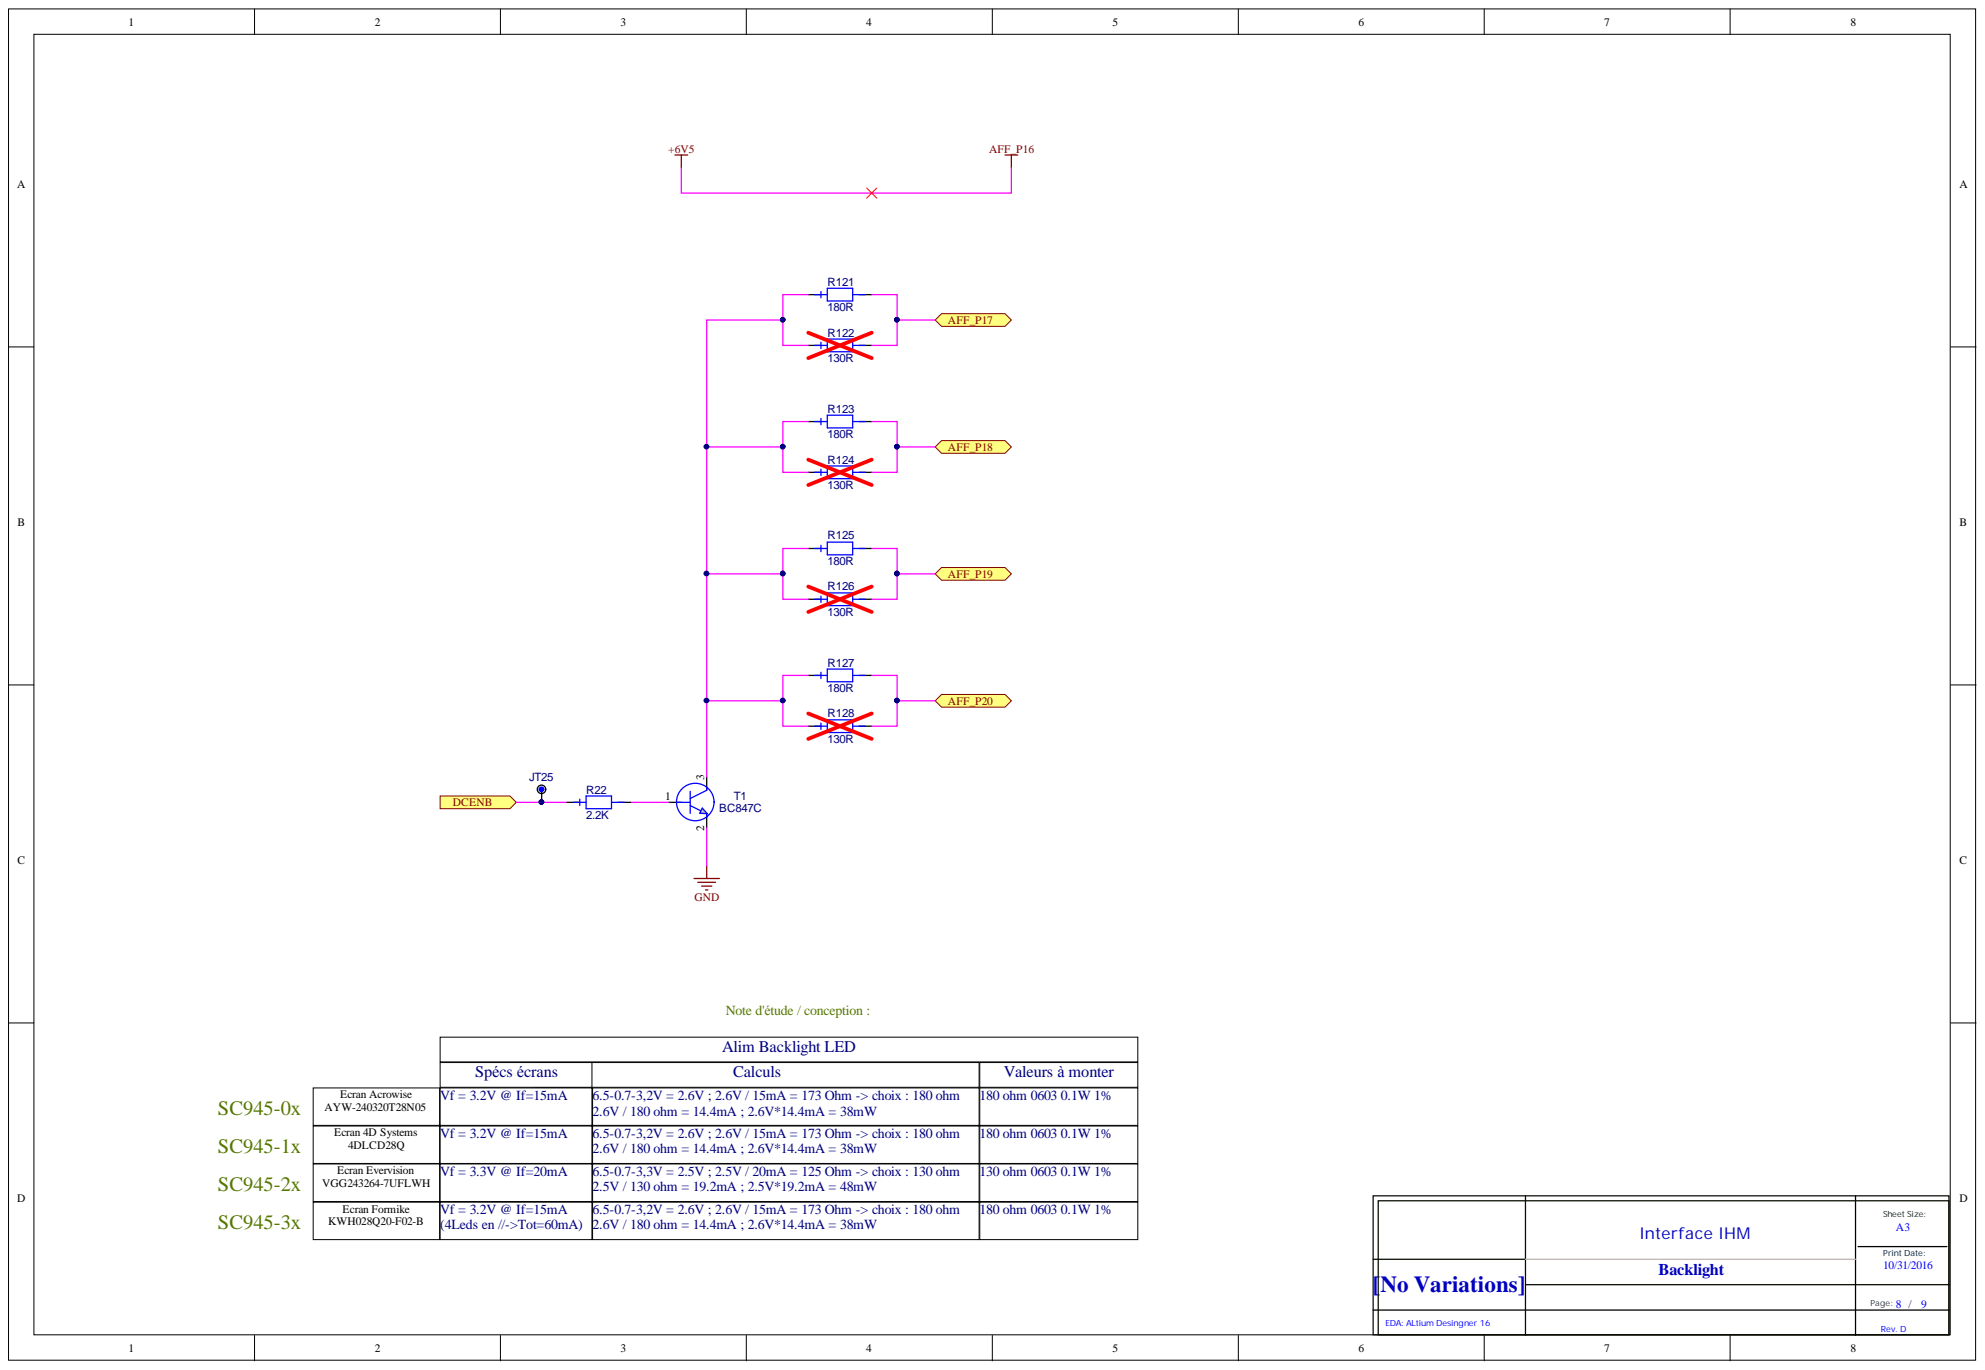
[picture p59: page 8]

Spécs écrans | | Calculs | Valeurs à monter

Ecran Acrowise AYW-240320T28N05 | Vf = 3.2V @ If=15mA | 6.5-0.7-3,2V = 2.6V ; 2.6V / 15mA = 173 Ohm -> choix : 180 ohm 2.6V / 180 ohm = 14.4mA ; 2.6V*14.4mA = 38mW | 180 ohm 0603 0.1W 1%

Ecran 4D Systems 4DLCD28Q | Vf = 3.2V @ If=15mA | 6.5-0.7-3,2V = 2.6V ; 2.6V / 15mA = 173 Ohm -> choix : 180 ohm 2.6V / 180 ohm = 14.4mA ; 2.6V*14.4mA = 38mW | 180 ohm 0603 0.1W 1%

Ecran Evervision VGG243264-7UFLWH | Vf = 3.3V @ If=20mA | 6.5-0.7-3,3V = 2.5V ; 2.5V / 20mA = 125 Ohm -> choix : 130 ohm 2.5V / 130 ohm = 19.2mA ; 2.5V*19.2mA = 48mW | 130 ohm 0603 0.1W 1%

[No Variations] | Backlight

Page: 8 / 9

EDA: ALtium Desingner 16

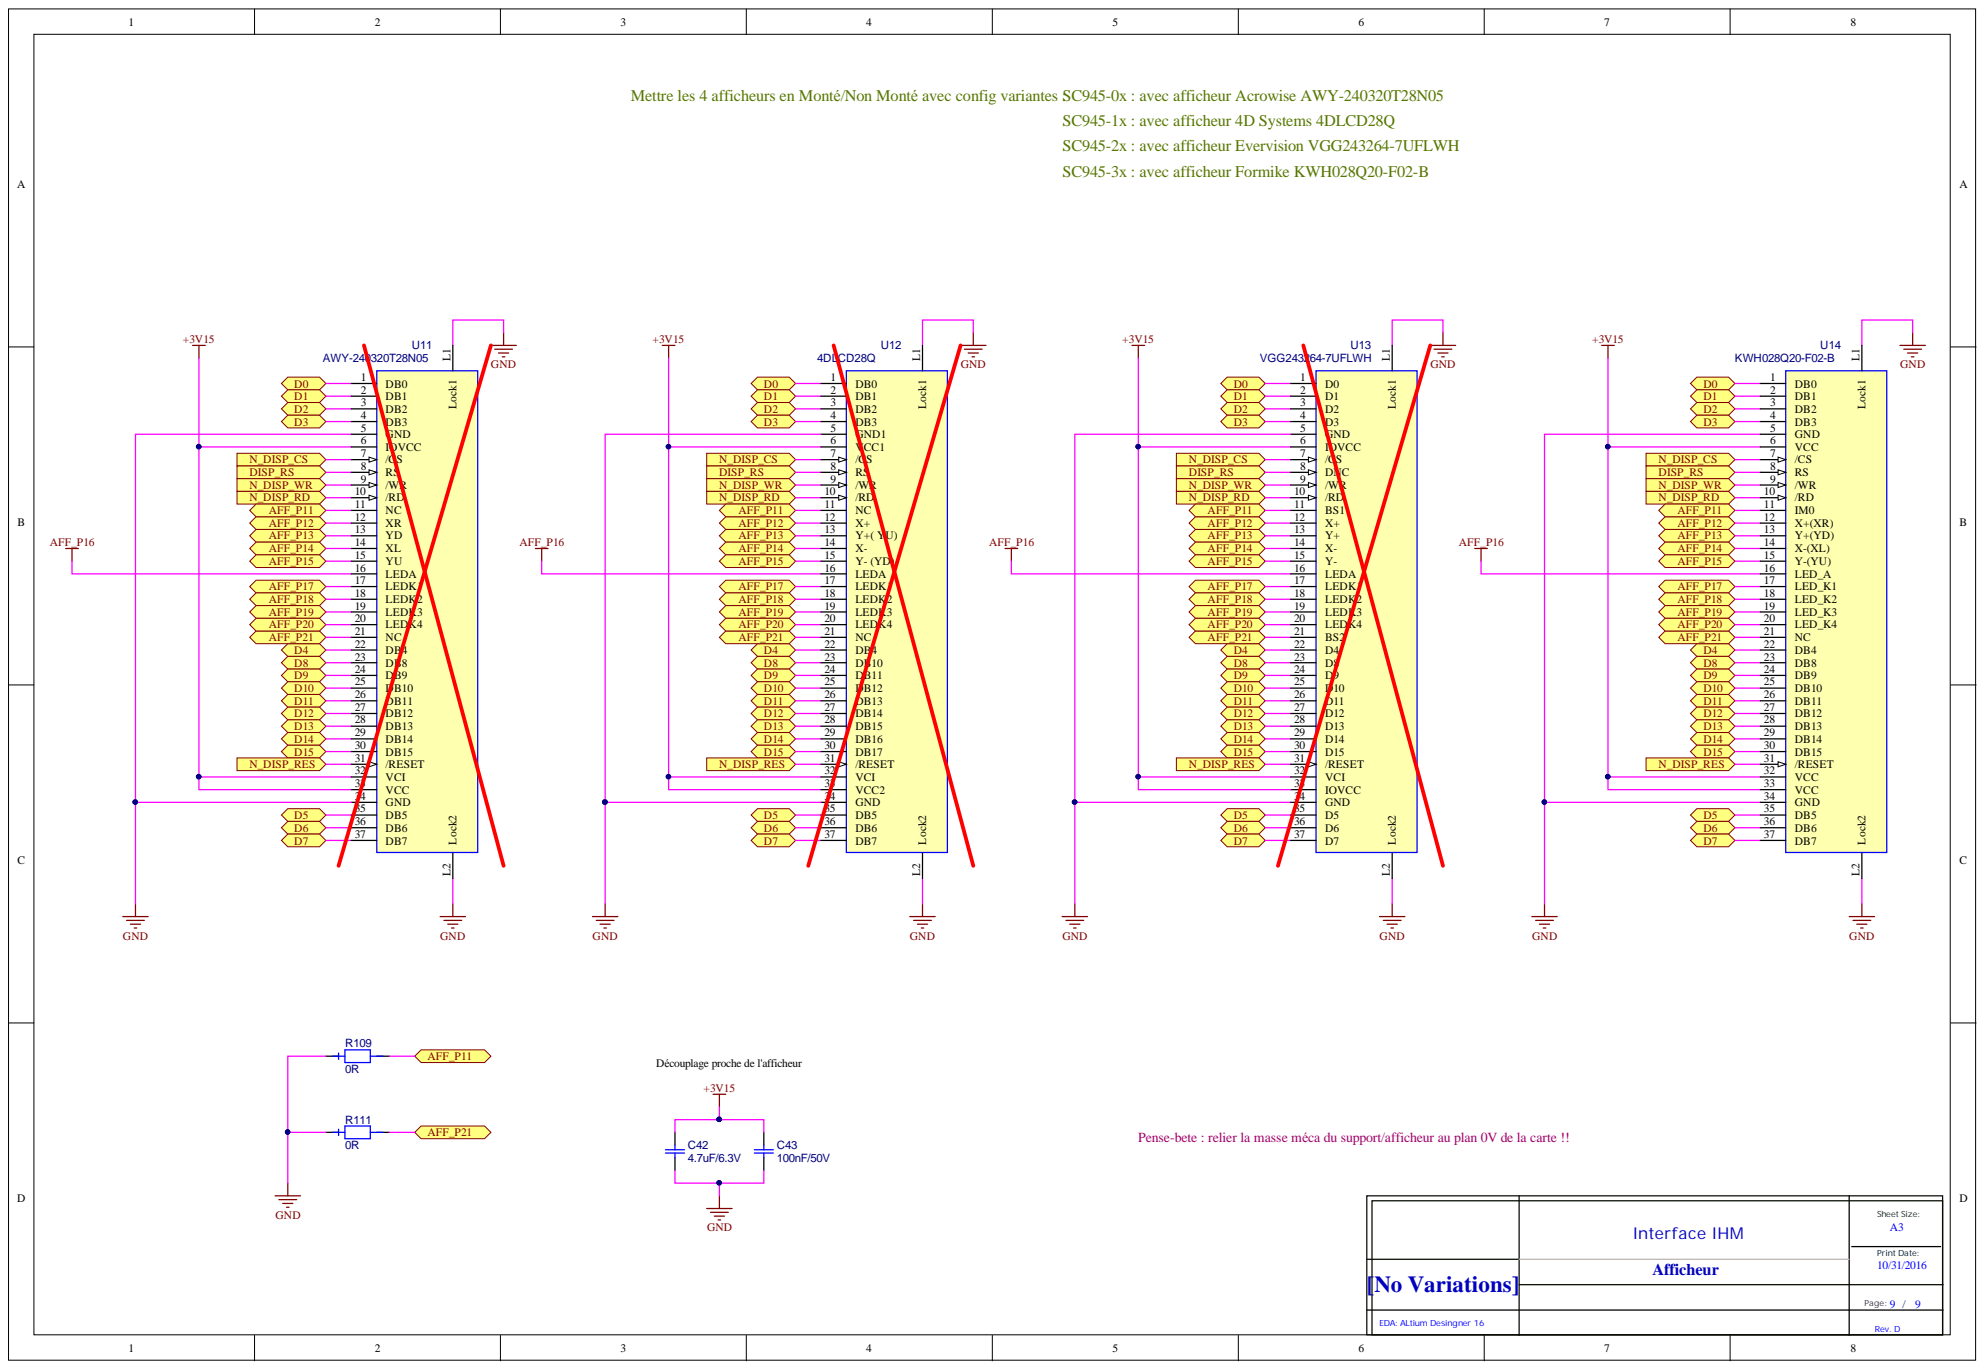
[picture p60: page 9]

tre les 4 afficheurs en Mo

[No Variations] | Afficheur

EDA : A Ltium Desin g ne r 1 6 | | Rev. D
