essensys-hub/essensys-board-SC945D/Assembly Drawings_[No Variations].pdf

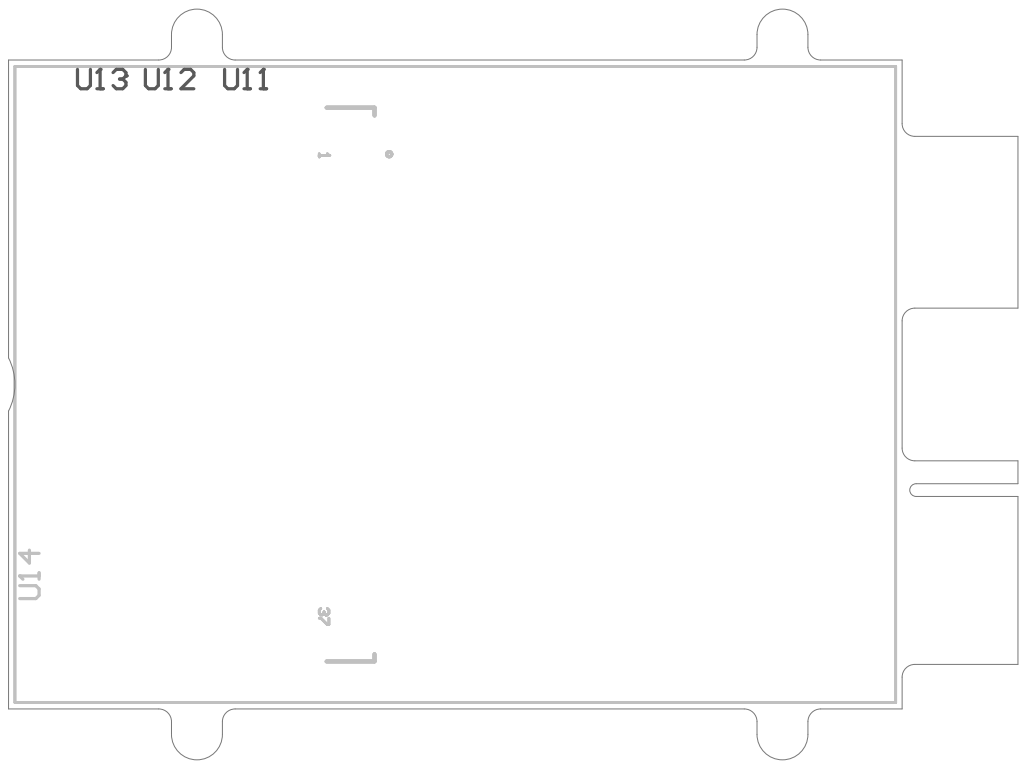
[picture p61: page 1]
PAU110L2 PAU110H2; PAU120L2 PAU120H2; PAU130L2 PAU130H2; PAU11016 PAU12016 PAU13016 PAU14016; PAU11011 PAU12011 PAU13011 PAU14011 PAU11012 PAU12012 PAU13012 PAU14012 PAU11013 PAU12013 PAU13013 PAU14013 PAU11014 PAU12014 PAU13014 PAU14014 PAU11015 PAU12015 PAU13015 PAU14015; PAU11017 PAU12017 PAU13017 PAU14017; PAU11018 PAU12018 PAU13018 PAU14018 PAU11019 PAU12019 PAU13019 PAU14019; PAU11020 PAU12020 PAU13020 PAU14020 PAU11021 PAU12021 PAU13021 PAU14021; PAU1101 PAU1201 PAU1301 PAU1401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

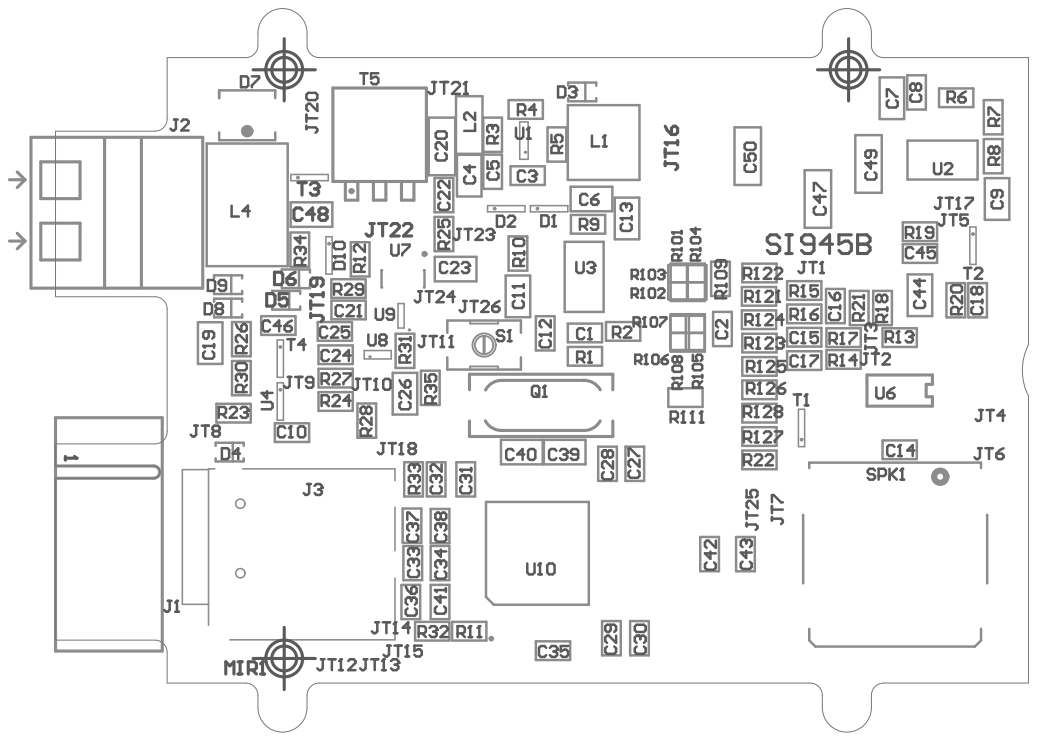
[picture p62: page 2]

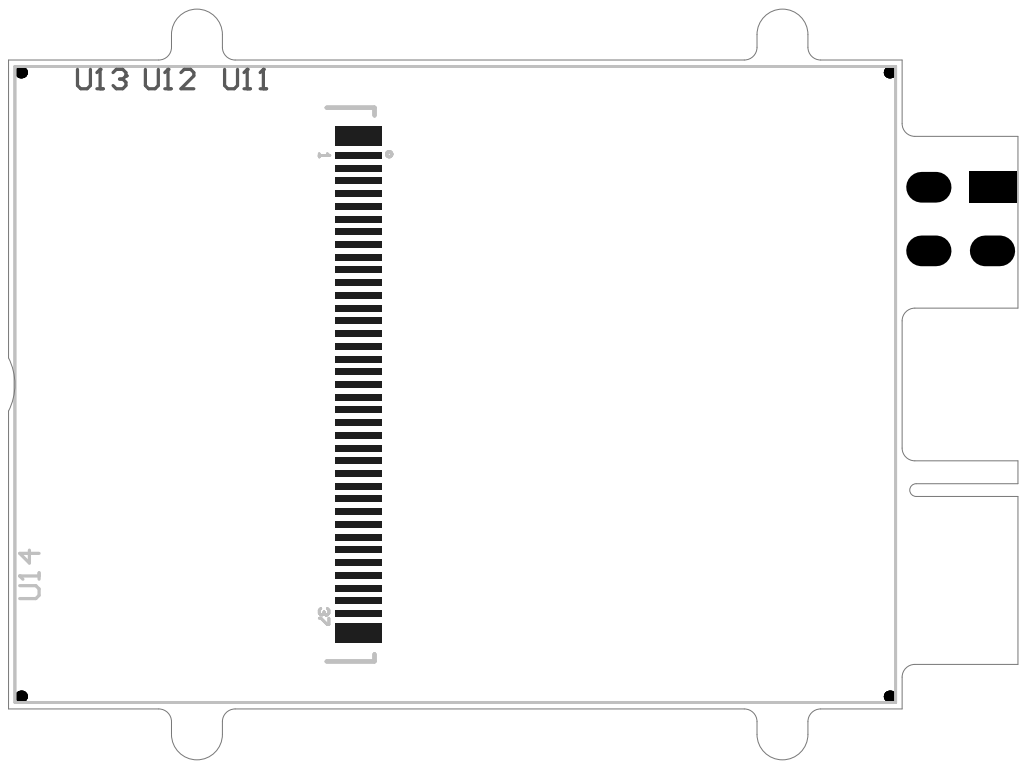
[picture p63: page 3]
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

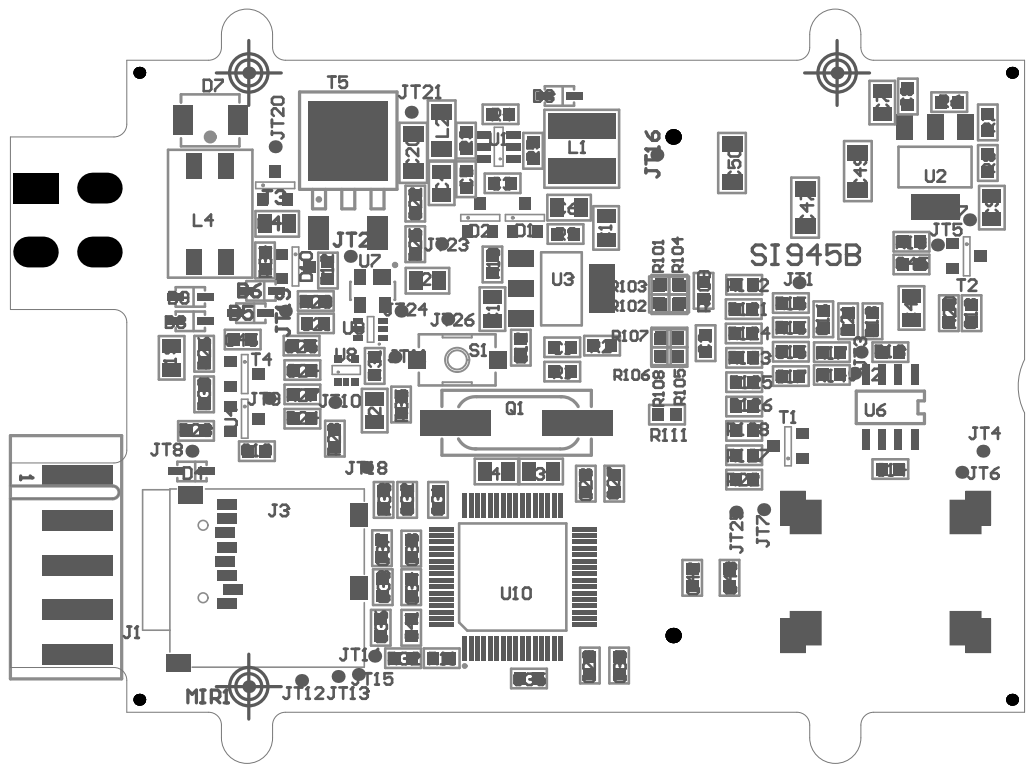
[picture p64: page 4]

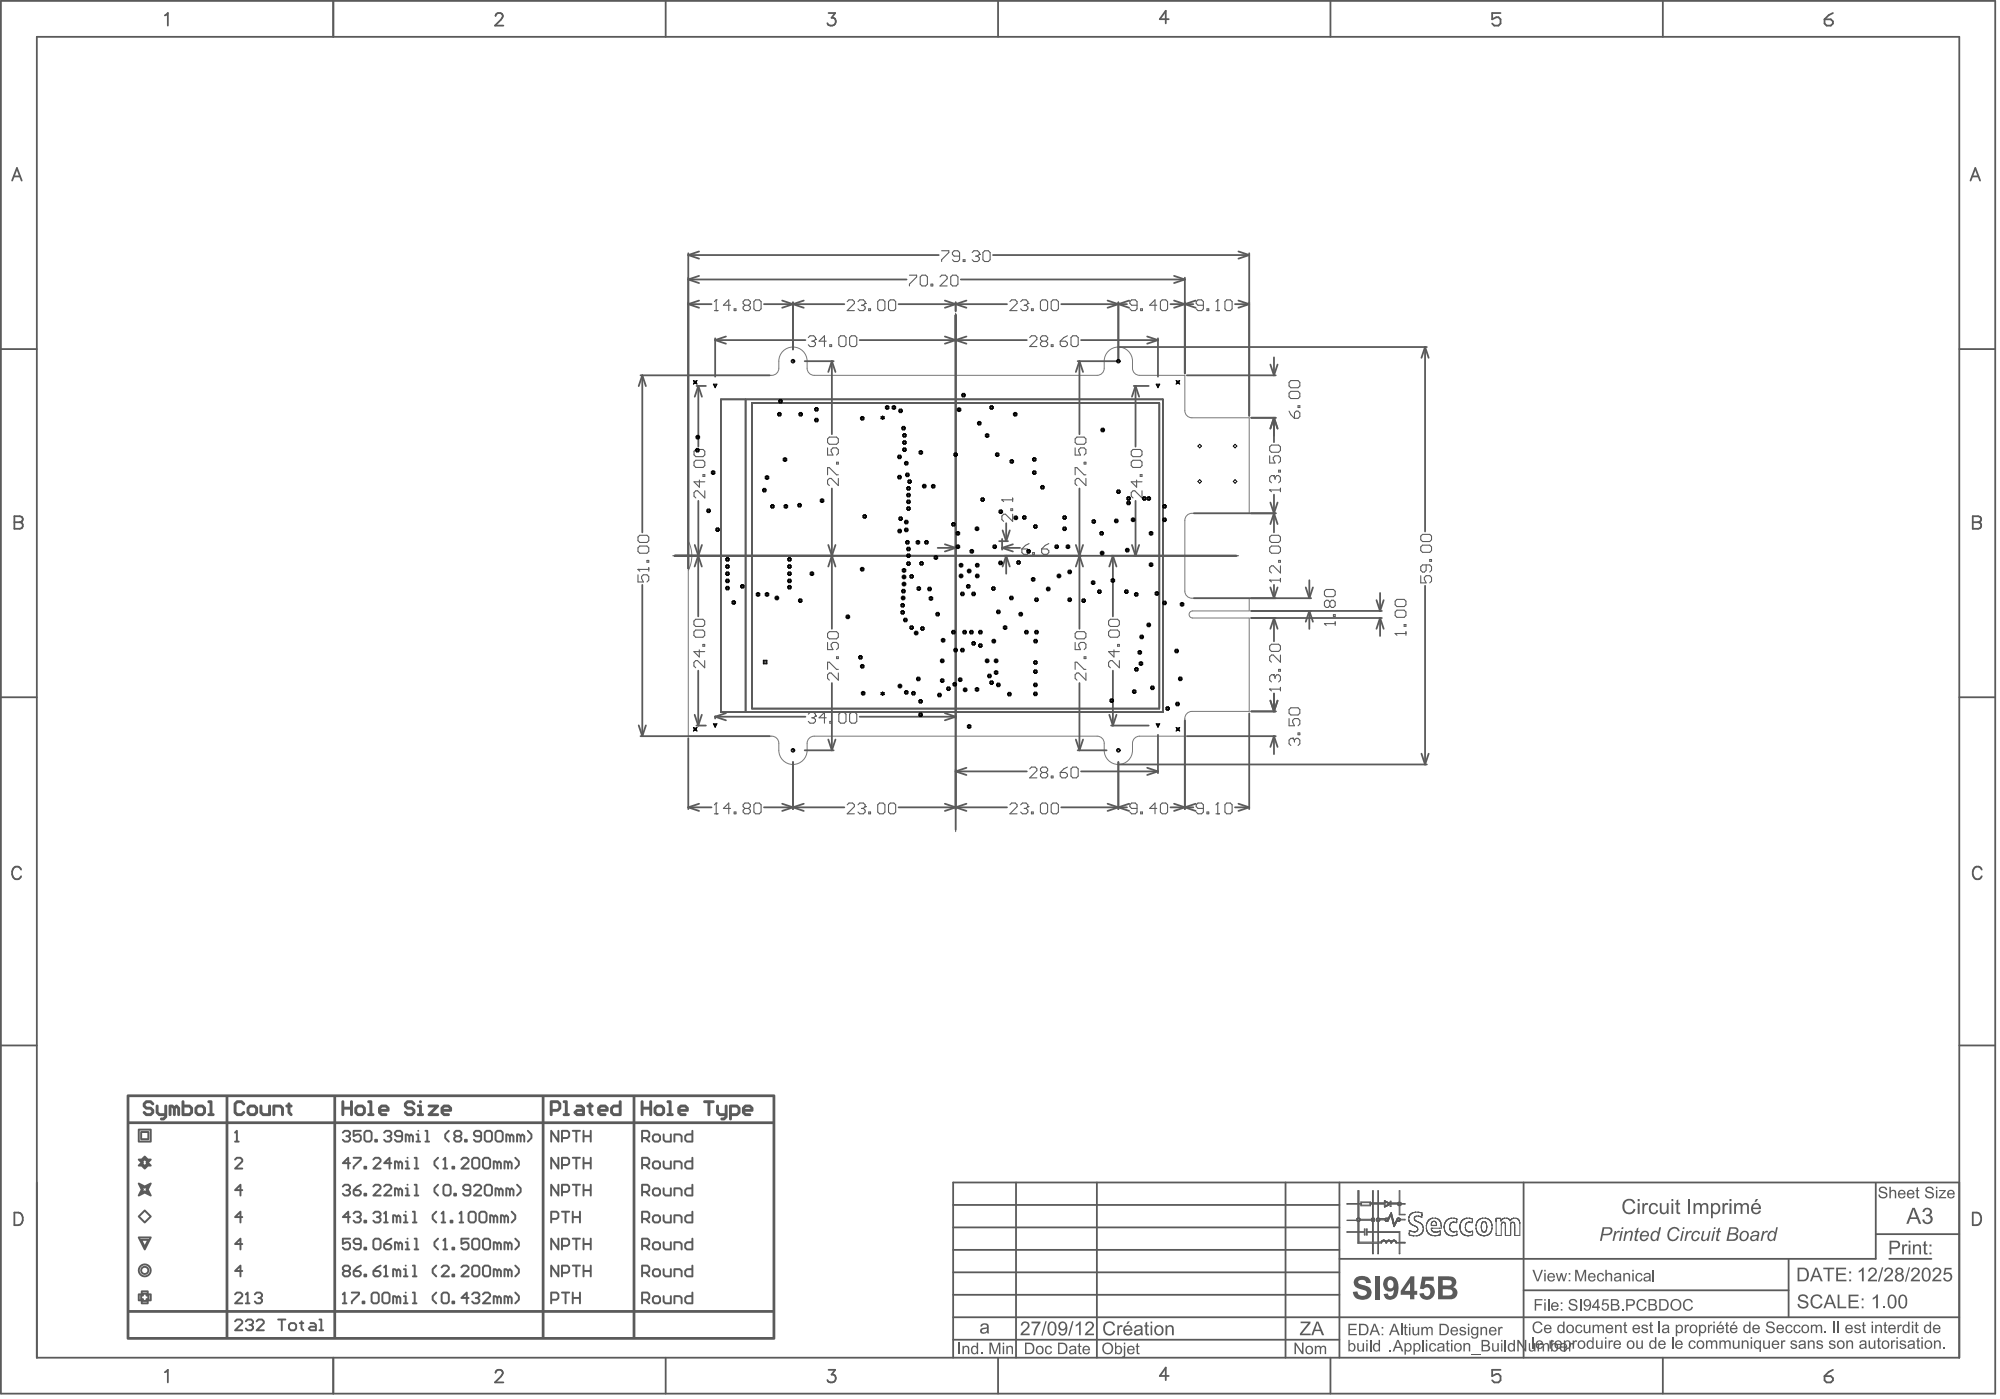
[picture p65: page 5]
