essensys-hub/essensys-board-SC945D/SC945D/Assembly/SC945D_Assembly.PDF

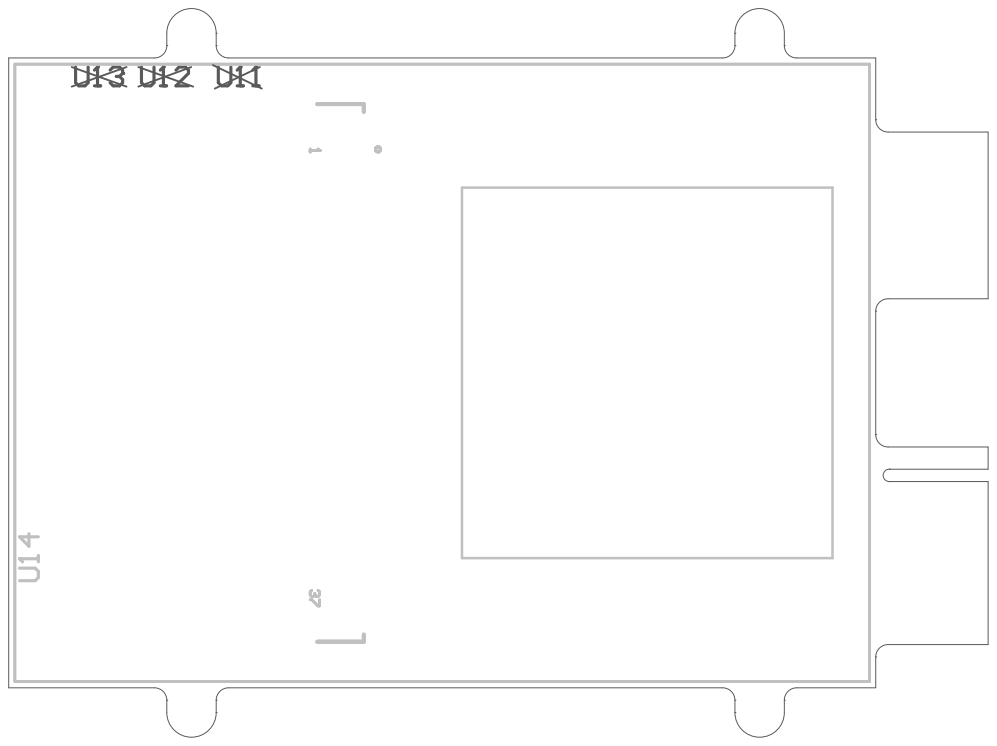
[picture p66: page 1]

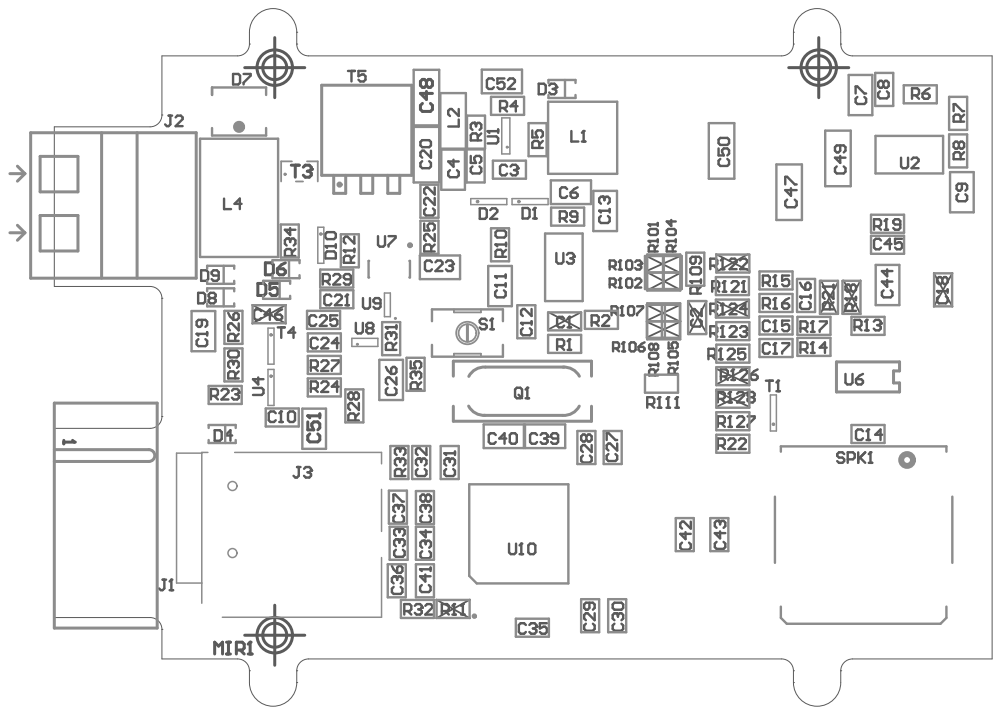
[picture p67: page 2]
