essensys-hub/essensys-board-SC945D/SC945D/Checks/SC945D_Mechanical.pdf

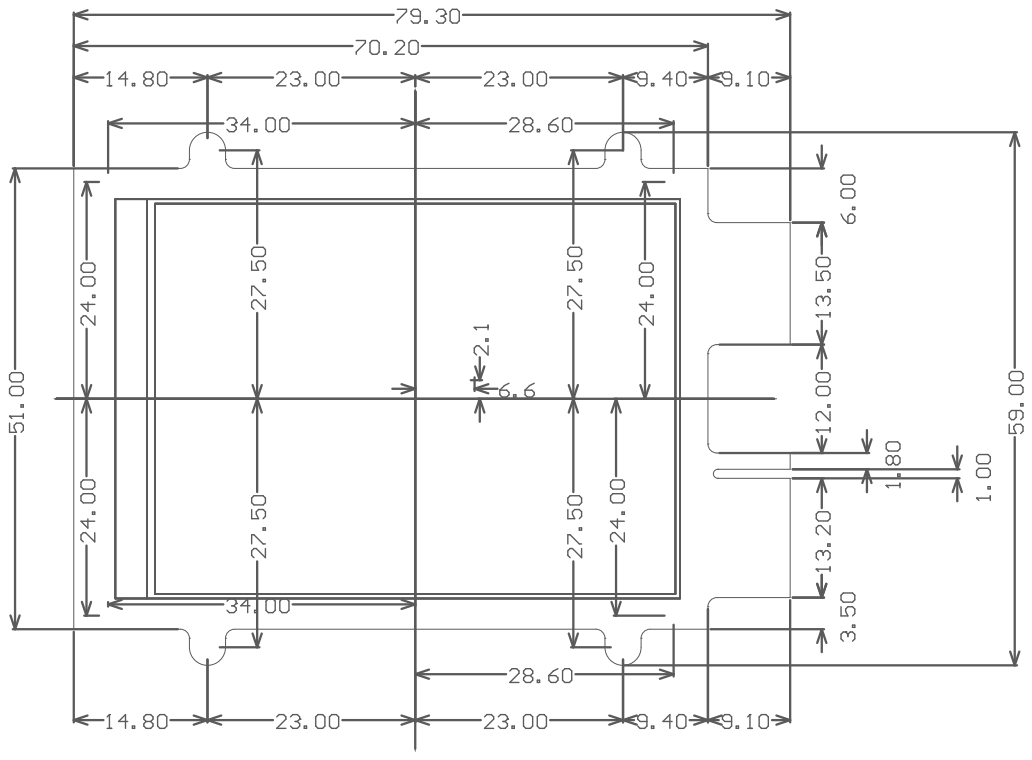
[picture p68: page 1]
