essensys-hub/essensys-board-SC945D/SC945D/Checks/SC945D_Drills.pdf

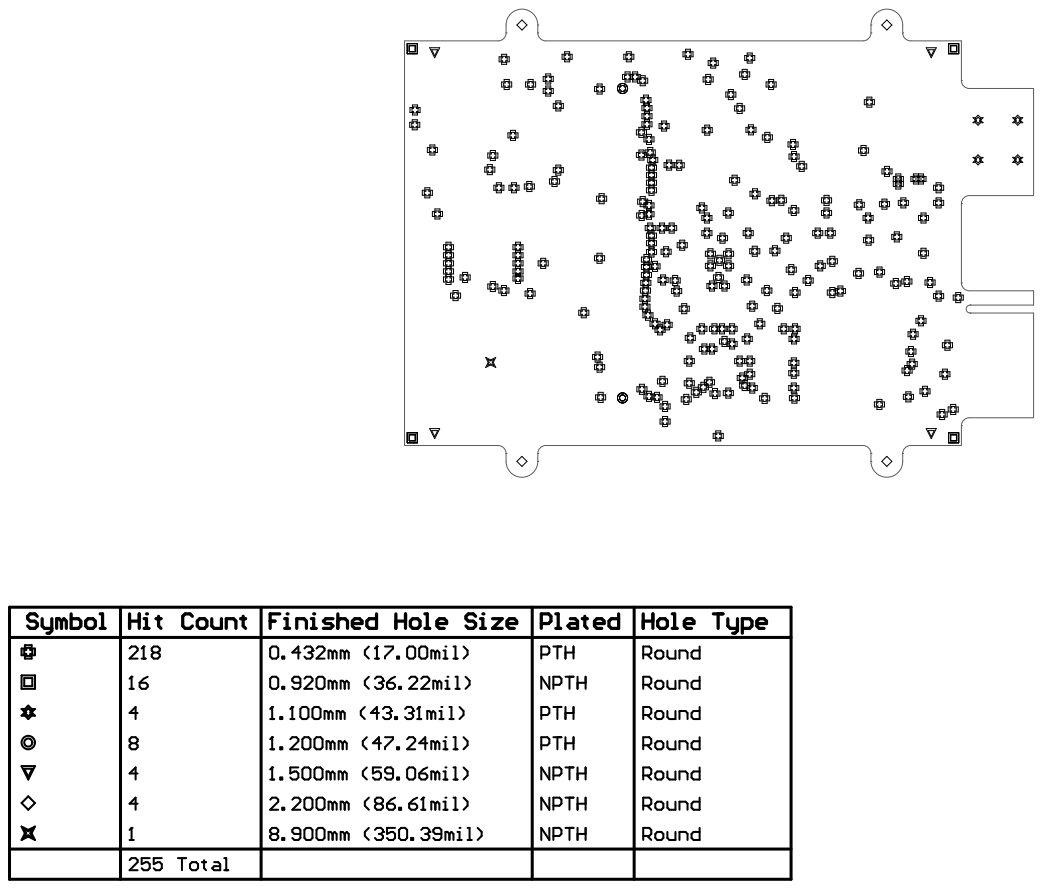
[picture p69: page 1]

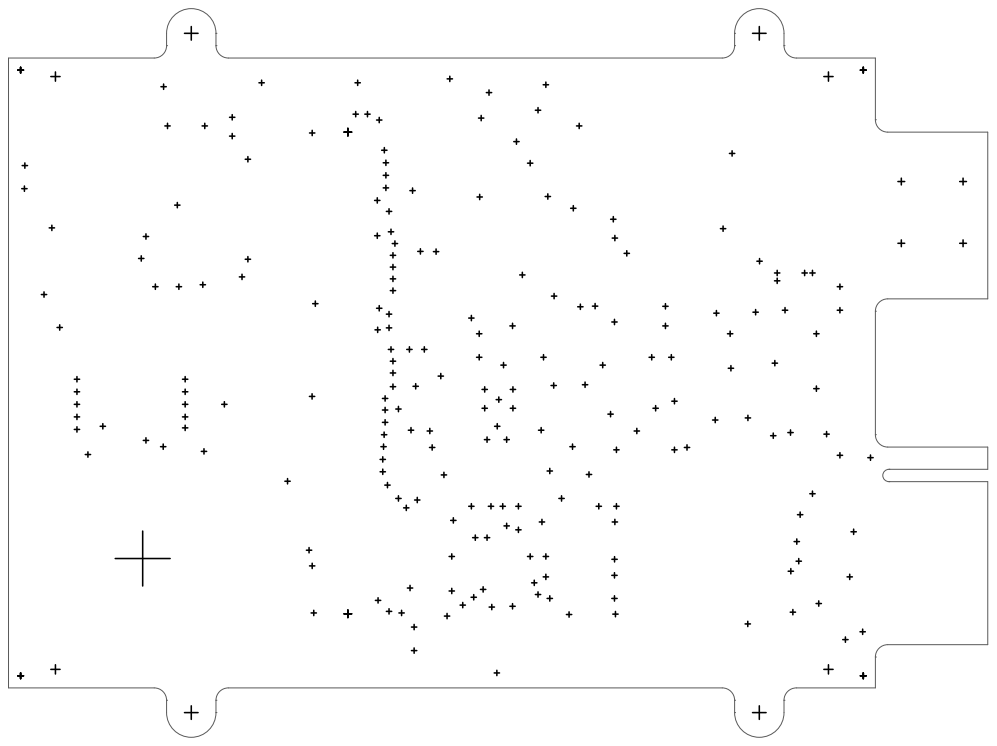
[picture p70: page 2]
