essensys-hub/essensys-board-SC945D/SC945D/Gerbers/Panel/SI945D panel drawing.pdf

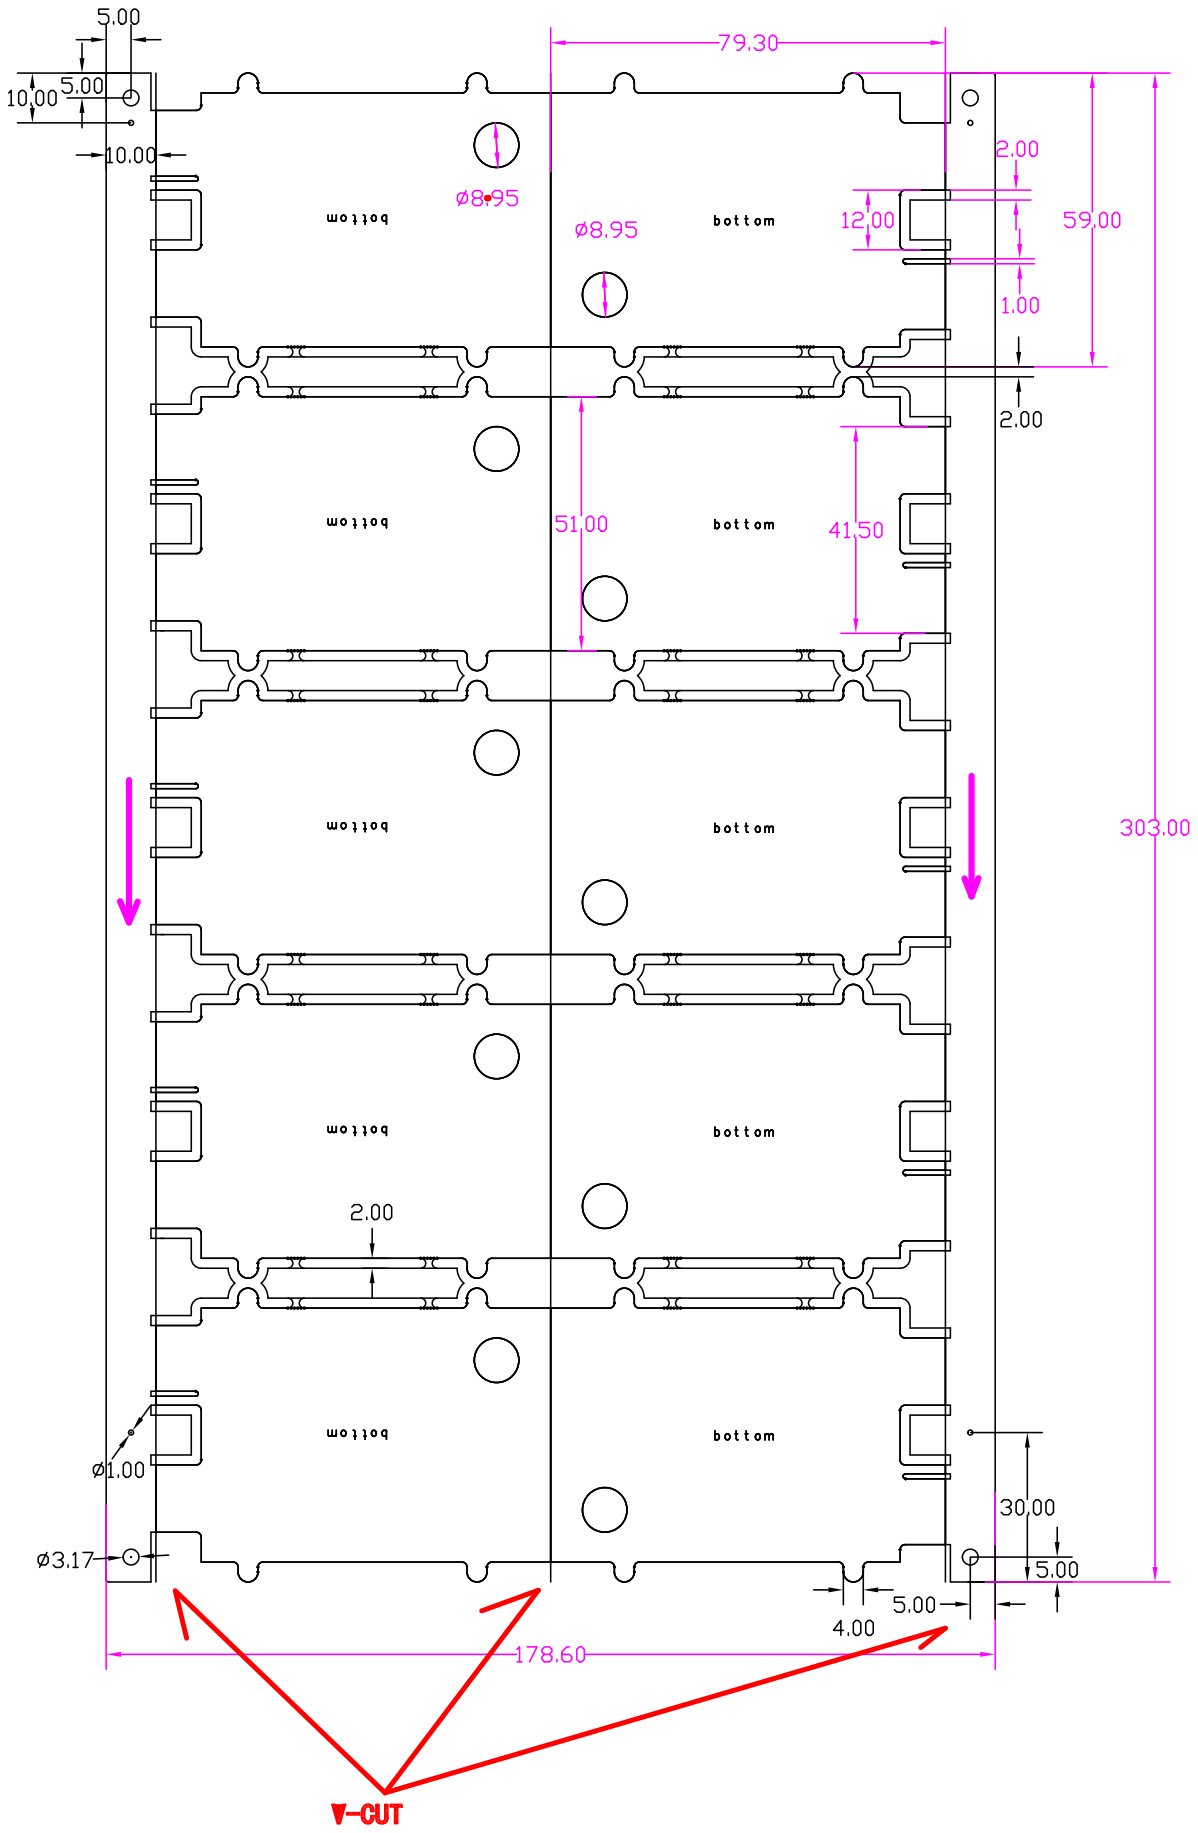
[picture p71: page 1]
