essensys-hub/essensys-board-SC945D/SC945D/Gerbers/Panel/_Archives/EQ3bis for SI945D reviewed.pdf

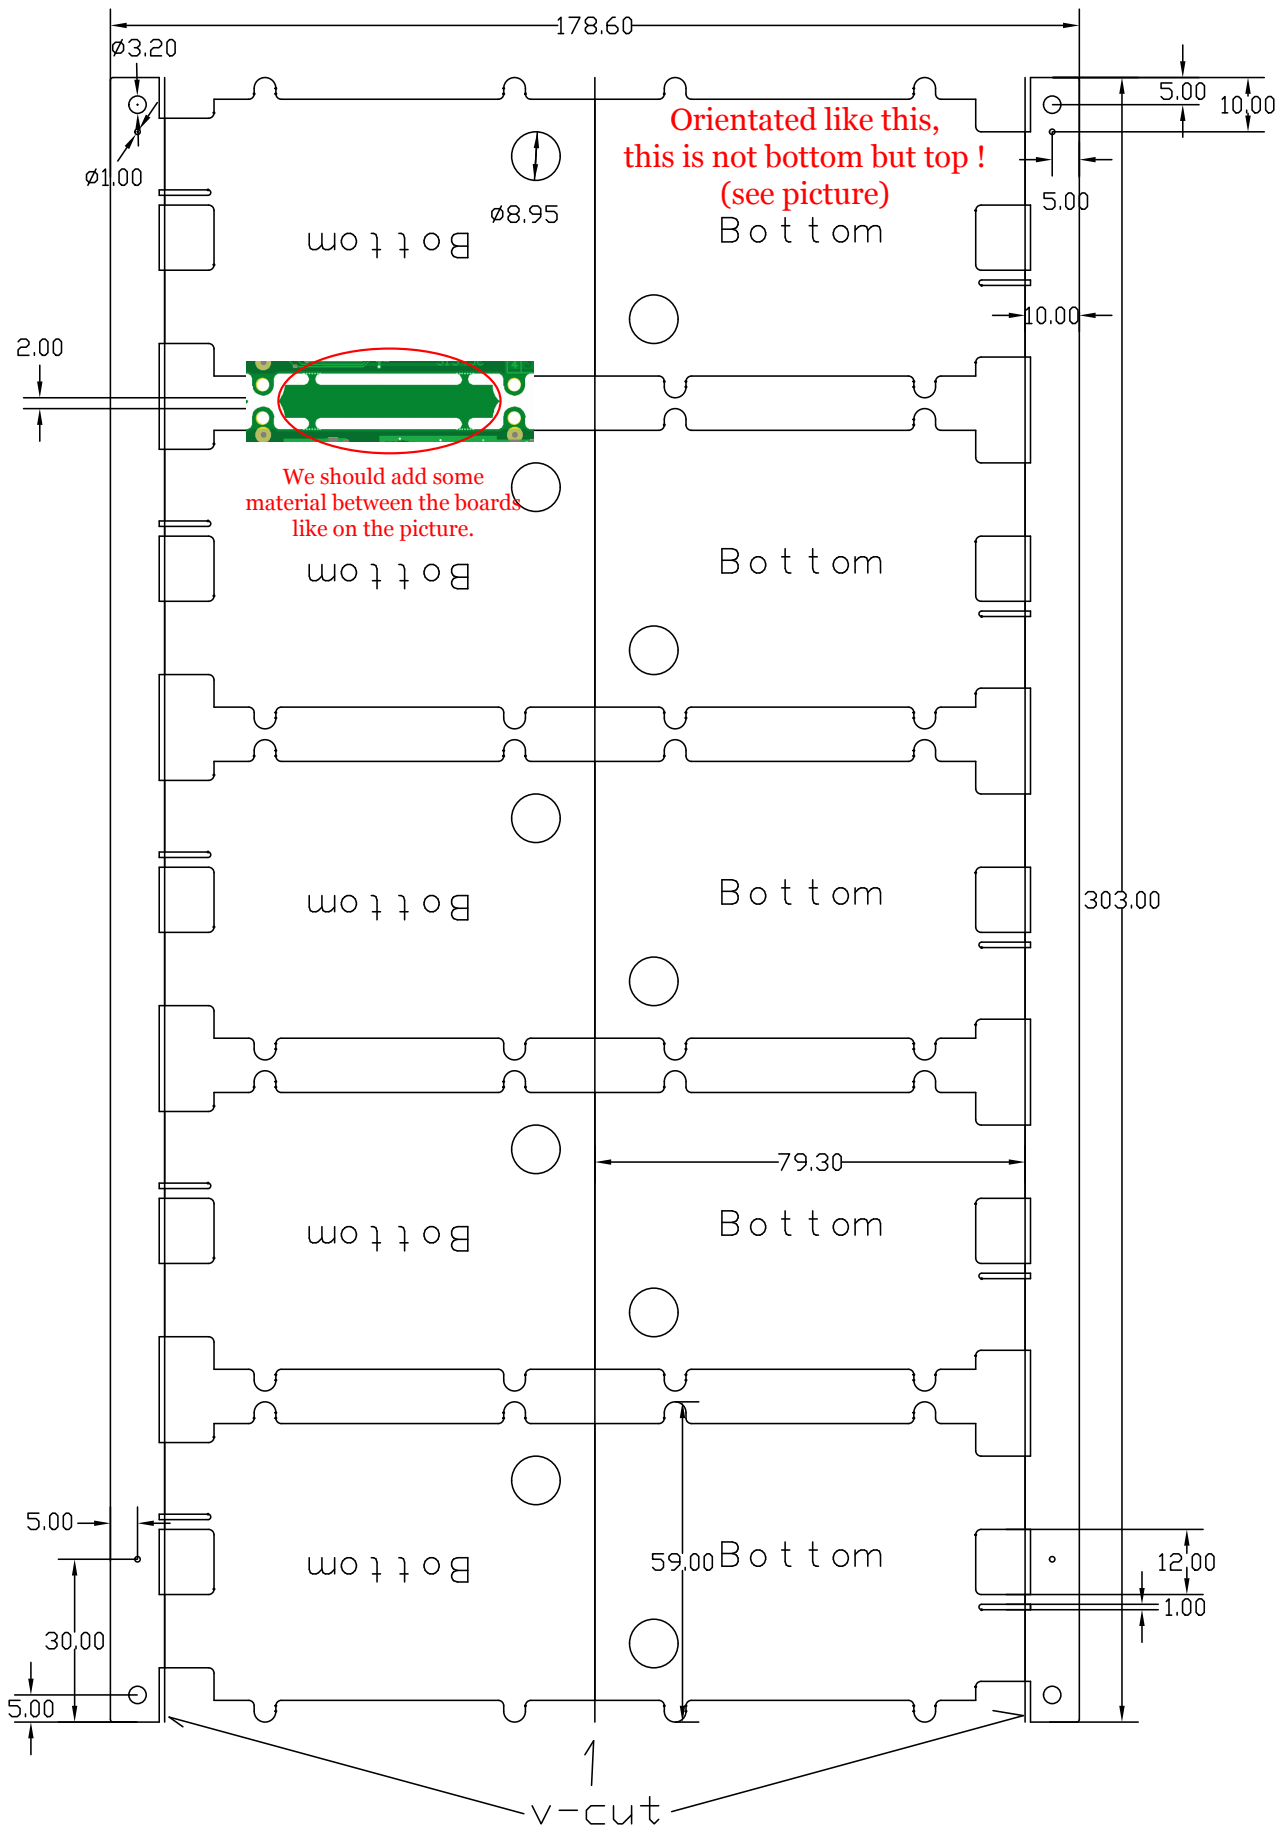
[picture p74: page 1]
