essensys-hub/essensys-board-SC945D/(list of files, drawings)

Other design files:
SC945D/SC945D.PrjPcb
SC945D/SC945D_Afficheur.SchDoc
SC945D/SC945D_Alimentations.SchDoc
SC945D/SC945D_Audio.SchDoc
SC945D/SC945D_Backlight.SchDoc
SC945D/SC945D_Interface_BP_et_Prog.SchDoc
SC945D/SC945D_Micro.SchDoc
SC945D/SC945D_SD_Card.SchDoc
SC945D/SC945D_Sommaire.SchDoc
SC945D/SC945D_Touchscreen.SchDoc
