essensys-hub/essensys-board-SC945D/(commit log)

2025-12-28 docs: Update index with full schematic and assembly galleries
2025-12-28 feat: Add SC945D hardware sources, BOM and ignore build artifacts
    [1151702080.sldasm, 1151716496.sldasm, 1151716632.sldasm, 1151717312.sldasm, 1151717448.sldasm, 1151720984.sldasm, 1151725608.sldasm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]
2025-12-28 docs: Add mermaid architecture and flow diagrams to firmware logic
